ReyhaneNikoobayan/Design-Gearbox/README.md

# Designing Gearbob
The complete design of the gearbox has been accomplished in different phases throughout the machine element design 2 course, defined by [Dr. Nourani](https://sharif.ir/~nourani/) at Sharif University of Technology And it was carried out by me and my teammate Iman Shahravy.
