ReyhaneNikoobayan/Design-Gearbox/Phase 1/assignment&report/our project_gearbox.pdf

# به نام یزدان

# گزارش پروژه گیربکس )فاز اول(

## درس طراحی اجزای 2

## استاد امیرنورانی

### ریحانه نیکوبیان

### ایمان شهروی

### فهرست

طراحی چرخدنده های 1G و 3G --------------------------------------------------- 3

طراحی چرخدنده های 2G و 4G 9----------------------------------------------------

طراحی سیستم رک و پینیون14-------------------------------------------------------

طراحی چرخدنده های 5G و 6G 17----------------------------------------------------

طراحی چرخدنده های 7G و 8G 21----------------------------------------------------

تحلیل نیرویی چرخدنده ها27---------------------------------------------------------

محاسبه فاصله شفت ها 29------------------------------------------------------------

جدول جامع ویژگی های چرخدنده ها30-------------------------------------------------

روش های تثبیت چرخدنده ها در گیربکس31---------------------------------------------

انتخاب موتور الکتریکی32-------------------------------------------------------------

بررسی اتالفات موجود در پولی و چرخدنده---------------------------------------------- 34

محاسبات قیمت35-------------------------------------------------------------------

منابع37---------------------------------------------------------------------------

طراحی چرخدنده های 1G و 3G( gears spur):

فرض:1 نسبت تبدیل سیستم زنجیر و چرخ زنجیر را برابر 3.75در نظر میگیریم.)کاهنده(

ωShaft1 =3000(rpm) ×

1
3.75

=800 (rpm)

گام اول : محاسبه گشتاور
T = P
ω

→ 4kw
800×

2×π
60

= 47.73 (N.m)

* چرخدنده پینیون 1G میباشد.

Sut=700(MPa) :2 فرض

گام دوم : بدست آوردن نسبت تبدیل و انتخاب تعداد دندانه

برای شفت 2 هرگاه rpm 600=ω باشد1،G و 3G درگیر میشوند

mG =

NG
NP

=

ωP
ωG

=

800(rpm)
600(rpm)

=1.34

فرض:3 دندانه را تمام عمق فرض میکنیم.)1=K)

فرض:4 زاویه فشار را برابر 20 درجه فرض میکنیم.)20=Ø)

فرض:5 تعداد دندانه پینیون)NP )را برابر 19 در نظر میگیریم.

NG
NP

## )جلوگیری از پدیده شکارچی( 25 ≈ 24.7 = NG → 1.3 =

25
19

کمتر از 2 درصد با 1.34 فاصله دارد→ 1.315 =

گام سوم: مدول را حدس میزنیم و قطرها را محاسبه میکنیم

فرض:6 حدس اولیه برای مدول mm3=m میباشد.

m =

d
N

→ dG1 = 3×19 = 57(mm) , dG3 = 3×25 = 75(mm)

V = r×ω = ⁰.057
2

× 800 × ²×π
60

= 2.387(m/s)

فرض:7 از تراش هاب برای تولید چرخدنده استفاده شده است.

*KV را با توجه به سرعت تعیین میکنیم

3.56+√V
3.56

KV =

KV =

3.56+√2.387
3.56

→KV = 1.433

8<X<12 →
فرض:8 X را برابر 10 در نظر میگیریم.

F = X × m → F = 10×3 = 30 (mm)

گام چهارم:G)FS (را بدست میاوریم و J( ضریب هندسی( را تعیین میکنیم.

فرض:9 2=FS

فرض:10موتور الکتریکی را یونیفرم و مونتاژ را متوسط در نظر میگیریم.

(FS)G = (FS)×(Km)×(KO) →

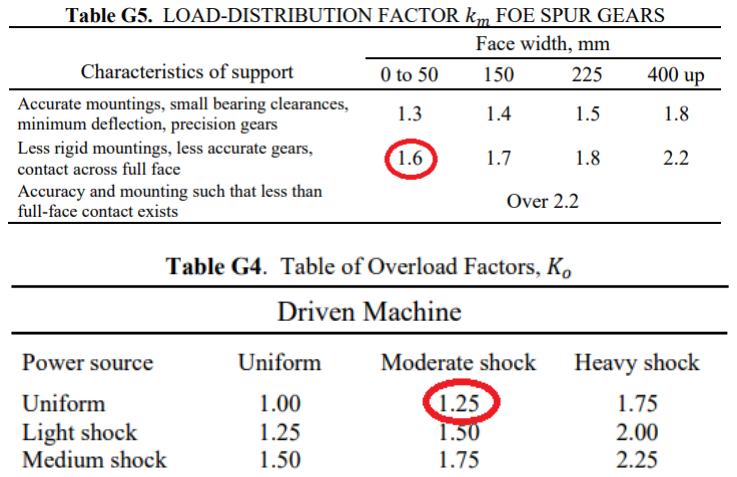
[picture p1: figure]

Km = 1.6 , Ko = 1.25 → (FS)G = 2×1.6×1.25 = 4

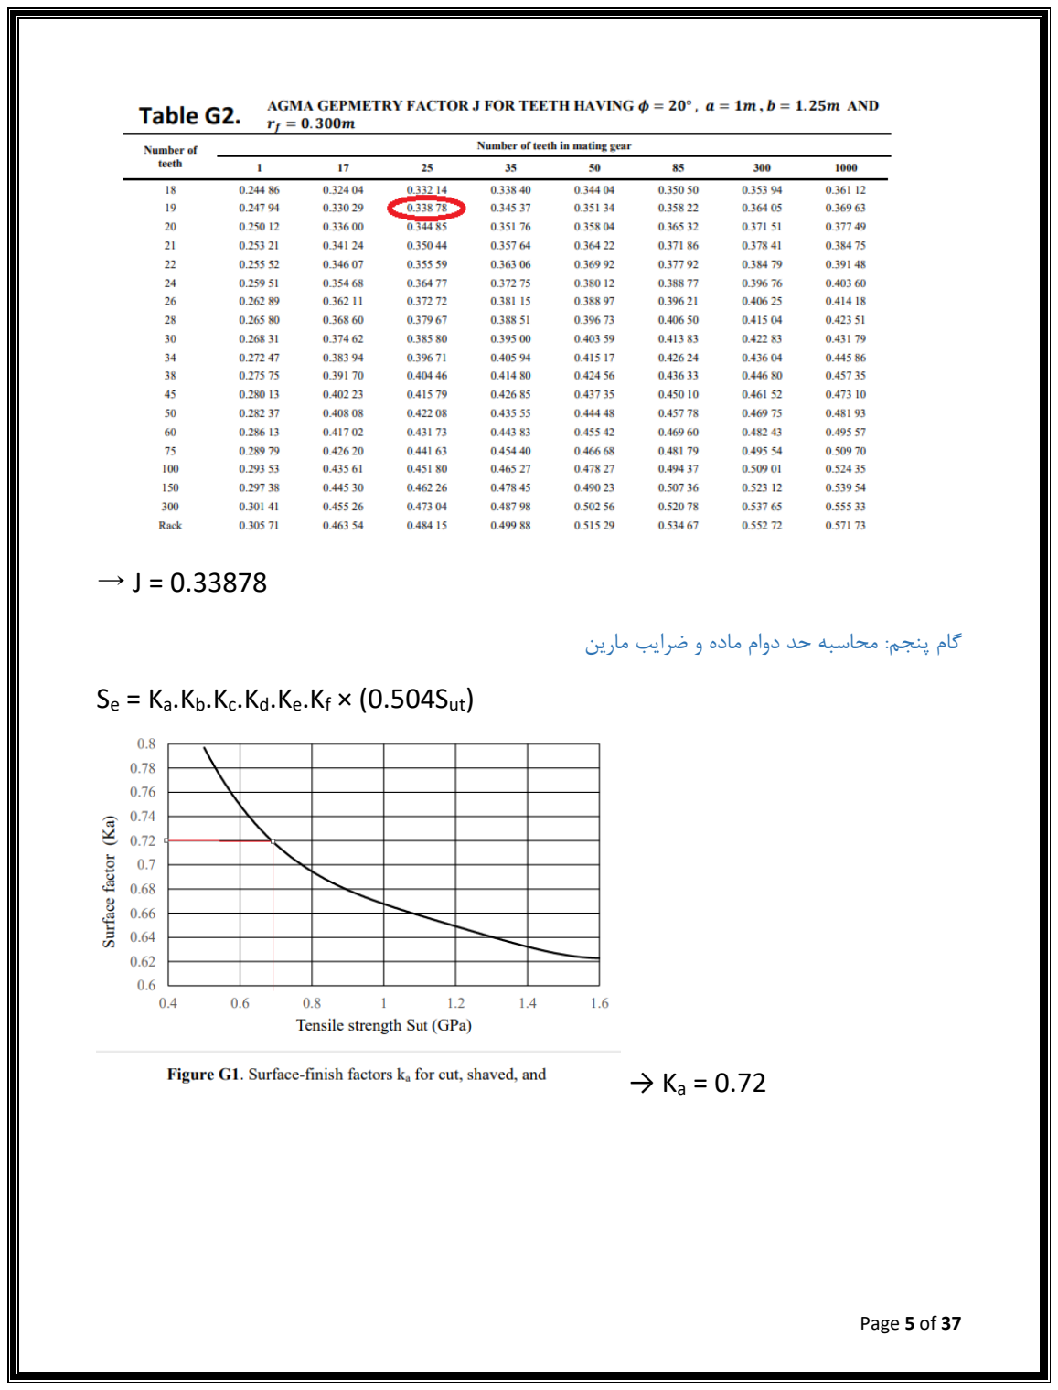
[picture p2: page 5]

→ J = 0.33878

گام پنجم: محاسبه حد دوام ماده و ضرایب مارین

Se = Ka.Kb.Kc.Kd.Ke.Kf × (0.504Sut)

→ Ka = 0.72

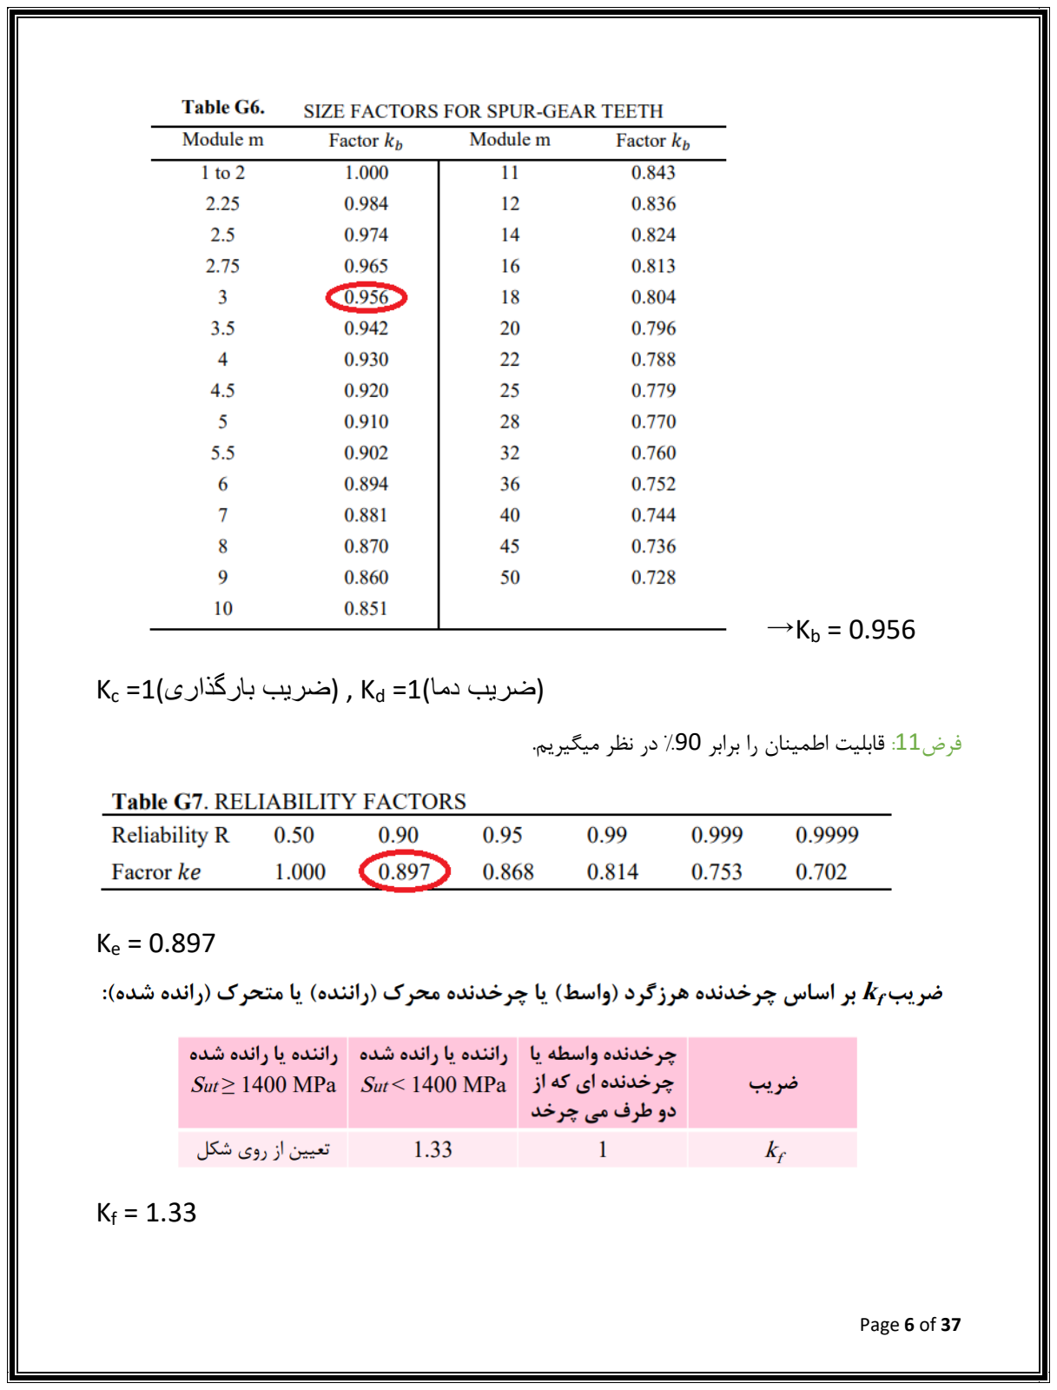
[picture p3: page 6]

→Kb = 0.956

(ضریب دما)1= Kd ,) ضریب بارگذاری)1= Kc

فرض:11 قابلیت اطمینان را برابر %90 در نظر میگیریم.

Ke = 0.897

Kf = 1.33

Se = 0.72×0.956×1×1×0.897×1.33×(0.504×700(Mpa)) = 289.7 (MPa)

گام ششم: تعیین مدول چرخدنده ساده بر اساس رابطه اول دورعلی برای ممان خمشی

m =√
2×1.433×4×47.73
289.7×19×0.33878×10

3
= 2.88(mm)

*با مدولی که حدس زدیم)3=m)،کمتر از 10 درصد تفاوت دارد پس قابل قبول است.

گام هفتم: تعیین مدول چرخدنده ساده بر اساس رابطه دوم دورعلی بر اساس تنش سطحی

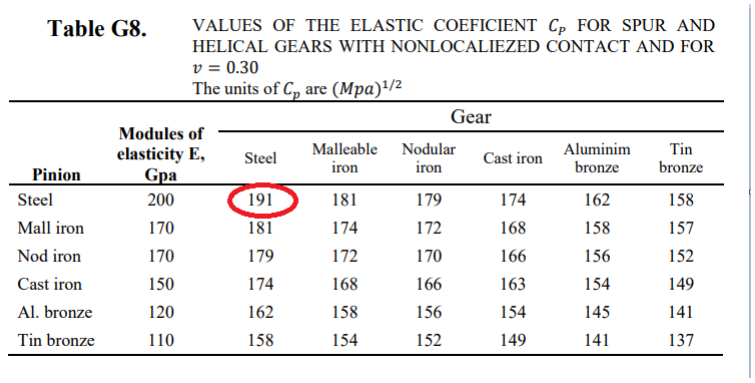
[picture p4: figure]

→ Cp = 191(√MPa)

`

→ I = 0.09

فرض:12سطح چرخدنده را در کارگاه تا 400=HB سخت میکنیم.

Ses’ = 2.75×HB – 70 = 1030

15(years) × 280(days) × 12(hours) × (60 min) × (800rpm) = 24.2×10^8 >(10^8)→

( ضریب نسبت سختی)1=CH , ) ضریب دما)1=CT , 1=CL

CR=0.8

Ses =

CLCH
CTCR

×Ses =

1030
0.8

=1287.5(MPa)

m = √
191²×2×1.433×4×47.73
1287.5

210⁶×10×19²×0.09

3
= 3.02(mm)

با مدول حدس زده شده کمتر از 10 درصد اختالف دارد و بنابراین قابل قبول است.

*پس مدول (mm(3=m برای چرخدنده های 1G و 3G انتخاب میشود.

طراحی چرخدنده های 2G و 4G) gears Helical (:

گام اول: محاسبه توان
T = P
ω

=

3.5(kw)
1000(rpm)×

2×π
60

= 33.41 (N.m)

فرض:1 زاویه فشار را برابر 20 درجه و زاویه هلیکس را برابر 13 درجه در نظر میگیریم.

( øn = 20,ψ =13 )

tan(øt) = tan(øn)
cos(ψ)

→ øt = 20.5

گام دوم: نسبت تبدیل را بدست اورده و تعداد دندانه ها را تعیین میکنیم.

ω4
ω2

=

1000(rpm)
800(rpm)

=

N2
N4

=mG = 1.25

قابل قبول 1.238 = mG) → جلوگریی از پدیده شکار چ) 24 = 2N → 19 = Np = 4N

گام سوم: حدس مدول

مدول را برابر mm3 در نظر میگیریم.

mn =3 → m =

mn
cos(ψ)

= 3.078

* در قسمت قبیل برای دو چرخدنده ساده دیدیم که (mm(66=

d1+d3
2

و در این قسمت داریم:

d2 = N2 × mn = 24 × 3.078 = 73.872 (mm)

d4 = N4 × mn = 19 × 3.078 = 58.482 (mm)

d2+d4
2

= 66.18 (mm)

بنابر این فاصله دو شفت را برابر (mm(66 در نظر میگیریم و در حالت دوم تنها mm 0.18 تفاوت داریم که قابل چشم پوشی میباشد:

V = r × ω → (

58.482
2

) × 1000 × ²×π
60

= 3.062 (m
s

)

Kv = 1.5

گام چهارم: G)FS (را بدست میاوریم.

فرض:2 موتورالکتریکی را یونیفرم و مونتاژ چرخدنده هلیکال را متوسط در نظر میگیریم.

Ko = 1.25

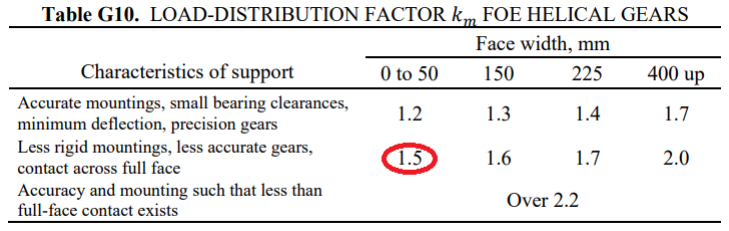
[picture p5: figure]

Km = 1.5

فرض:3 ضریب طراحی را برابر 2.5 در نظر میگیریم. (2.5=FS(

فرض:4 قابلیت اطمینان را 90 درصد در نظر میگیریم.

فرض:5 8=X را در نظر میگیریم.

(FS)G = (FS) ×(Km) × (Ko) =4.7

گام پنجم: استحکام حد دوام و ضرایب مارین را بدست میاوریم.

Se = Ka.Kb.Kc.Kd.Ke.Kf ×(0.504×Sut) → Ka = 0.72 , Kb =0.956 , Kc = 1 , Kd = 1 , Ke =0.897

Kf = 1.33

Se = 0.72×0.956×1×1×0.897×1.33×0.504×700(Mpa) = 289.71 (MPa)

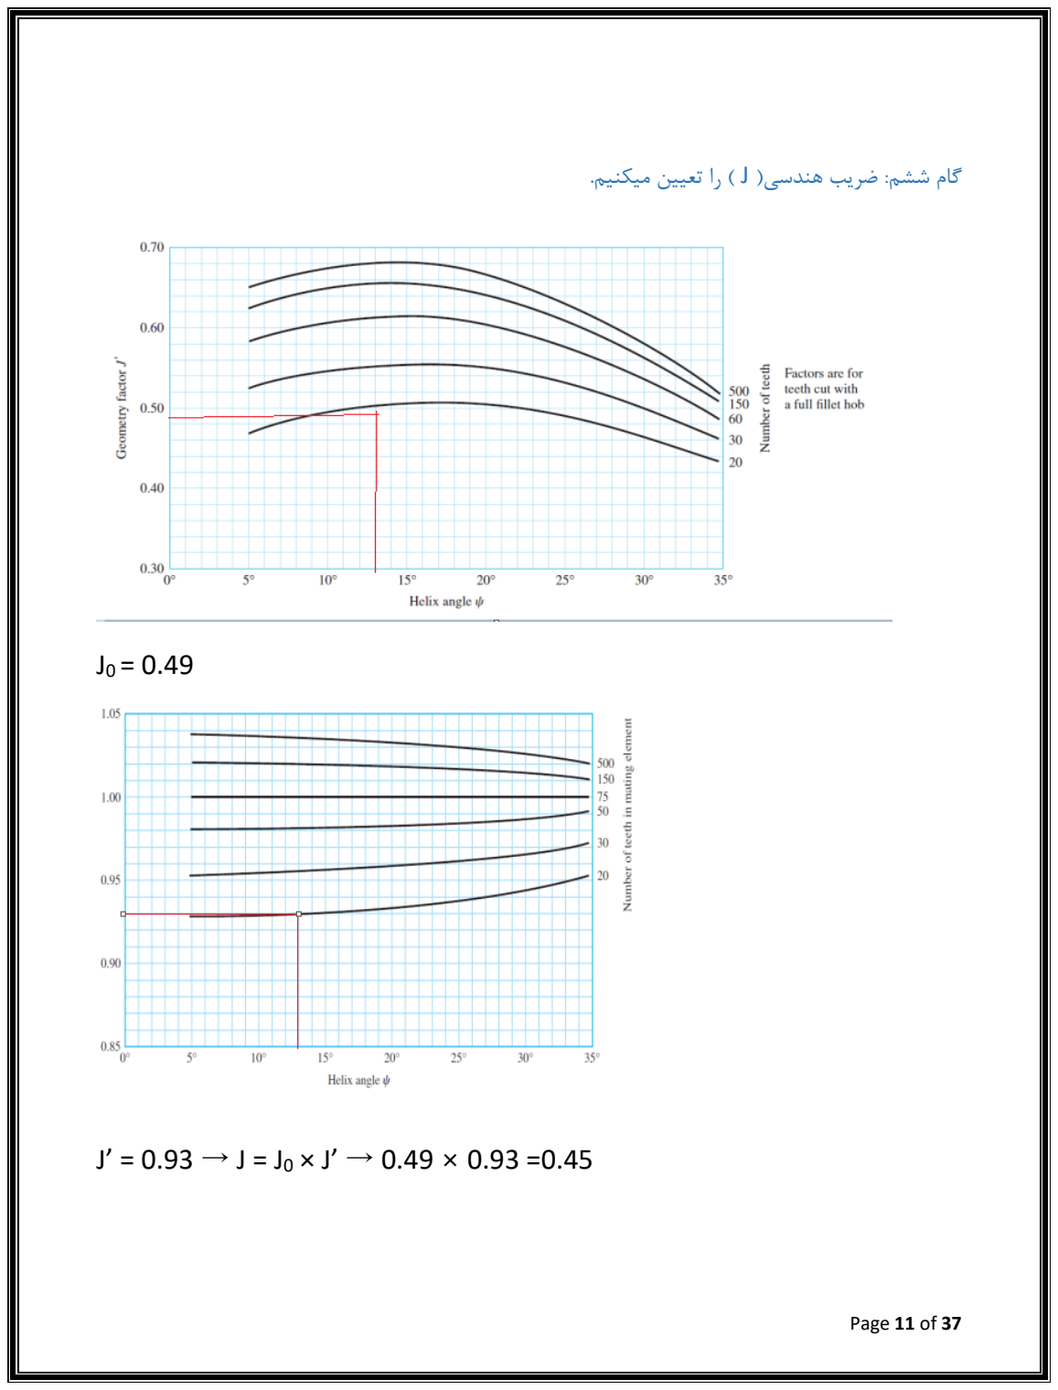
[picture p6: page 11]

گام ششم: ضریب هندسی) J ) را تعیین میکنیم.

J0 = 0.49

J’ = 0.93 → J = J0 × J’ → 0.49 × 0.93 =0.45

گام هفتم: تعیین مدول چرخدنده هلیکال بر اساس ممان خمشی)رابطه سوم دورعلی(

√
2×1.5×4.7×33.41×cos(13)

3
289.71×10⁶×19×0.45×8

3
→ mn = 2.81

کمتر از 10 درصد با مدولی که حدس زدیم فاصله دارد (3 = mn (بنابراین قابل قبول است.

گام هشتم: تعیین مدول چرخدنده هلیکال بر اساس تنش سطحی)رابطه چهارم دورعلی(

Cp = 191 √MPa

Z = mn×{√(
Np
2cosψ + 1)

2 − (

Np×cosøt
2×cosψ )

2

2

+ √(
NG
2cosψ + 1)

2 − (

NG×cosøt
2×cosψ )

2

2
–(

Np+NG
2

) ×

sinøt
cosψ}

Z = {5.67 + 6.65 – 7.72} × mn = 4.6 mn

mN =

π×cos(øn)
0.95×4.6

رعایت شد 1 > mN → 0.67=

I = cos(øt

)×sin(øt)
2×mN

×

mG
mG+1

= 0.136

فرض:6 سطح را تا 400=HB سخت کاری کرده ایم.

2.75×HB -70 = Ses’ = 1030(MPa)

CL = 1 , CH = 1 , CT = 1 , CR = 0.8

CLCH
CTCR

× Ses’ = Ses = 1287.5 (MPa)

mn = √
191²×2×1.5×4.7×33.41×cosψ³ 1287.5

2×10⁶×8×19²×0.136

3
= 2.92 (mm)

مدولی که حدس زدیم برابر (mm (3 بود و بنابراین کمتر از 10 درصد اختالف دارند و قابل قبول است.

طراحی سیستم رک و پینیون:

فرض:1 سرعت رک را برابر 20

cm
s

در نظر میگیریم.

Vrack = r×ω = 0.2 (m
s

)

فرض:2 دندانه تمام عمق و زاویه فشار برابر 20 درجه است.(1=K , 20 = ø(

*کوچکترین پینیونی که میتواند با یک شانه بدون تداخل کارکند:

2
sin(20)

2

=17.1 → NP = 18

فرض:3 مدول را برابر (mm(3.5 فرض میکنیم.

d = m×Np = 5×18=63(mm)

ω =

V
r

=

0.2
0.0315

= 6.34 (

rad
s

)

T = P
ω

=

500
6.34

= 78.75 (N.m)

فرض:4 از تراش هاب استفاده میکنیم.

Kv =

3.56+ √0.2

2

3.56

= 1.125(m
s

)

فرض:5 2=FS

فرض:6 موتور الکتریکی را یونیفرم و مونتاژ را متوسط در نظر میگیریم.

FS =2 , Ko = 1.25 , Km = 1.6 → (FS)G = 4

فرض:7 10=X

X = 10 , m=3.5 → F = X.m →F = 35 (mm)

فرض:8 قابلیت اطمینان را برابر %90 در نظر میگیریم.

تعیین ضرایب مارین همانند دو چرخدنده ساده اولیه میباشد: )تنها Kb متفاوت است(

Ka = 0.72 , Kb = 0.942 , Kc =1 ,Kd =1 , Ke =0.897 , Kf =1.33

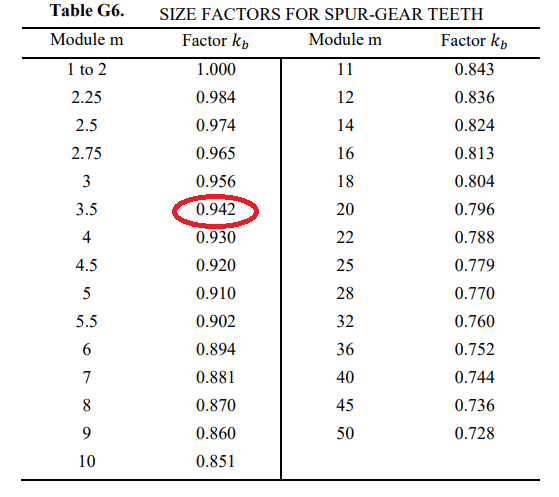
[picture p7: figure]

Se’ = 0.504 × Sut = 352.8(MPa)

Se = ka.kb.kc.kd.ke.kf × (352.8) = 285.46 (MPa)

*تعیین مدول بر اساس ممان خمشی)رابطه اول دورعلی(:

√
2×1.125×4×78.75
285.46×18×0.37×10

3
= 3.34 (mm)

*کمتر از ده درصد اختالف با مدولی که حدس زدیم ((mm(3.5=m (بنابراین مدول 3.5 قابل قبول است.

*تعیین مدول بر اساس تنش سطحی )رابطه دوم دورعلی(:

*سختی سطح را برابر 300=HB در نظر میگیریم.

Ses’ = 2.75 × 300 -70 = 755 (MPa)

Cp = 191 (√MPa)

CL = 1 , CT = 1 ,CH = 1, CR = 0.8

Ses =

CL×CH
CT×CR

=

755
0.8

= 943.75 (MPa)

I = cosøsinø
2

×

mG
mG+1

= 0.191

m = √
191²×2×1.25×4×78.75
943.75²× 10⁶×10×18²×0.191

3
= 3.61(mm)

کمتر از 10 درصد با مدولی که حدس زدیم (mm(3.5 تفاوت دارد و قابل قبول است.

طراحی چرخدنده های 5Gو 6G) Gears Helical (:

گام اول: محاسبه توان

T = P
ω

→

500
600×

2×π
60

=7.96 (N.m)

فرض:1 زاویه فشار را برابر 20 درجه و زاویه هلیکس را برابر 13 درجه در نظر میگیریم.

( øn = 20,ψ =13 )

tan (øt) = tan øn
cos ψ

→ øt = 20.5

فرض:2 نسبت تبدیل سیستم پولی و تسمه را برابر 4 در نظر میگیریم.)از نوع کاهنده( خروجی سیستم پولی متصل به پینیون در سیستم رک و پینیون بوده که ω آن مشخص است. به همین ترتیب میتوانیم ω ورودی که همان 6ω میباشد را تعیین کنیم.

ωp1

ωp2

= 4 → ωp2

= 6.34 rad
s

×

60
2×π

= 60.54 rpm → ωp1
= 242.16 (rpm)

ωG5

= ωsℎaft2 = 600 (rpm)

گام دوم: نسبت تبدیل را بدست اورده و تعداد دندانه ها را تعیین میکنیم.

mG =

ω5
ω6

≈ 2.5

= mG→ جلوگیری از پدیده شکارچی 48 = NG , 19 =Np

NG
NP

= 2.52

گام سوم: حدس مدول

مدول را برابر (mm (1.5 فرض میکنیم.

mn =1.5 → m =

mn
cosψ = 1.54

dp = 29.26 (mm) , dG = 73.92 (mm)

V = r×ω → =

29.26
2

× 600 × ²×π
60

= 0.919 (m
s

)

Kv =

3.56+ √0.919 ²

3.56

= 1.27

گام چهارم G)FS(: را بدست میاوریم.

فرض:3 موتورالکتریکی را یونیفرم و مونتاژ چرخدنده هلیکال را متوسط در نظر میگیریم.

فرض:4 ضریب طراحی را برابر 2 فرض میکنیم.

Ko = 1.25 , Km =1.5 , FS =2 → (FS)G = 1.25×1.5×2 = 3.75

فرض:5 9=X

F = X×m = 13.5(mm)

گام پنجم: استحکام حد دوام و ضرایب مارین را بدست میاوریم.

Se = Ka.Kb.Kc.Kd.Ke.Kf ×(0.504×Sut) → Ka = 0.72 , Kb =0.956 , Kc = 1 , Kd = 1 , Ke =0.897

Kf = 1.33

Se = 0.72×1×1×1×0.897×1.33×0.504×700(Mpa) = 303 (MPa)

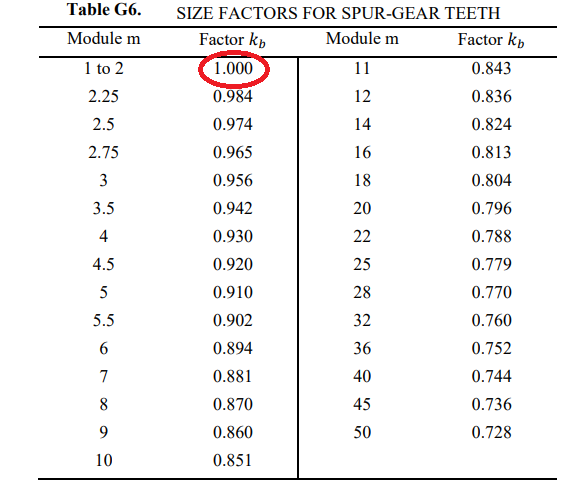
[picture p8: figure]
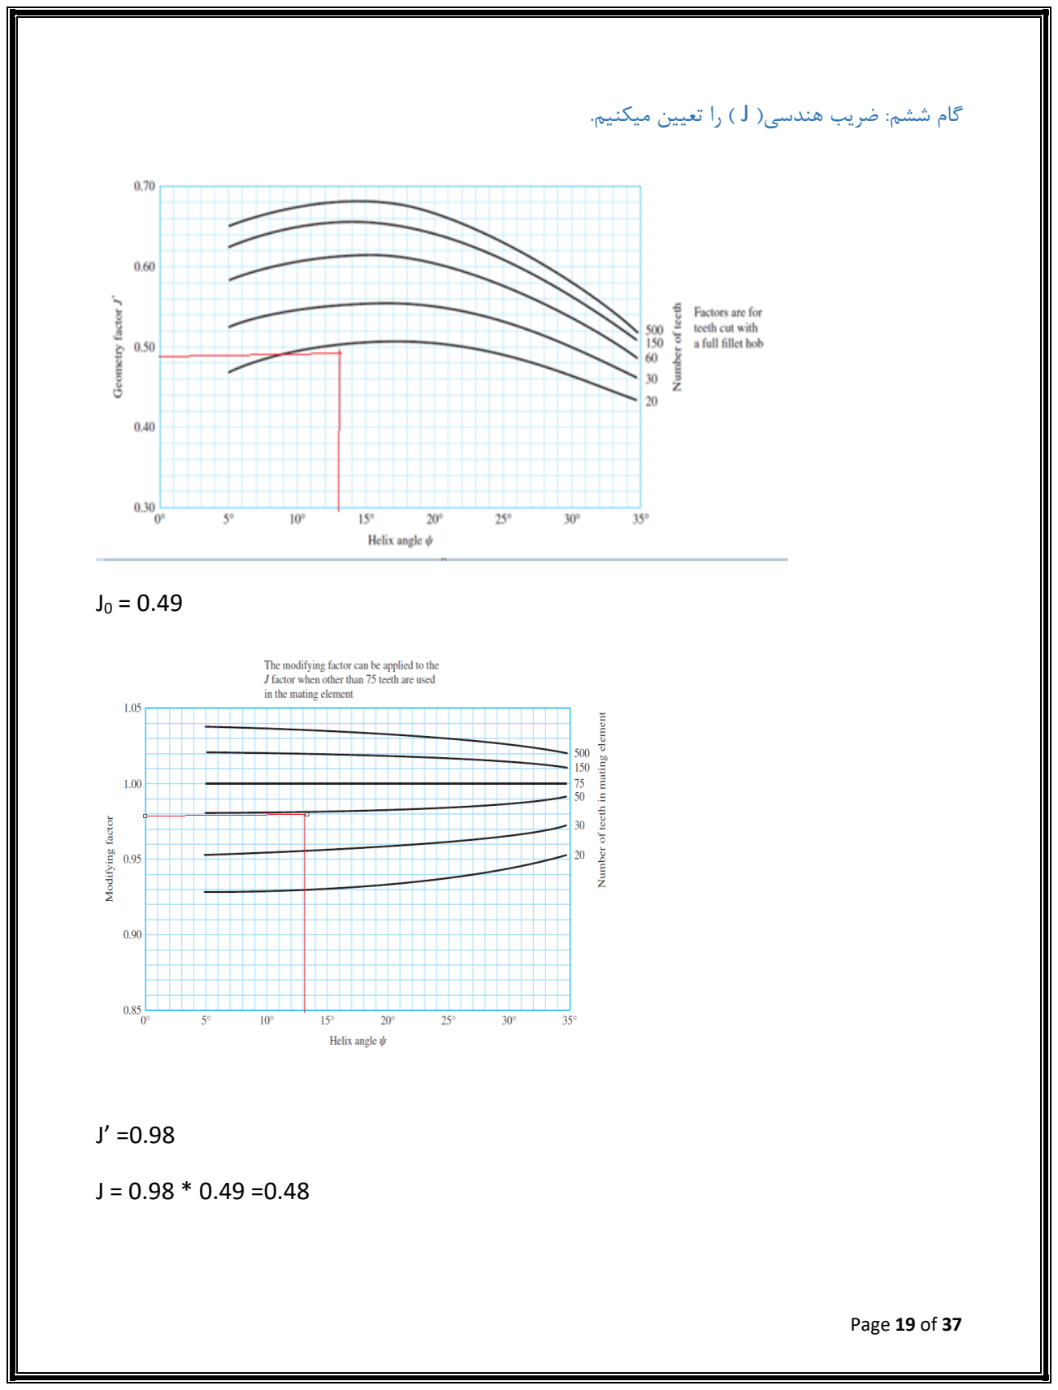
[picture p9: page 19]

گام ششم: ضریب هندسی) J ) را تعیین میکنیم.

J0 = 0.49

J’ =0.98

J = 0.98 * 0.49 =0.48

گام هفتم: تع
ش | یری مدول چرخدنده هلیکال
بر اساس ممان خم )رابطه سوم دورعیل(

√
2×1.27×3.75×7.96×cos13³
303×10⁶×19×0.48×9

3
کمتر از ده درصد تفاوت با مدولی که حدس زدیم→ (mm(1.41=

گام هشتم: تع
یری مدول چرخدنده هلیکال بر اساس تنش سطیح)رابطه چهارم دورعیل(

Cp = 191 √MPa

Z = {5.67 + 11.16 – 12.04} × mn = 4.79 mn

mN =

π×cos(øn)
0.95×4.79

=0.646

I = cosøt×sinøt
2×mn

×

mG
mG+1

= 0.117

فرض:6 سطح را تا 400=HB سخت کاری کرده ایم.

2.75×HB -70 = Ses’ = 1030(MPa)

CL = 1 , CH = 1 , CT = 1 , CR = 0.8 √
191²×2×1.27×3.75×7.96×cso13³ 1287.5

2×10⁶×9×19²×0.117

3
=1.47 →≈ 1.5 (mm)

CLCH
CTCR

× Ses’ = Ses =1287.5 (MPa)

طرایح چرخدنده های 7G و 8G) gears Bevel (:

گام اول: محاسبه گشتاور

T = P
ω

→

7kw
800×

2×π
60

= 83.55(N.m)

گام دوم: حدس مدول چرخدنده

مدول را برابر (mm(4 = m در نظر میگیریم

گام سوم: محاسبه قطر پینیون و گیر

فرض:1 تعداد دندانه پینیون را برابر 19 در نظر میگیریم.

mG =

ωG8

ωG7

=

800(rpm)
120(rpm)

= 6.67

NP =19 → NG = 19 × 6.67 ≈ 127

dp = 19 × 4 = 76 (mm) , dG = 127 × 4 = 508 (mm)

گام چهارم: محاسبه عرض چرخدنده

F = min[0.3A0 , 10m ]

10m = 10 × 4 = 40 (mm)

γ = tan⁻¹

(

NP
NG

) = 8.5° → Γ = 90 – γ = 90 – 8.5 =81.5°

A0 =

dp
2sinγ =

76
2 sin 8.5°

=257 (mm)

F = min [ 0.3×257 , 40] = 40 (mm)

گام پنجم: محاسبه حد دوام ماده

فرض:2 Sut را برابر MPa700 در نظر میگیریم.

محاسبه ضرایب مارین:

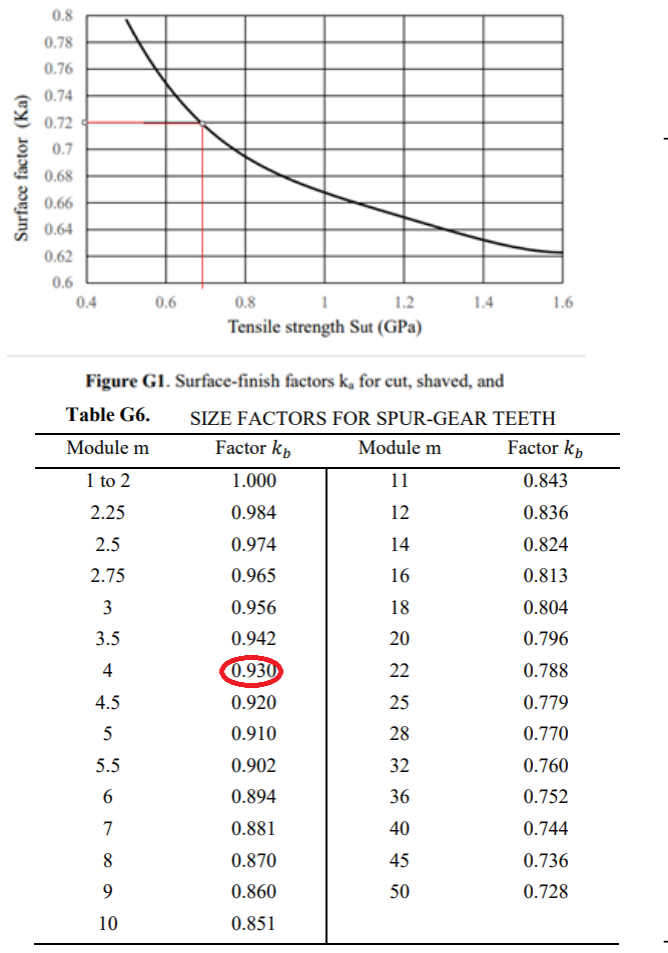
[picture p10: figure]

→ Ka = 0.72

→ Kb = 0.93

(ضرایب دما و بارگذاری) 1= Kd = Kc

فرض:3 قابلیت اطمینان را برابر %90 در نظر میگیریم

Ke = 0.897

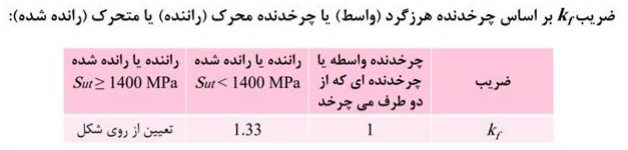
[picture p11: figure]

Kf = 1.33

Se = Ka.Kb.Kc.Kd.Ke.Kf ×(0.504×Sut) = 0.72×0.93×1×1×0.897×1.33×(0.504×700) = 281.83 (MPa)

گام ششم: به دست آوردن V و Kv و نیروي مماسی چرخدنده
V = dP
2

× ω = 0.038 × 800 × ²π
60

= 3.18 (m
s

)

فرض :4 چرخدنده با روش تراش هاب تولید شده است.

Kv =

3.56+ √3.18
3.56

= 1.5

T = Wt ×

dP
2

→ 83.55 = Wt × 0.038 → Wt = 2198.7 N

گام هفتم: تعیین ضریب ایمنی با توجه به وضعیت نصب، کارکرد و ضریب طراحی موردنیاز

فرض:5 (2= FS)

فرض:6 موتور الکتریکی را یونیفرم و مونتاژ را متوسط در نظر میگیریم.

Ko = 1.25 , Km = 1.3

(FS)G = Ko × Km × FS → (FS)G = 1.25×1.3×2= 3.25

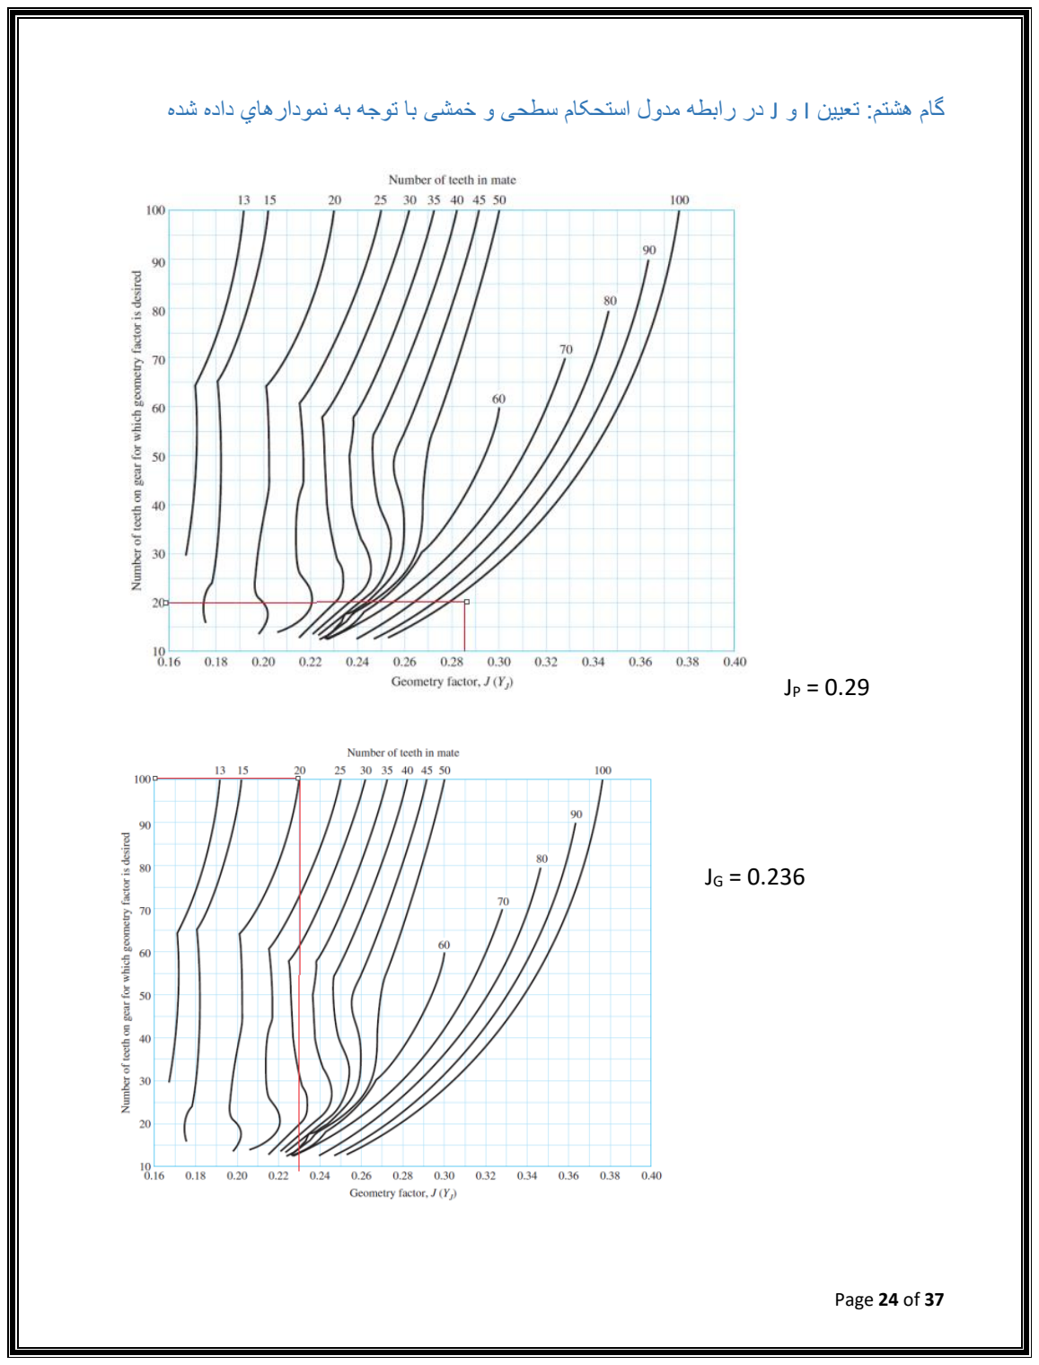
[picture p12: page 24]

گام هشتم: تعیین I و J در رابطه مدول استحکام سطحی و خمشی با توجه به نمودارهاي داده شده

JP = 0.29

JG = 0.236

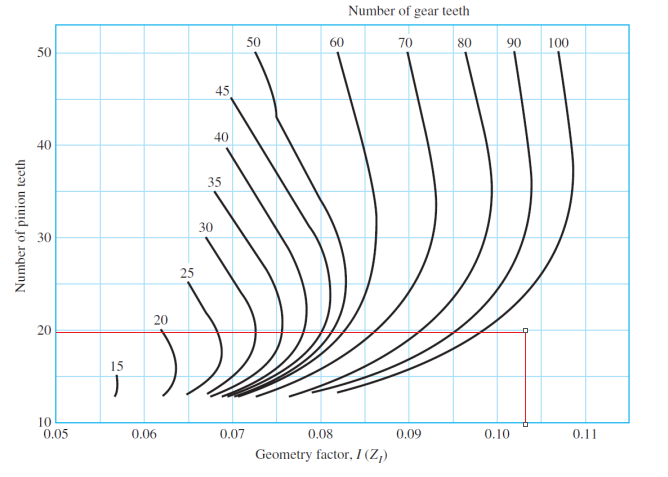
[picture p13: figure]

I = 0.104

*چون نمودار برای دندانه های گیر عدد بیشتر از 100 را شامل نمیشود،به صورت تقریبی همان حوالی 100 را در نظر گرفته ایم.

گام نهم: محاسبه Cp و به دست آوردن CL و CR از روي جدول ها و در نهایت محاسبه Ses

فرض:6 سطح را تا 300=HB سخت کاری کرده ایم.

CL = CT = CH =1 , CR =0.8

Ses’ = 2.75× 300 -70 =755 → Ses = Ses’ × 1×1
1×0.8

= 944 (MPa)

گام دهم: محاسبه ضریب ایمنی چرخدندهها و مقایسه مقدار به دست آمده با مقدار انتخابی در گام هفتم

ضریب ایمنی خمشی برای پینیون:

281.83 =

1.5×2198.7×(FS)×1.5×1.3
40×0.29×4

→ (FS)P = 2.44>2 ok

ضریب ایمنی خمشی برای گیر:

(FS)G =

JG
JP

× (FS)P = 2.03>2 ok

خستگی سطحی:

944=191× √
2198.7×(F.S)×1.5×1.3
1.5×40×76×0.104

→2.7>2 ok

تحلیل نیروهای وارد بر چرخدنده ها:

چرخدنده های 1G و 3G :

Wt =

60×10³×H

πdn

=

60×10³×4

π×800×57

= 1.67 (kN)

Wr = Wt × tan(ø) → ø = 20° → Wt = 609 (N)

چرخدنده های 2G و 4G :

Wt =

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
3500
800×

2π
60
73.872
2

= 1.13 (kN)

øn=20° , ψ =13° → øt=20.5°

-13 = ψ) → چپ گرد) 4G , 13 =ψ) → راست گرد) 2G

Wr = Wt tan(øt) = 422 (N)

Wa = Wt tan(ψ) = 261 (N)
چرخدنده های 5Gو 6G:

Wt =

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
600×

2π
60
28.5
2

= 558 (N)

øn=20° , ψ =13° → øt=20.5°

-13 = ψ) → چپ گرد) 6G , 13 =ψ) → راست گرد) 5G

Wr =Wt × tan (øt) = 208.7 (N)

Wa = Wt × tan(ψ) = 128.8 (N)
چرخدنده های 7G و 8G :

Wt =

Ti

ravp

= 1.882 (kN) , øn= 20° , У = 8.51°

Wrp = Wt × tan(øn) × cos (У) = 677(N)

Wap = Wt × tan(øn) × sin(У) = 101.3 (N) چرخدنده 11G :

Wt =

60×10³×H

πdn

=

60000×0.5
π×60.54×63

= 2.504 (kN) , ø =20°

Wr = Wt × tan (ø) = 911 (N)

محاسبه فاصله شافت ها:

برای دو چرخدنده 1G و 3G :

d1+d3
2

= 63 (mm)

برای دو چرخدنده 2G و 4G :

d2+d4
2

= 63.18 (mm)

بنابراین فاصله دو شفت 1و 2 را برابر (mm(63 در نظر میگریم و در حالت دوم تنها (mm(0.18 تفاوت داریم که با تقریب خوبی قابل چشم پوشی است و دو شفت موازی هستند.

برای دو چرخدنده 5Gو 6G :

d5+d6
2

= 51.6 (mm)

rG4 = 29.24(mm)
بنابراین فاصله دو شفت 2 و 3 را برابر (mm(51.6 در نظر میگیریم و چون شعاع چرخدنده چهارم بیشتر از 20 میلی متر با فاصله دو شفت اختالف دارد، تداخل و مشکلی از این نظر بوجود نمی آید.

جدول جامع ویژگی های چرخدنده ها:

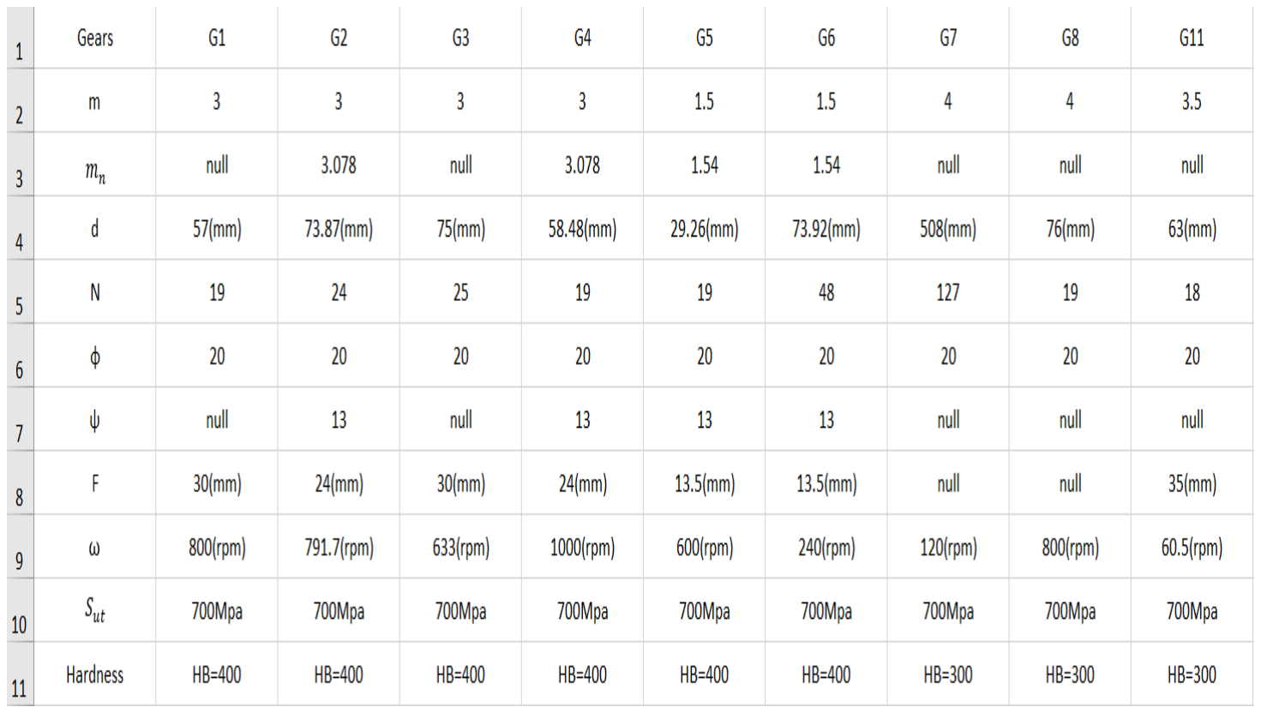
[picture p14: figure]

روشهای تثبیت چرخدنده روی شفت

برای تثبیت چرخدنده روی شفت میتوانیم از روش های متفاوتی استفاده کنیم. هر کدام از این روش ها در جای خود مفید هستند. گاهی نیاز به تثبیتی قابل تعویض داریم و گاهی میخواهیم چرخدنده را به طور دائمی روی شفت قرار بدهیم.

-1 استفاده از خار و جای خار بسیار معمول است. کمک گرفتن از پله روی شفت، بوش، خار فنری و اشپیل یا پین و واشر هم پیشنهاد میشود. همچنین اگر چرخدنده در انتهای شفت باشد میتوان از مهره و واشر یا پیچ و واشر استفاده کرد.

-2 پیچ تثبیت راهی برای تثبیت است که قابلیت تعویض چرخدنده را نیز به ما میدهد. هرچند باعث میشود عرض چرخدنده بیشتر شود و نیاز به نافی داشته باشد. می توانیم بیشتر از یک پیچ داشته باشیم که زوایای 120 درجه یا 90 درجه بین آنها پیشنهاد میشود.

-3 شرینک فیت یک راهکار دیگر برای سوار کردن چرخدنده روی شفت است. در این روش دمای چرخدنده را باال برده تا منقبض شود. این انقباض باعث بزرگتر شدن سوراخ داخل چرخدنده شده و بعد از سرد شدن و انبساط بر روی شفت تثبیت میشود .

-4 هاب چاکدار هم روشی شبیه پیچ تثبیت است. با این تفاوت که شفت ما سوراخ نمیشود و تمرکز تنش در شفت نداریم. این روش نیز نیازمند نافی بر روی چرخدنده است. میتواند یک پیچ یا بیشتر داشته باشد.

-5 همیشه این امکان هم وجود دارد که شفت و چرخدنده به صورت یکپارچه باشند. میتوانیم از متریالی با قطر بیشتر استفاده کنیم که امکان تراش چرخدنده و سپس شفت را به ما بدهد.

انتخاب موتور الکتریکی :

برای انتخاب موتور الکتریکی چند فاکتور مهم را باید در نظر بگیریم:

-1 انتخاب جنس که معموال آلومینیومی یا چدنی است.

-2 انتخاب تعداد زوج قطب های مناسب که با توجه به فرکانس برق باعث مشخص شدن دور نامی میشود.

-3 انتخاب کالس بازدهی مناسب که نسبت توان خروجی به توان نامی را تغییر میدهد.

این دستگاه قرار است در یک خط تولید یک کارخانه به کار گرفته شود. میتوانیم نتیجه بگیریم که

الف( در شرایط دمایی اندکی باالتر از دمای اتاق قرار دارد.

ب( در صورت خرابی موتور الکتریکی خط تولید تمام کارخانه متوقف میشود و به نسبت حجم کاری، ضرر گستردهای به کارخانه وارد خواهد شد. پس در صورت خرابی باید بتوانیم به سادگی موتور جدیدی را جایگزین کنیم.

انتخاب جنس

با توجه به اینکه باید از موتورهای معمول استفاده کنیم تا هم هزینهها کاهش یابد هم قابلیت تعویض در اسرع وقت را داشته باشیم، به دو جنس اصلی الکتروموتورهای معمول بازار یعنی آلومینیوم و چدن میپردازیم.

از مزایای الکتروموتور چدنی نسبت به آلومینیومی میتوان به تحمل توان های باال اشاره کرد. چدن به علت تحمل باالتری که در تحمل تنش دارد، میتواند برای تولید الکتروموتورهای پر توان بدون بروز مشکل کار کند. همچنین چدن عایق خوبی برای حرارت است و همین قضیه باعث میشود در شرایط آب و هوایی سرد به الکتروموتورهای چدنی رو بیاوریم.

در مقابل استفاده از آلومینیوم هم در شرایط دیگری پیشنهاد میشود. آلومینیوم فلزی سبک تر است و وزن موتور الکتریکی را نسبت به چدن کمتر میکند. آلومینیوم انتقال حرارت بهتری از چدن دارد و در هوای گرمتر می تواند الکتروموتور را خنک نگه داشته و به عمر آن بیافزاید.

در این دستگاه توان مورد انتظار ما متوسط است؛ پس محدودیتی از این بابت نداریم. همچنین دمای محیط کار باید مناسب کارگرها هم باشد. فلذا در دمایی متوسط هم قرار داریم. به همین منظور الکتروموتور اقتصادی تر را انتخاب میکنیم. با توجه به بررسی قیمت این دو نوع، الکتروموتور آلومینیومی قیمت پایین تری داشت و انتخاب ما برای این شرایط است.

انتخاب کالس بازدهی موتور

به علت استفاده معمولی از موتور و عدم نیاز به ضریب اطمینان باال، از موتورهایی با راندمان معمولی استفاده میکنیم. چون باید موتور الکتریکی در دسترس باشد و بعد اقتصادی را نیز باید در نظر بگیریم، از موتور های الکتریکی ساخت موتوژن تبریز استفاده میکنیم. کاتالوگ موتور های ساخت این شرکت به پیوست اضافه میشود. کالس مناسب انتخاب شده از این کاتالوگ، الکتروموتور سه فاز صنعتی تک دور با فریم آلومینیومی است. در این کالس الکتروموتور اگر توان نامی 15 کیلووات را انتخاب کنیم با توجه به بازده %88.7 توان واقعی 13.3 کیلووات را به ما ارائه میکند. این توان اندکی بیشتر از توان مورد نیاز ما در این دستگاه است. فلذا موتور 160B2L را انتخاب میکنیم.

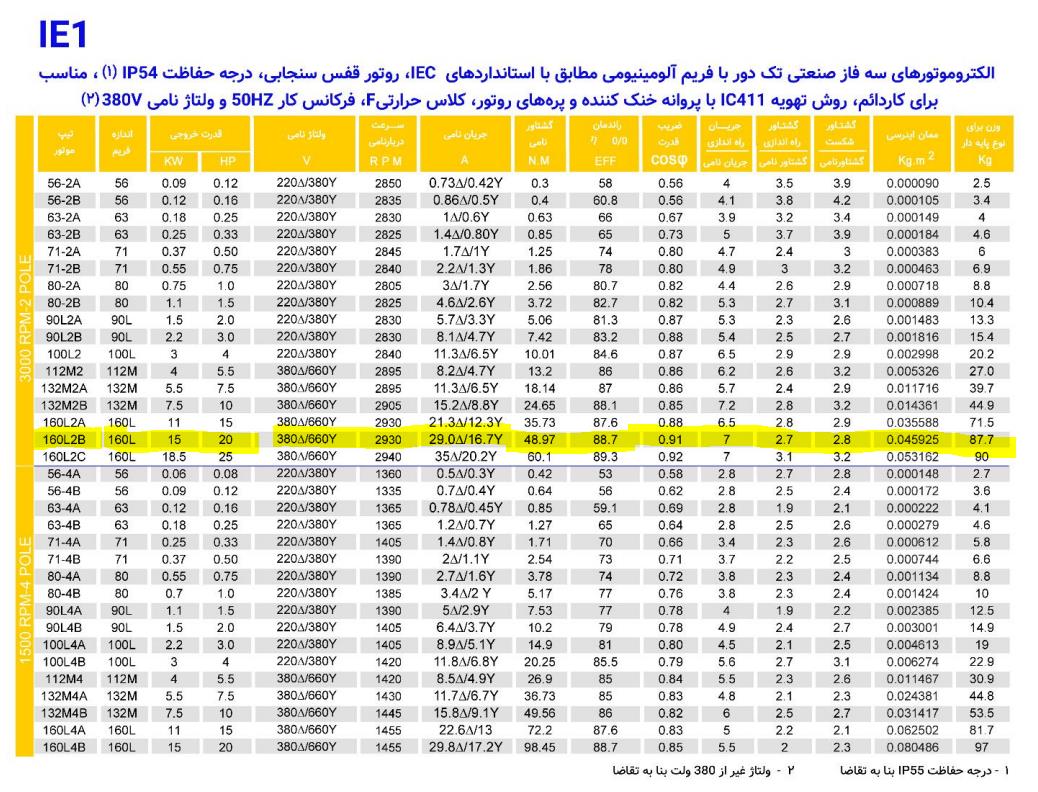
[picture p15: figure]

بررسی اتالفات موجود در پولی و چرخ زنجیر:

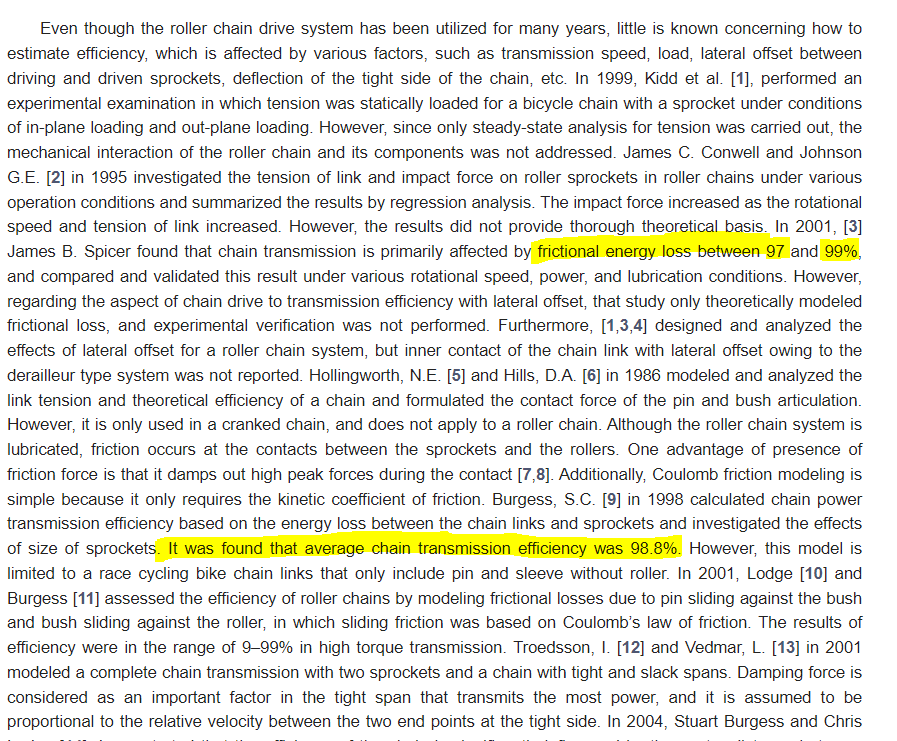
[picture p16: figure]

با توجه به مقاله باال به آدرس /876558com.mdpi.www://https بازده چرخ زنجیر را برابر 99 درصد و چون معموال بازده پولی کمتر از سیستم چرخ زنجیر میباشد و لقی در سیستم پولی و تسمه داریم، برابر 95 درصد در نظر میگیریم. بنابراین توان کل سیستم با توجه به بازده 88.7 درصدی موتور برابر میشود با:

15kW× 0.887×0.99×0.95 = 12.5 kW
در این تحلیل ما بازده چرخدنده ها را برابر 100 و بدون اتالف در نظر گرفته ایم.

محاسبات قیمت :

برای ساخت چرخدنده ها به تراش کاری با هاب و سخت کردن سطح دندانه ها نیاز داریم. طبق قیمتی که سایت خدمات سنجاق مشخص کرده این فرایند برای هر جفت چرخدنده به طور میانگین حدود 350 هزار تومان میشود که برای 5 جفت چرخدنده ما یک میلیون و هفتصد و پنجاه هزار تومان هزینه دارد.

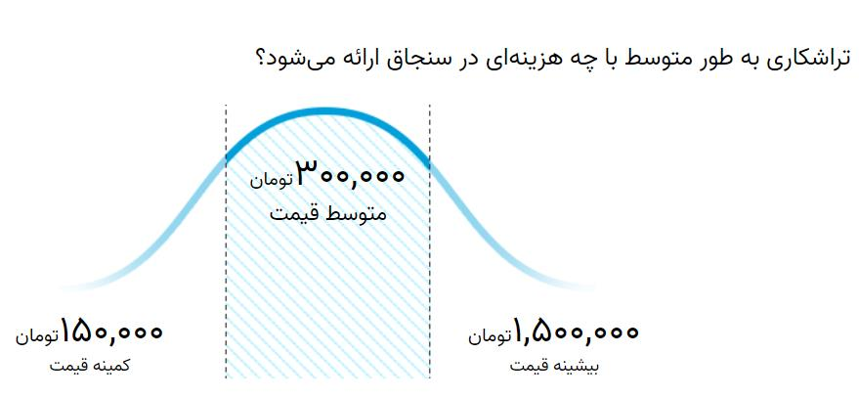
[picture p17: figure]

برای ساخت چرخدنده ها از فوالد 150VCN یزد استفاده میکنیم که به صورت استوانه ای و در قطر های مختلف در بازار موجود است. با توجه به عرض دندانه ها، مجموع عرض دندانه های چرخدنده های ما بجز 7G که قطر بسیار بزرگی دارد، کمتر از (mm(300 میشود که همان 300 را در نظر میگیریم. بنابر این قطر

استوانه برابر (mm(100 و طول استوانه (mm(300 میباشد.

V = π

d

2

4

× h = 0.002356 (m³
)
k | چگالی آهن را برابر 8000
m³

در نظر میگیریم:

m1 = 8000×V ≈ 19(kg)
برای 7G نیز قطر را برابر (mm(600 و طول را (mm(50 در نظر میگیریم.

m2 = 8000× π ×

d

2

4

× h = 113(kg)

m total = 132(kg)

طبق قیمت بازار امروز در 25 آبان طبق سایت com.shahrahan هر کیلوگرم فوالد باال حدود 112 هزار تومان قیمت دارد:

تومان 14,784,000= 112000 × 132

بنابراین هزینه کلی برابر:

تومان 16,600,000 ≈ 16,534,000 = 14,784,000+1,750,000

## منابع

جزوه استاد نورانی [1]

mdpi.com [2]

sanjagh.pro [3]

esfahanahan.com [4]

shahrahahn.com [5]

ahanpakhsh.com [6]

faramechanic.com [7]
کاتالوگ های کارخانه زنجیرسازی طهرانچی [8]

shigley's mechanical engineering design [9]

motogen.com [10]

siemens.com [11]

Machine Design (An Integrated Approach) , Robert L. Norton, 3rd edition [12]

machine elements in mechanical design, Robert L. Mott, 4th edition [13]

yazdrollingmill.com [14]

technotav.com [15]

goalelectric.ir [16]
