ReyhaneNikoobayan/Design-Gearbox/Phase 2/assignment&report/project_final2.pdf

به نام یزدان

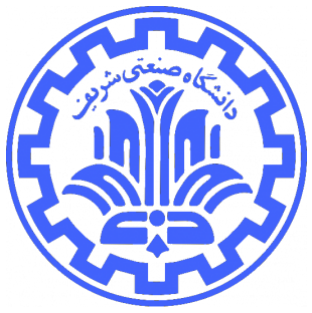
[picture p18: figure]

دانشکده مهندسی مکانیک

فاز دوم پروژه گیربکس

استاد درس:دکتر امیرنورانی

نگارش

ریحانه نیکوبیان 99106747

ایمان شهروی 98106661

Dec-2021

فهرست

تعریف پروژه و خالصه ای از روند طراحی | 5
فرضیات | 7
شفت اول | 8
حالت اول | 8
تحلیل نیرویی | 8
دیاگرام های ممان و تورک | 9
حالت دوم | 11
تحلیل نیرویی | 11
دیاگرام های ممان و تورک | 12
حالت سوم | 13
تحلیل نیرویی | 13
دیاگرام های ممان وتورک | 15
شفت دوم | 16
حالت اول | 16
تحلیل نیرویی | 16
دیاگرام های ممان و تورک | 17
حالت دوم | 19

تحلیل نیرویی | 19
دیاگرام های ممان و تورک | 20
شفت سوم | 21
تحلیل نیرویی | 21
دیاگرام های ممان و تورک | 22
طراحی شفت | 24
شفت اول | 27
محاسبات قطر | 27
طول خار | 28
شفت دوم | 30
محاسبات قطر | 30
طول خار | 31
شفت سوم | 32
محاسبات قطر | 32
طول خار | 33
برینگ های زیر چرخدنده های هرزگرد | 34
طراحی برینگ های اصلی | 35
نحوه تثبیت قطعات | 44
نحوه تلرانس گذاری | 45
محاسبات قیمت | 46

.1 تعریف پروژه و خالصه ای از روند طراحی:

در فاز قبلی چرخدنده های گیربکس را طراحی کردیم و در این فاز قصد داریم که شفت 1 شامل چرخدنده های 1G و 2G و 7G و همچنین شفت 2 که چرخدنده های 3G و 4G و 5G روی آن قرار دارند و در نهایت شفت سوم شامل چرخدنده 6G را طراحی کنیم. بخش دوم طراحی مربوط به طراحی برینگ های گیربکس میباشد. روی شفت 1 برینگ های 11B و 12B در پوسته اول قرار گرفته اند و همچنین برینگ های 13B و 14B روی این شفت قرار دارند که در پوسته دوم میباشند.
روی شفت دوم برینگ های 21B و 22B قرار گرفته اند. برینگ های31B و 32B نیز روی شفت سوم قرار دارند. نکته مهم اینجاست که چون سیستم دارای سه حالت کاری میباشد، باید در هر حالت برخی از چرخدنده ها درگیر و بقیه آن ها هرزگرد باشند بنابراین باید زیر چرخدنده هایی که میخواهیم در برخی حاالت هرزگرد باشند،برینگ قرار دهیم.
با توجه به این م وضوع، برینگ های 1B و 2B زیر چرخدنده های یک و دو روی شفت یک و همچنین برینگ 6B روی شفت سوم زیر چرخدنده شش قرار میگیرد. در بخش نهایی طراحی به سراغ، طراحی پوسته گیربکس میرویم. روند طراحی به این شکل بوده که در فاز قبل چرخدنده ها را طراحی کردیم.در اینجا ابتدا تحلیل نیرویی چرخدنده ها را انجام داده ایم. با استفاده از این تحلیل ها و مراحل طراحی شفت، شفت های 1 تا 3 را طراحی کرده ایم و در انتها با استفاده از نتایج دو مرحله قبلی،برینگ های مناسب را برای دستگاه بدست اوردیم. برای تثبیت دورانی و محوری این قطعات از پله و انواع خار استفاده کرده ایم. تمامی فرضیات و راه حل ها به صورت گام به گام آورده شده و نقشه قطعات و کاتالوگ های مورد نیاز به همراه تلرانس قطعات در پیوست آورده شده است. سیستم دارای سه حالت زیر میباشد:

شماتیک طرح پروژه در صفحه بعدی ارایه شده است:

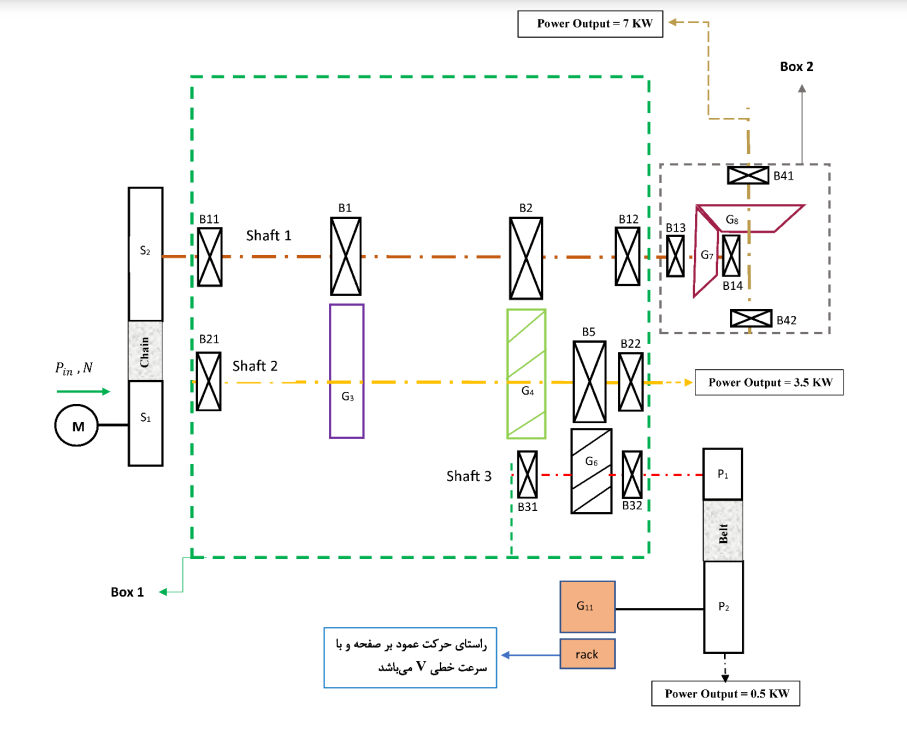
[picture p19: figure]

.2فرضیات:
-1قطر چرخ زنجیر برابر cm50 میباشد.

-2شفت اول به صورت دو تکه تحلیل نیرویی میشود.

-3 جنس شفت ها و چرخ زنجیر از 45ck میباشد که ویژگی های آن به صورت زیر است:

Sy =370 Mpa , Su = 630 Mpa
-4 .شفتها با تراشکاری ساخته شده اند.

-5 خارها با فرز انگشتی ساخته شده اند.

-6 بارگذاری مالیم انجام میشود.

-7 دمای کاری پایین تر از 150 درجه است.

-8 گیربکس قرار است برای دو شیفت 6 ساعته و به مدت 15 سال کارکند.

.3 تحلیل نیرویی چرخدنده ها و بارگذاری روی شفت:

شفت-1حالت اول:

*برای اینکه شرایط نامعین برای تحلیل استاتیکی شفت بوجود نیاید،طبق نظر دستیار محترم آموزشی،شفت یک را به دو قسمت تقسیم کرده و تحلیل میکنیم. قسمت اول شفت -1حالت اول :
با توجه به اطالعات فاز قبل پروژه، سرعت دورانی شفت 1 برابر rpm800 و توان انتقال داده شده به شفت در این حالت توسط چرخ زنجیر برابر W7000 میباشد. T = P
ω

=

7000
800×

2π
60

= 83.56 (N.m)

F = ²×T
D

=

2×83.56
0.5

نیروی وارد شده توسط چرخ زنجیر به چرخ در حالت اول: (N (334.24=

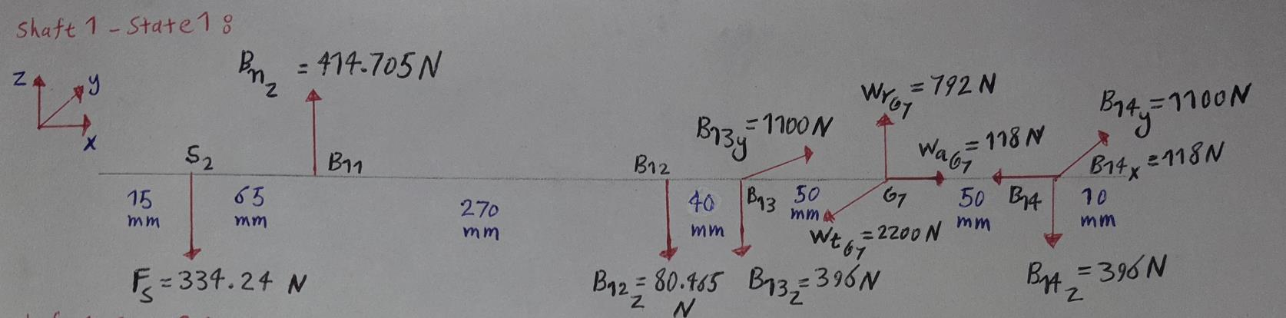
[picture p20: figure]

∑Fz = 0 → B11z − 334.24 − B12z = 0

∑My = 0 → (334.24)(65) − (B12z )(270) = 0

B12z = 80.465 N , B11z = 414.705 N
قسمت دوم شفت-1 برای هر سه حالت یکسان میباشد: برای چرخدنده مخروطی 7G داریم ) با توجه به اطالعات فاز قبلی پروژه(

Wt =

Ti

ravp

=

83.56
A0 sinγ =

83.56
0.257 × sin (8.5)

= 2200 (N)

Wrp = Wt

tan∅n cosγ = 2.2 × tan 20 × cos 8.5 = 792 (N)

شکل -1دیاگرام آزاد شفت-1 حالت اول

Wap = Wt

tan ∅n sin γ =2.2 × tan 20 × sin 8.5 = 118 (N)

ازتقارن داریم:

B13z = B14z = 396 (N)

B13y = B14y = 1100 (N)

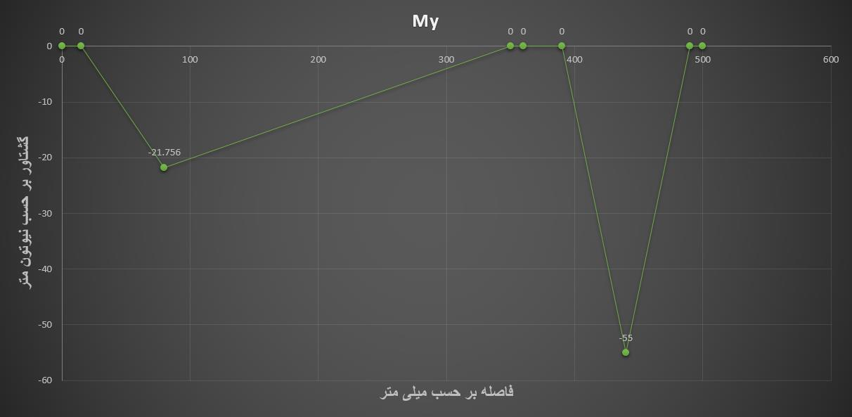
[picture p21: figure]

یش | نمودار -1 وارد برشفت اول در راستای
گشتاورخم Y-حالت اول

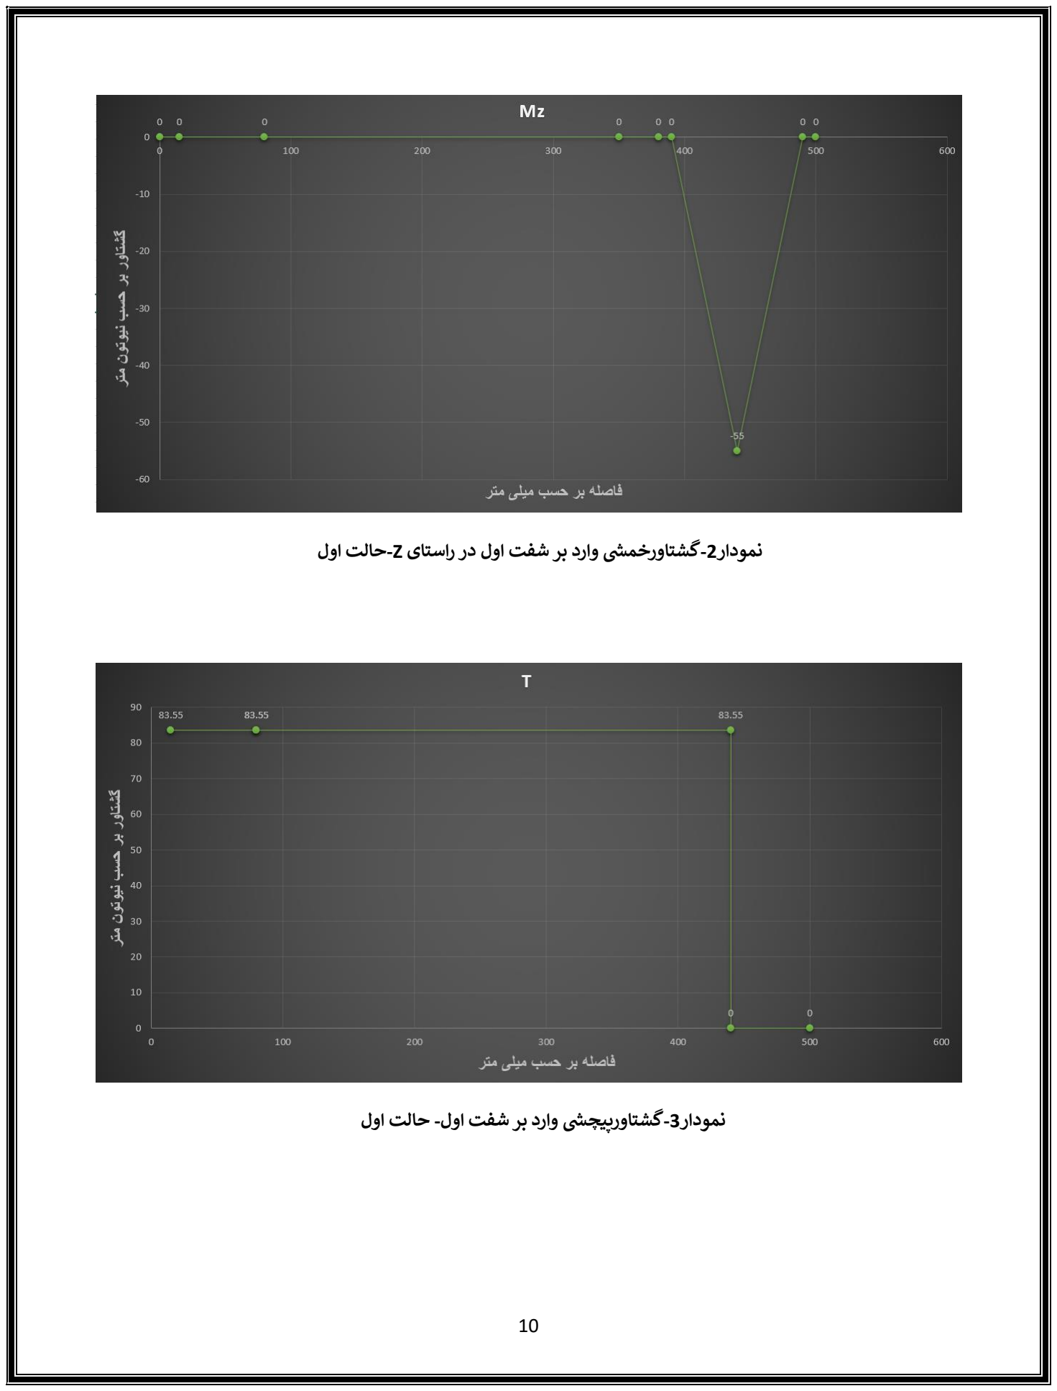
[picture p22: page 10]

یش | نمودار -2 وارد برشفت اول در راستای
گشتاورخم Z-حالت اول
یش | نمودار -3گشتاور
پیچ وارد بر شفت او ل- حالت اول

شفت-1حالت دوم:

با توجه به اطالعات فاز قبل پروژه، سرعت دورانی شفت 1 برابر rpm 800 و توان انتقال داده شده به شفت در این حالت توسط چرخ زنجیر برابر W11000 میباشد .

T =

P
ω

=

11000
800×

2π
60

= 131.31 (N.m)

F = ²T
D

=

2×131.31
0.5

= 525.24 (N)

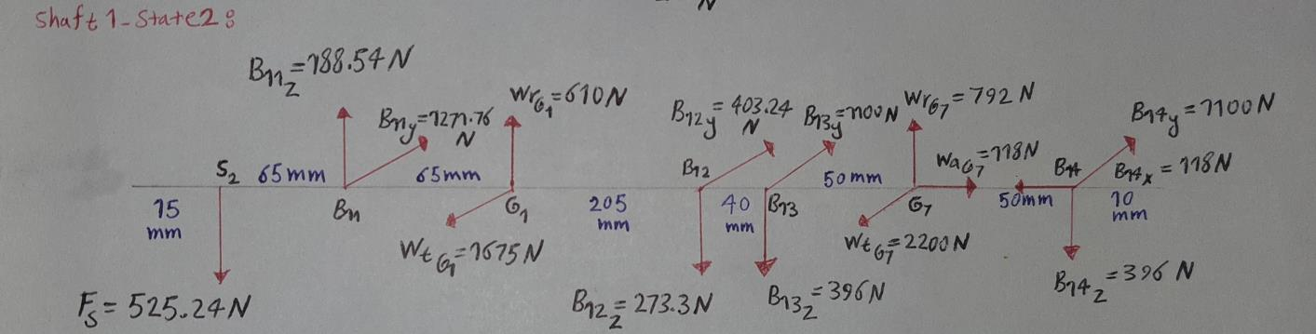
[picture p23: figure]

برای چرخدنده ساده داریم:

Wt =

60000 × H
π dn

H=4kW,d=57,n=800,∅=20
→ | Wt = 1675 (N)

Wr = Wt

tan ∅ = 610 (N)

∑My = 0 → (525.24)(65) + (610)(65) + (B12z
| )(270) = 0
∑Fz = 0 → 610 + B12z − 525.24 + B11z = 0

B11z = 188.54 (N) , B12z = -273.3 (N)

∑Mz = 0 → (270)(B12y) − (1675)(65) = 0

∑Fy = 0 → (B11y + B12y − 1675 = 0

B11y = 1271.76 (N) , B12y = 403.24 (N)

شکل -2دیاگرام آزاد شفت-1 حالت دوم

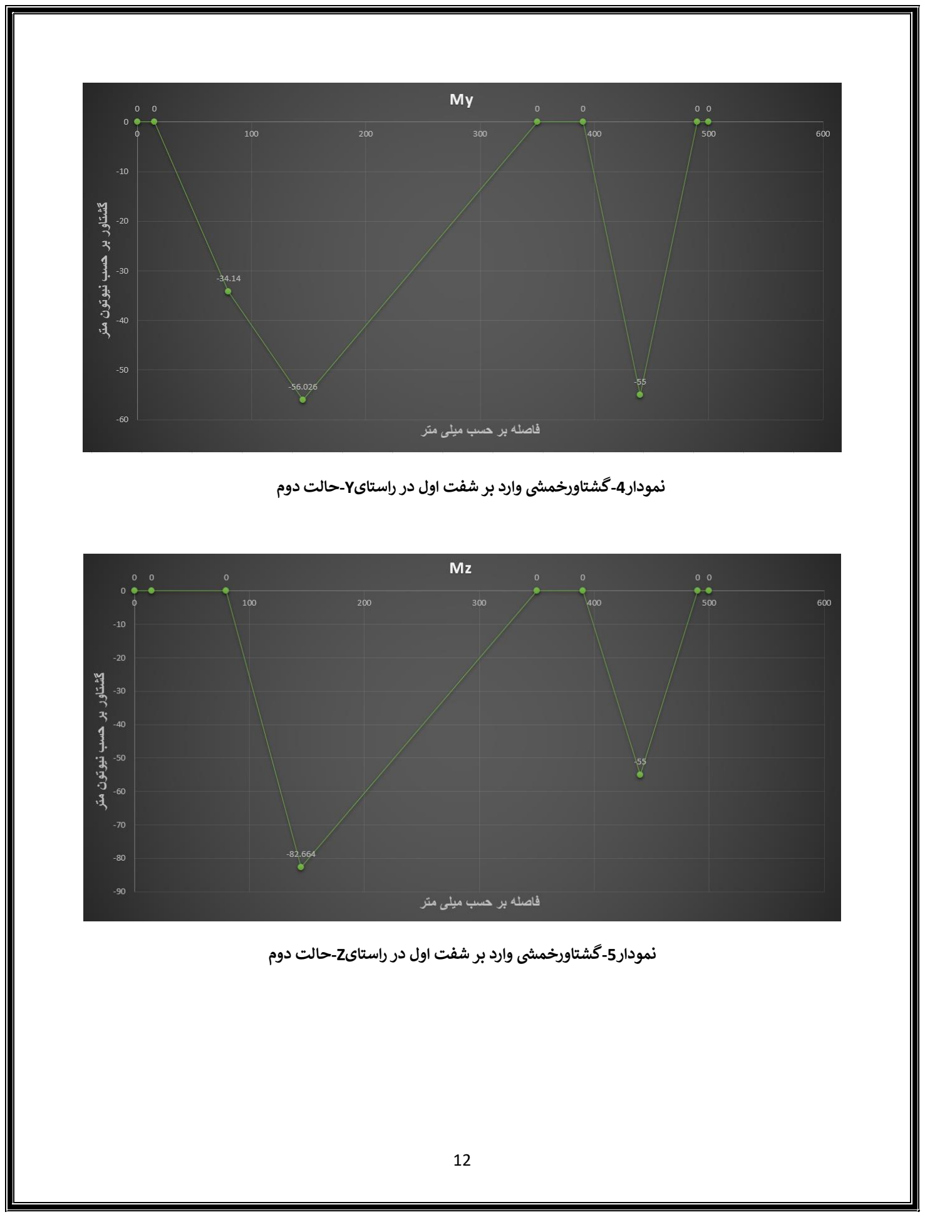
[picture p24: page 12]

یش | نمودار -4 وارد برشفت اول در راستای
گشتاورخم Y-حالت دوم
یش | نمودار -5 وارد برشفت اول در راستای
گشتاورخم Z-حالت دوم

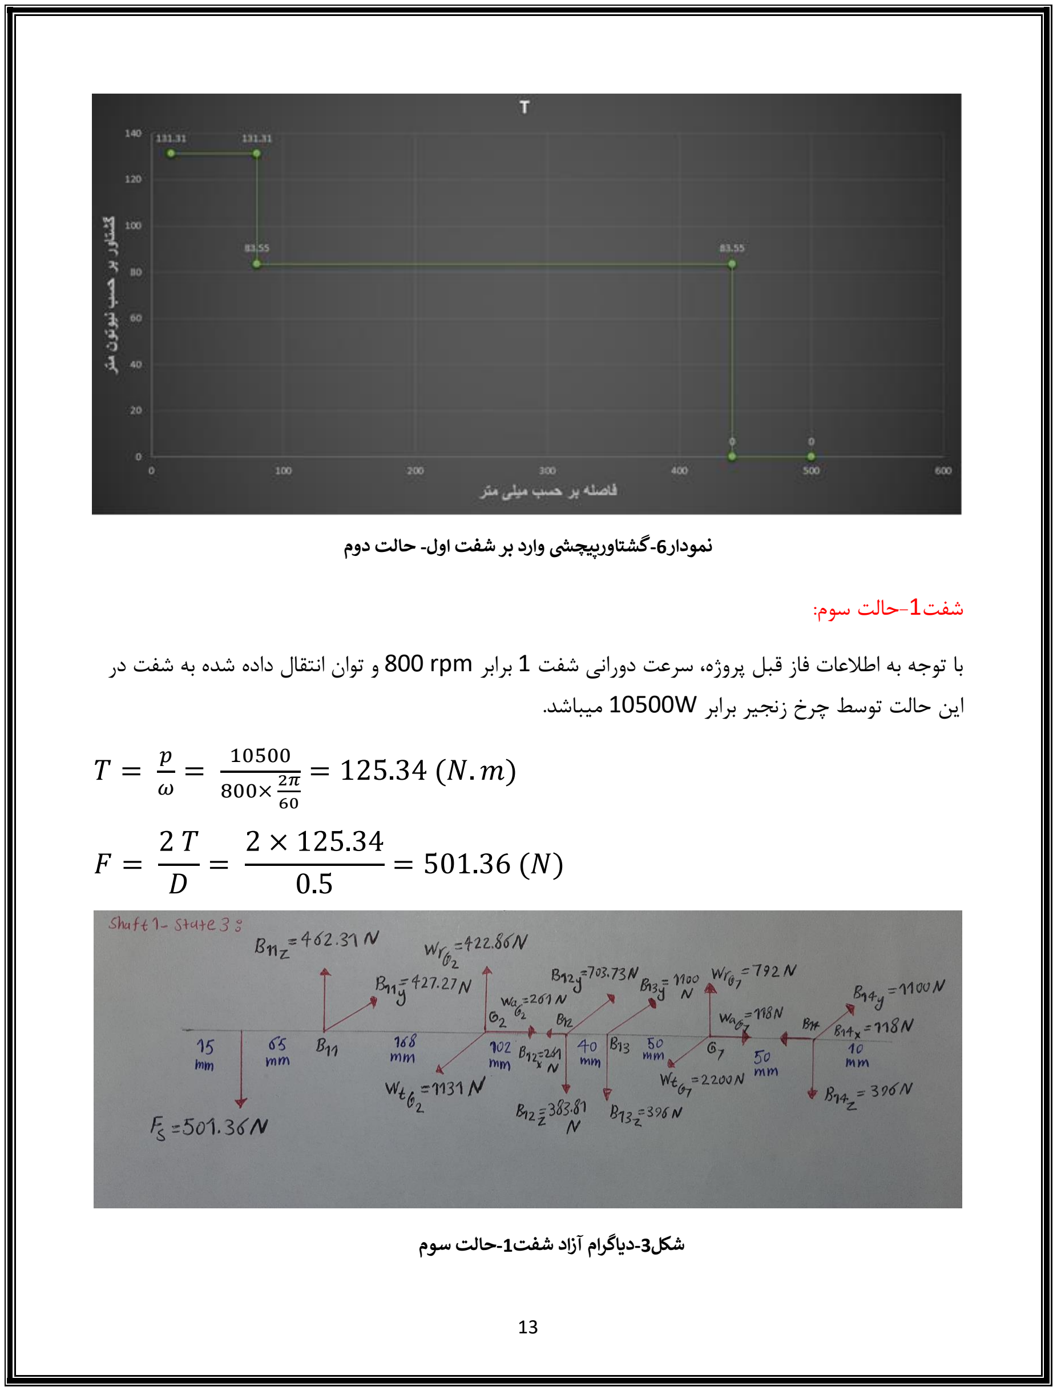
[picture p25: page 13]

شفت-1حالت سوم:

با توجه به اطالعات فاز قبل پروژه، سرعت دورانی شفت 1 برابر rpm 800 و توان انتقال داده شده به شفت در این حالت توسط چرخ زنجیر برابر W10500 میباشد .

T =

p
ω

=

10500
800×

2π
60

= 125.34 (N. m)

F =

2 T
D

=

2 × 125.34
0.5

= 501.36 (N)

یش | نمودار -6 وارد برشفت اول
گشتاورپیچ - حالت دوم

شکل -3دیاگرام آزاد شفت-1 حالت سوم

برای چرخدنده هلیکال داریم:

Wt =

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
3500
800×

2π
60
73.872
2

= 1131 (N)

Wr = Wt

tan ∅t = 422.86 (N)

Wa = Wt

tan ψ = 261 (N)

∅t = 20.5° , ψ = 13°

∑My = 0 → (501.36)(65) + (422.86)(168) − (B12z )(270) = 0
∑Fz = 0 → B11z − B12z + 422.86 − 501.36 = 0

B11z = 462.31 (N) , B12z = 383.81 (N)

∑Mz = 0 → (B12y)(270) − (1131)(168) = 0

∑Fy = 0 → B11y − 1131 + B12y = 0

B11y = 427.27 (N) , B12y = 703.73 (N)

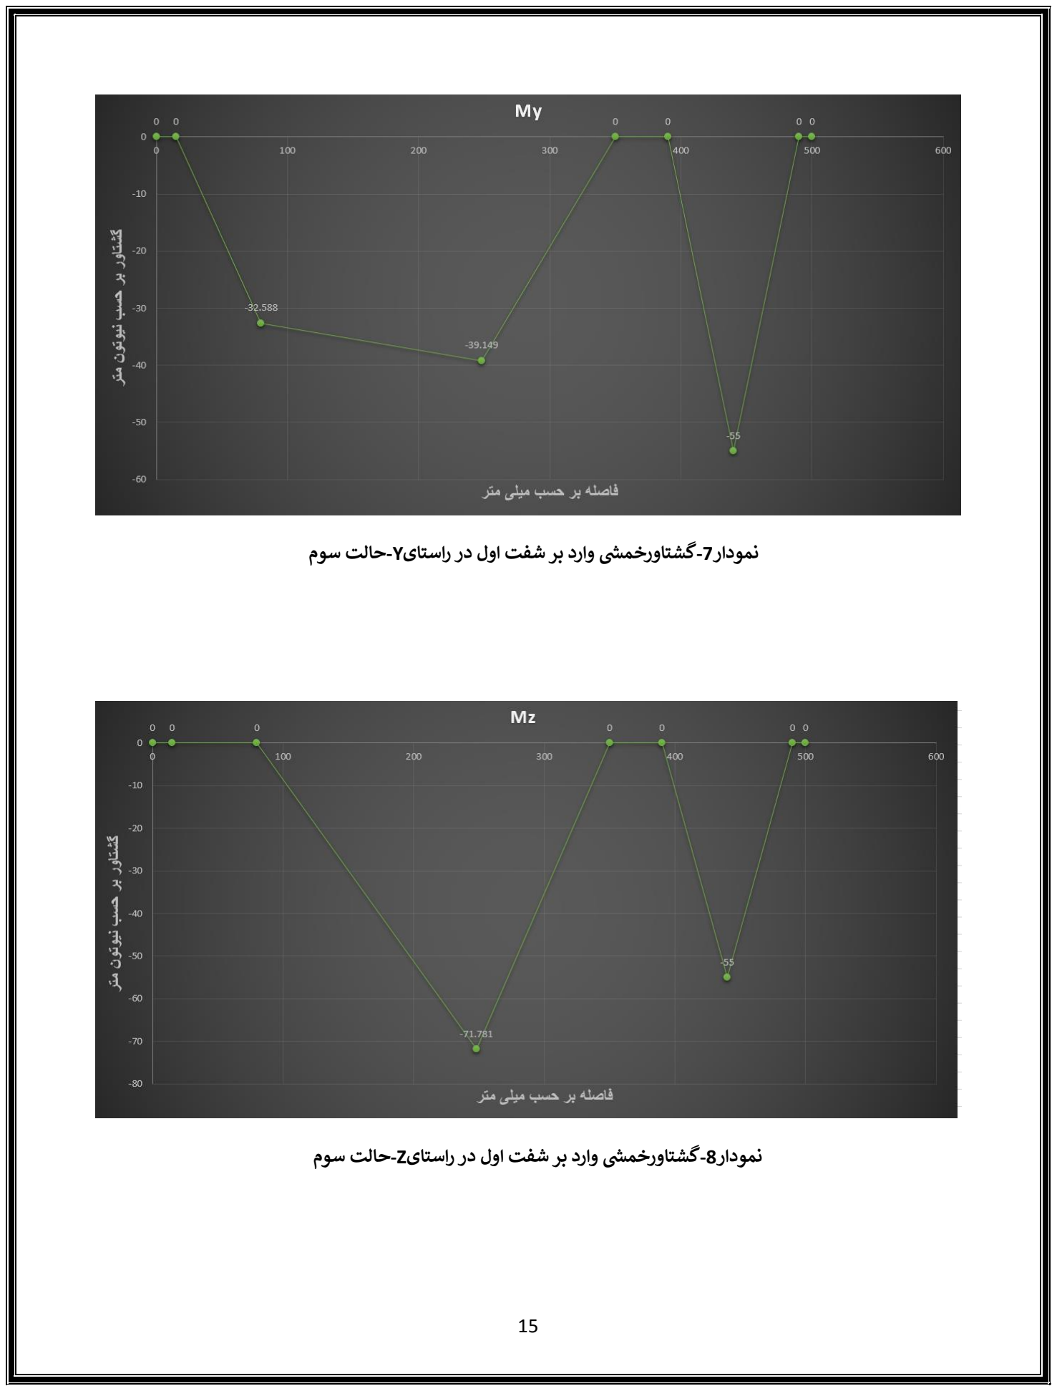
[picture p26: page 15]

یش | نمودار -7 وارد برشفت اول در راستای
گشتاورخم Y-حالت سوم
یش | نمودار -8 وارد برشفت اول در راستای
گشتاورخم Z- حالت سوم

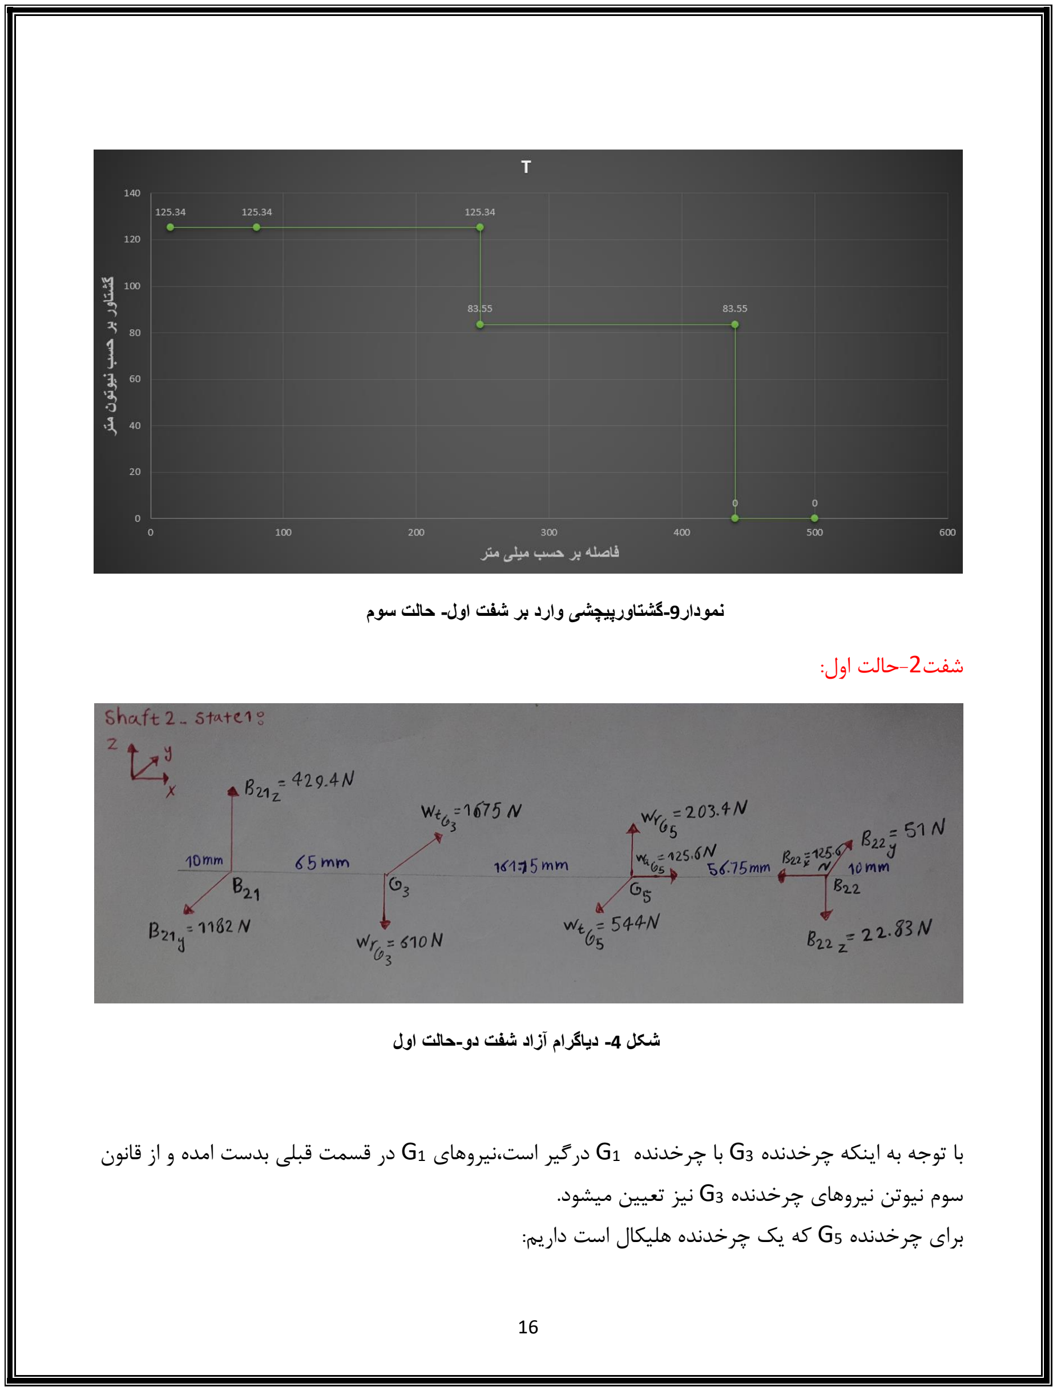
[picture p27: page 16]

شفت-2حالت اول:

با توجه به اینکه چرخدنده 3G با چرخدنده 1G درگیر است،نیروهای 1G در قسمت قبلی بدست امده و از قانون سوم نیوتن نیروهای چرخدنده 3G نیز تعیین میشود. برای چرخدنده 5G که یک چرخدنده هلیکال است داریم:

نمودار-9گشتاورپیچشی وارد بر شفت اول- حالت سوم

شکل -4 دیاگرام آزاد شفت دو-حالت اول

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
600 ×

2π
60
29.26
2

= 544(N) = Wt

Wr = Wt

tan ∅t = 203.4 (N) , Wa = Wt
tanψ = 125.6 (N)

∑My = 0 → (203.4)(226.75) − (610)(65) − (B22z )(283.5) = 0
∑Fz = 0 → B21z + 203.4 − 610 − B22z = 0

B21z = 429.4 (N)

B22z = 22.83 (N)

∑Mz = (1675)(65) − (544)(226.75) + (B22y)(283.5) = 0

∑Fy = 0 → 1675 − 544 + B22y − B21y = 0

B21y = 1182 (N)

B22y = 51 (N)

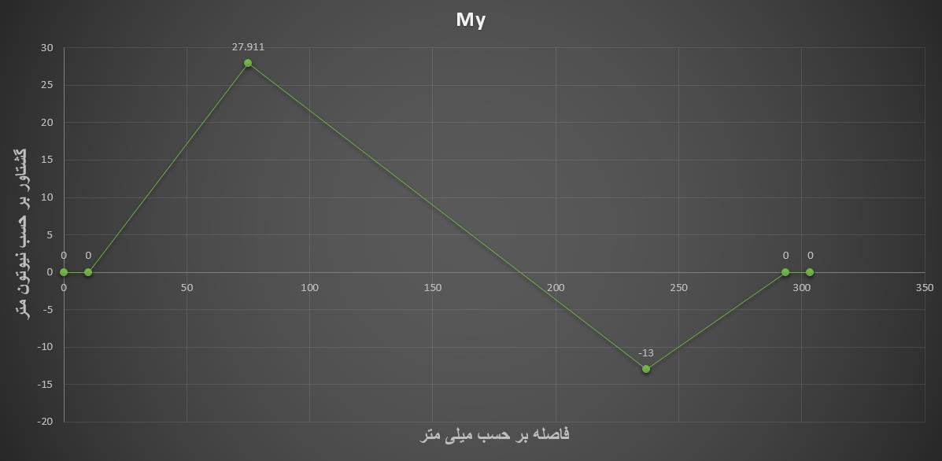
[picture p28: figure]

یش | نمودار -10 وارد برشفت
گشتاورخم دوم در راستا یY-حالت اول

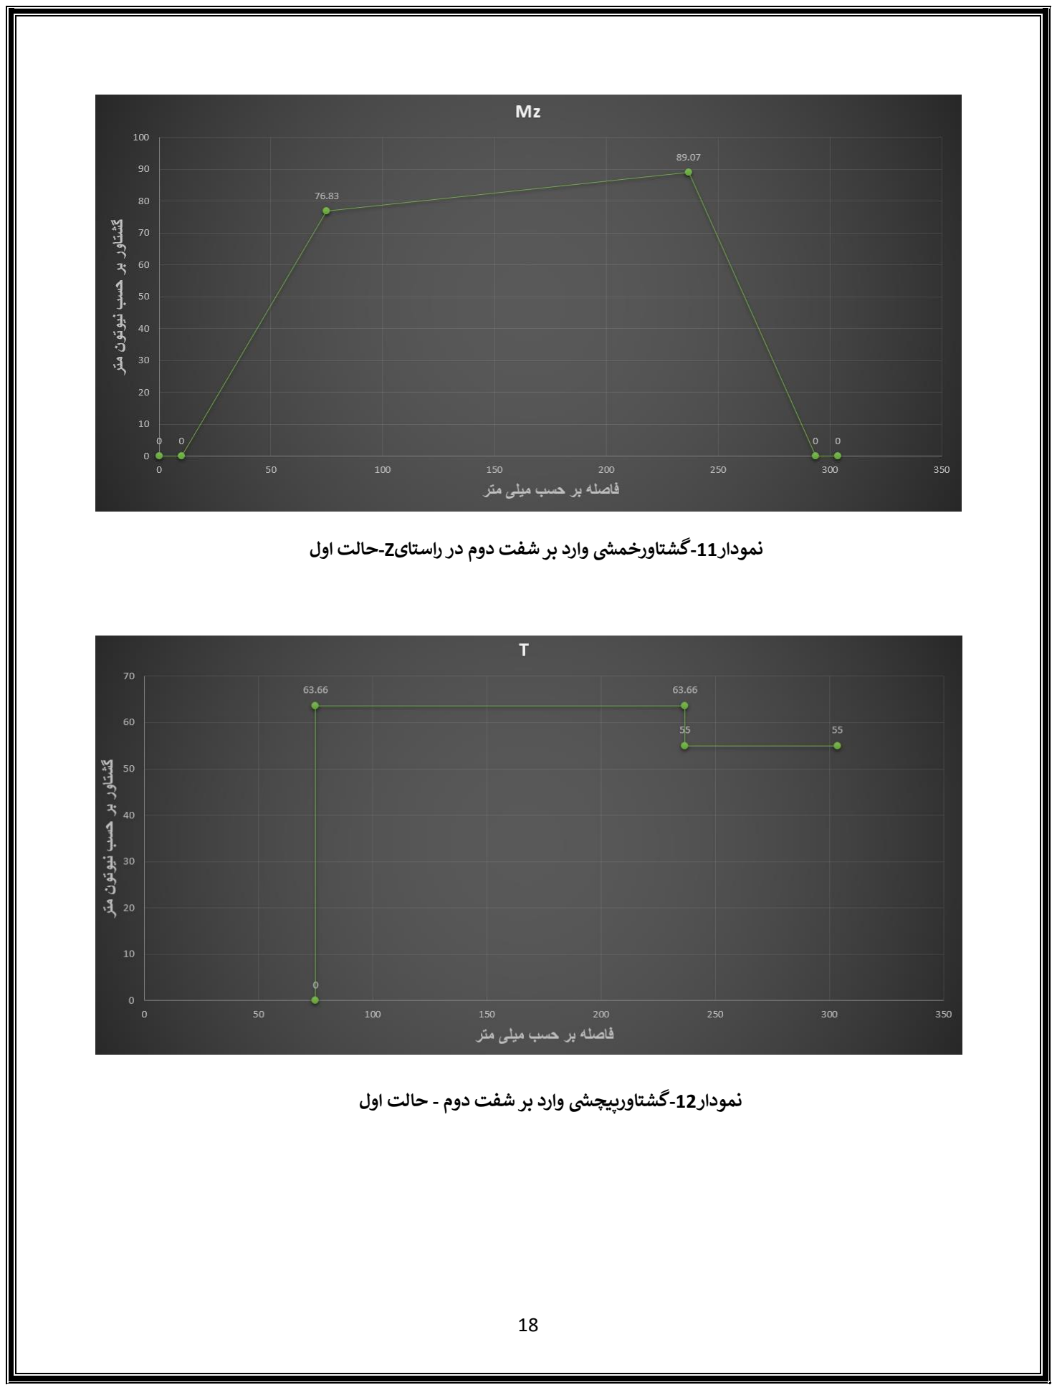
[picture p29: page 18]

یش | نمودار -11 وارد برشفت
گشتاورخم دوم در راستایZ-حالت اول
یش | نمودار -12 وارد برشفت
گشتاورپیچ دوم - حالت اول

شفت-2حالت دوم:

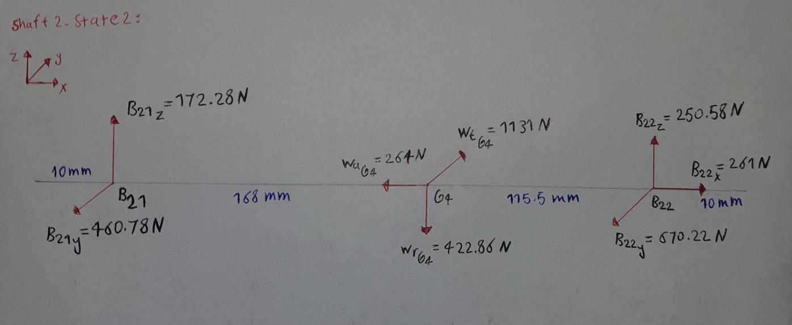
[picture p30: figure]

با توجه به ای نکه چرخدنده 4G با چرخدنده 2G درگیر است،نیروهای 2G در قسمت قبلی بدست امده و از

قانون سوم نی وتن ن یروهای چرخدنده 4G ن یز تعیی ن م یشود .

∑My = 0 → (422.86)(168) − (B22z )(283.5) = 0

∑Fz = 0 → B21z − 422.86 + 250.58 = 0

B21z = 172.28 (N)

B22z = 250.58 (N)

∑Mz = 0 → (1131)(168) − (B22y)(283.5) = 0

∑Fy = 0 → 1131 − B21y − 670.22 = 0

B21y =460.78 (N)

B22y = 670.22 (N)

شکل -5 دیاگرام آزاد شفت دو- حالت دوم

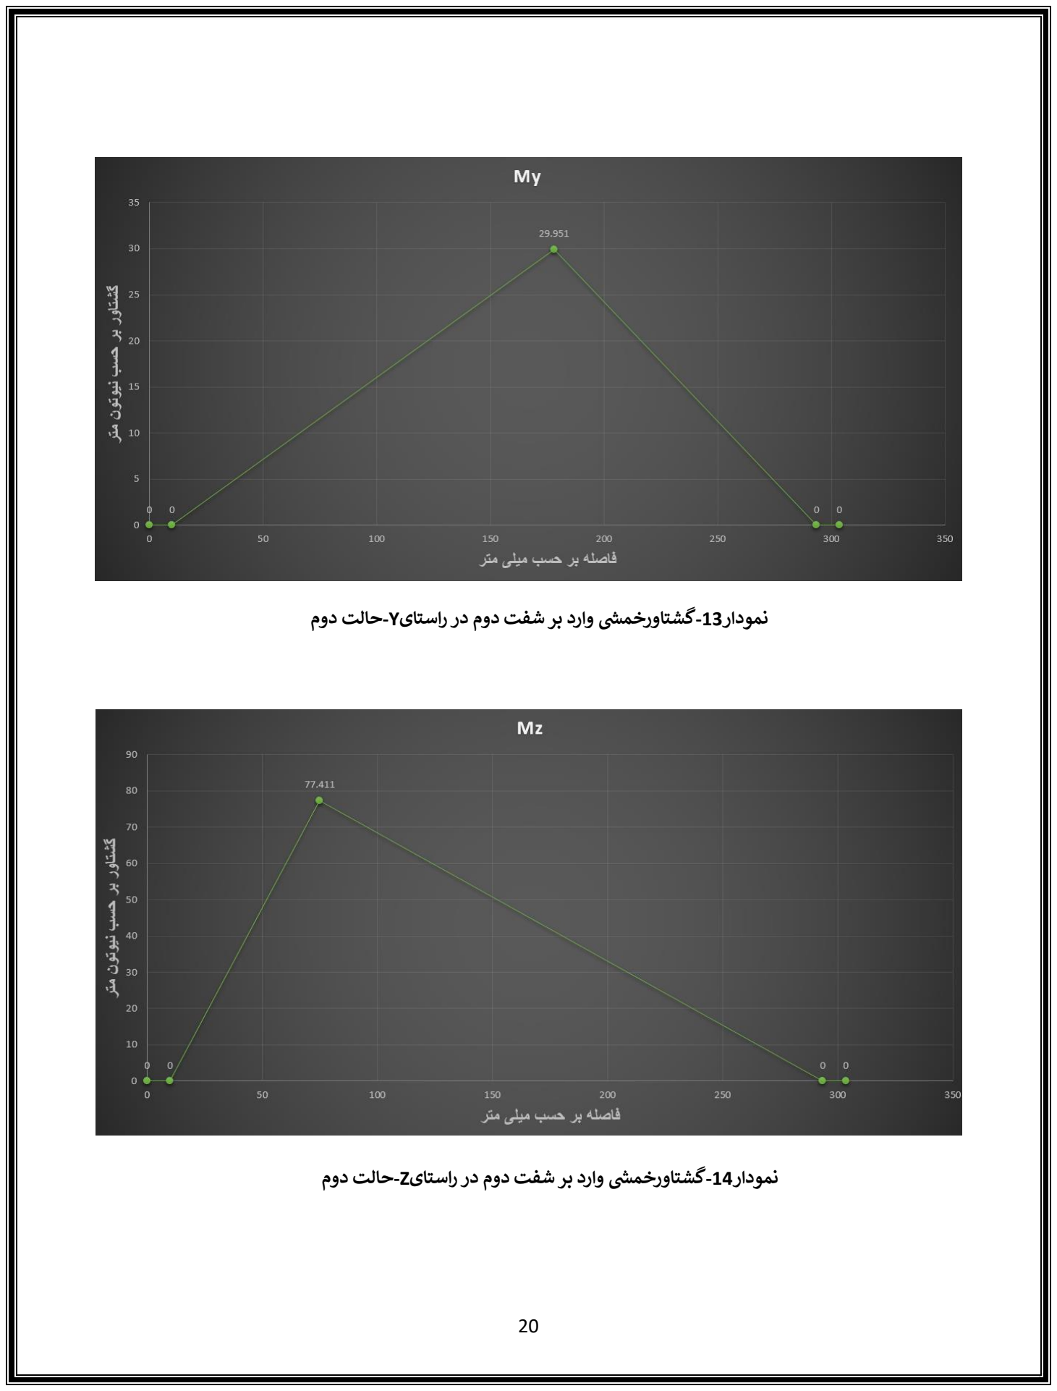
[picture p31: page 20]

یش | نمودار -13 وارد برشفت دوم در راستای
گشتاورخم Y-حالت دوم
یش | نمودار -14 وارد برشفت دوم در راستای
گشتاورخم Z-حالت دوم

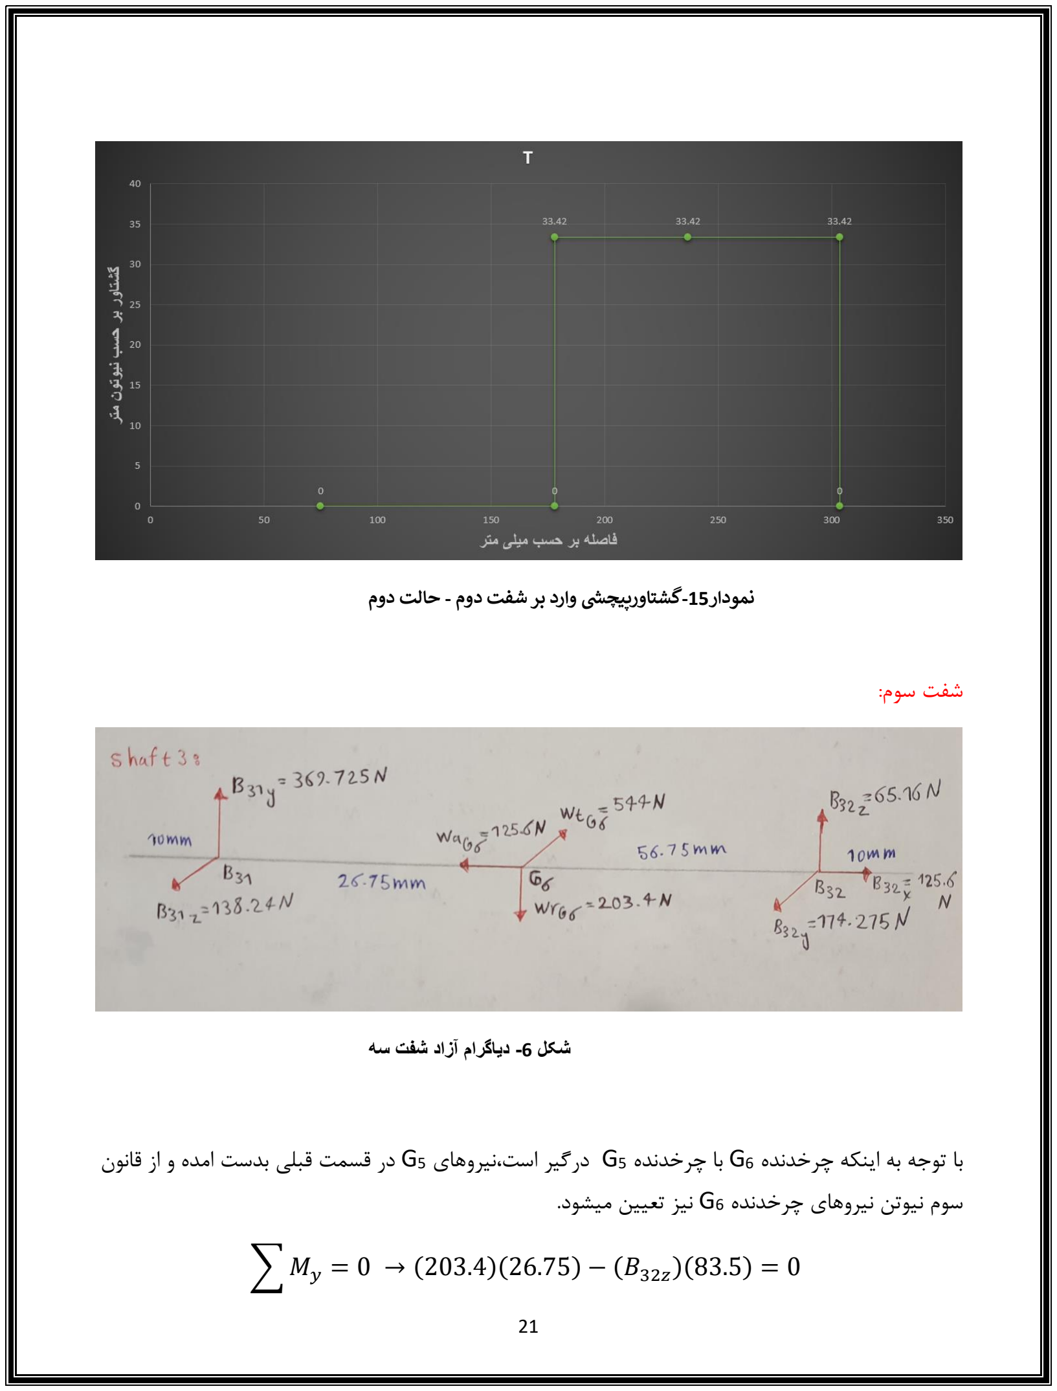
[picture p32: page 21]

شفت سوم:

با توجه به اینکه چرخدنده 6G با چرخدنده 5G درگی ر است،نیروهای 5G در قسمت قبلی بدست امده و از قانون سوم نیوتن نیروهای چرخدنده 6G نیز تعیین میشود.

∑My = 0 → (203.4)(26.75) − (B32z )(83.5) = 0

یش | نمودار -15 وارد برشفت دوم
گشتاورپیچ - حالت دوم

شکل -6 دیاگرام آزاد شفت سه

∑Fz = 0 → B31z + B32z − 203.4 = 0

B31z = 138.24 (N)
B32z = 65.16 (N)

∑Mz = 0 → (544)(26.75) − (B32y)(83.5) = 0

∑Fy = 0 → 549 − B31y − B32y = 0

B31y = 369.725 (N)

B32y = 174.275 (N)

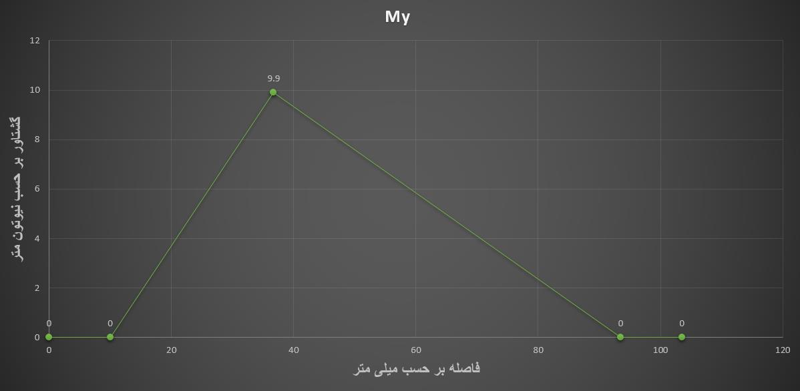
[picture p33: figure]

گشتاورخم سوم در راستایY | یش | نمودار -16 وارد برشفت

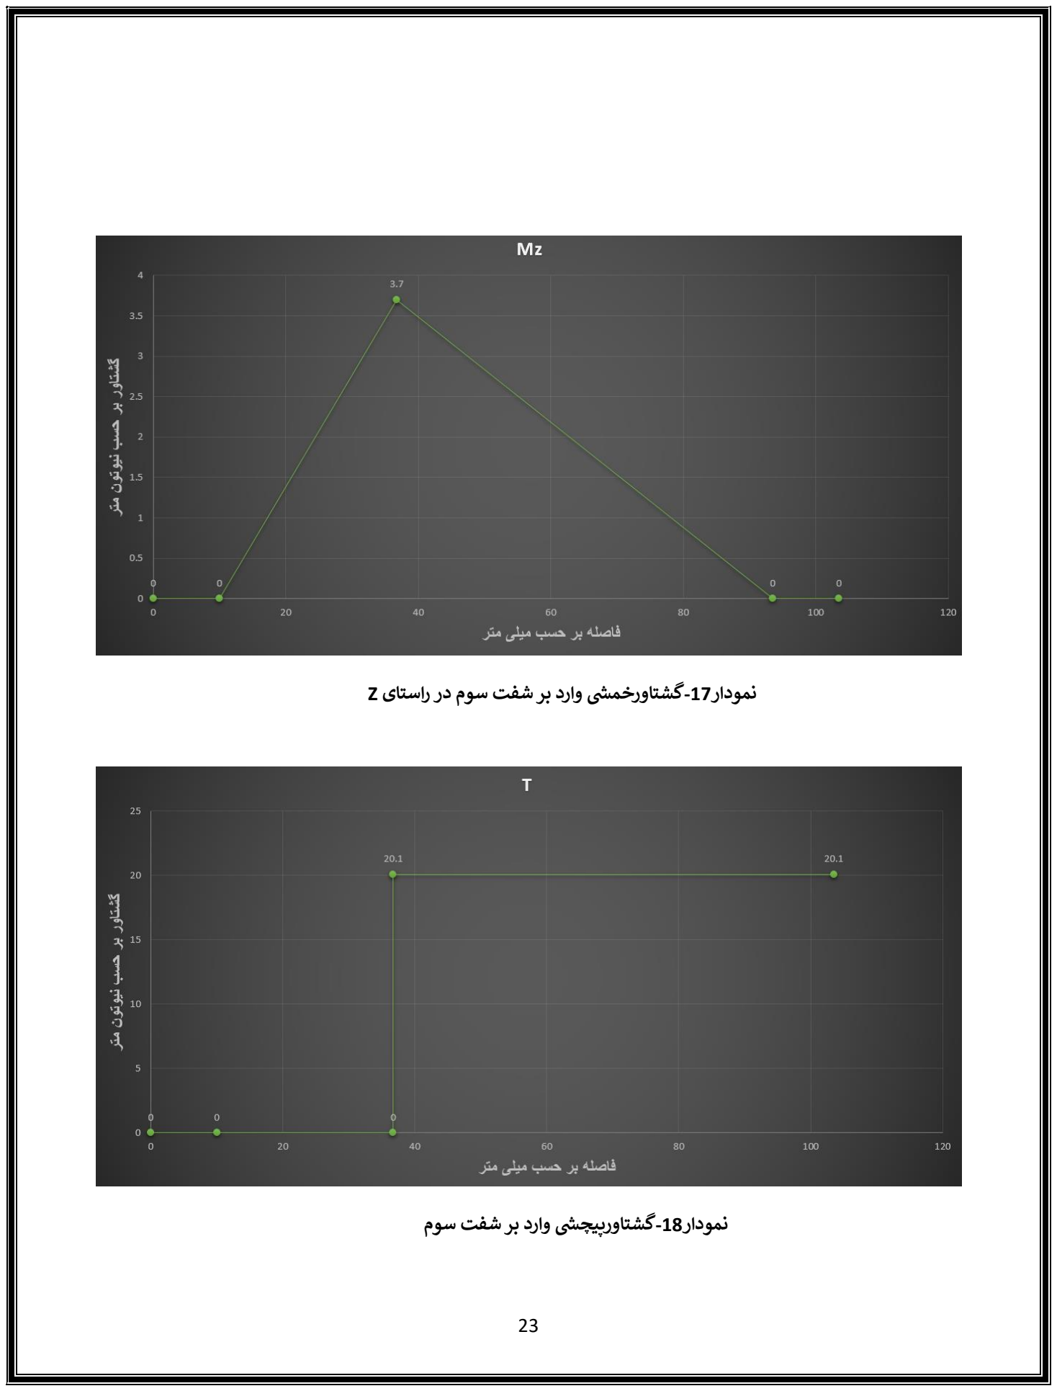
[picture p34: page 23]

گشتاورخم سوم در راستای Z | یش | نمودار -17 وارد برشفت
یش | نمودار -18 وارد برشفت
گشتاورپیچ سوم

.4 طراحی شفت ها:
برای طراحی شفت با استفاده از محاسباتی که در قسمت های قبلی داشتیم و به کمک رابطه وستینگهاوس،قطر را در مقاطع بحرانی محاسبه میکنیم.

مقاطع بحرانی شفت 1 را در شکل زیر مشاهده میکنیم.ما قطرها را با استفاده از کد متلب که در پیوست ضمیمه شده است محاسبه کردیم و یک نمونه محاسبات برای مقطع 4 ارایه کرده ایم.

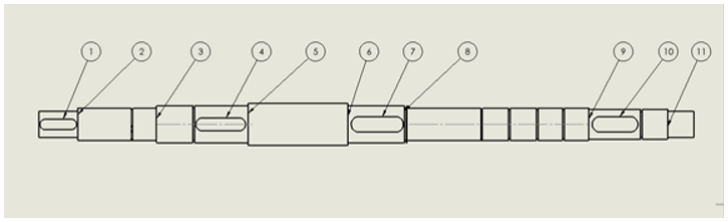
[picture p35: figure]

با توجه به فرضیات که در ابتدای پروژه بیان شد داریم:

Se’ = 0.504 (630) = 317.52 Mpa
حال باید ضرایب مارین را بدست اوریم:

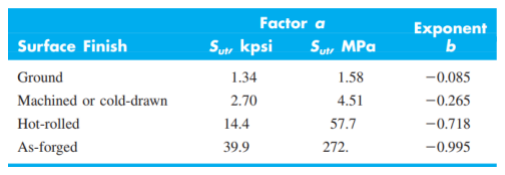
[picture p36: figure]

Ka → a= 4.51 , b= -0.265 → Ka = 0.871 (سطح | اصالح | ضریب(

Kb = 1.24 d

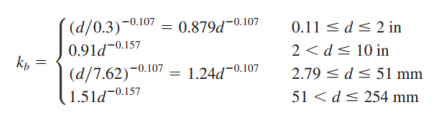
[picture p37: figure]

(ضریب اندازه ) 0.868= Kb → 28=d → ⁻⁰.107

(ضریب بارگذاری ) 1= Kc

(ضریب دما) 1= Kd

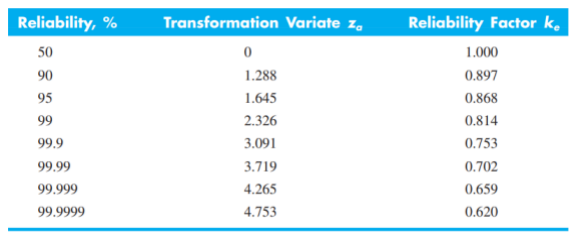
[picture p38: figure]

(ضریب اطمینان ) 0.868 = Ke
ضرایب Kf و Kfs برای خار یا پله توسط نمودارهای زیر محاسبه میشوند.

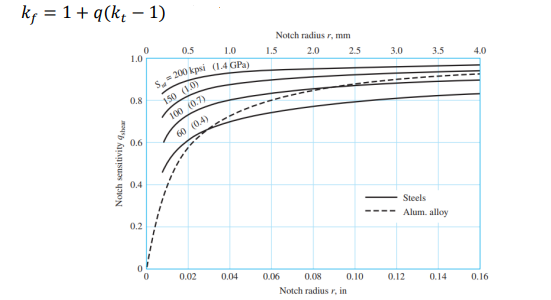
[picture p39: figure]
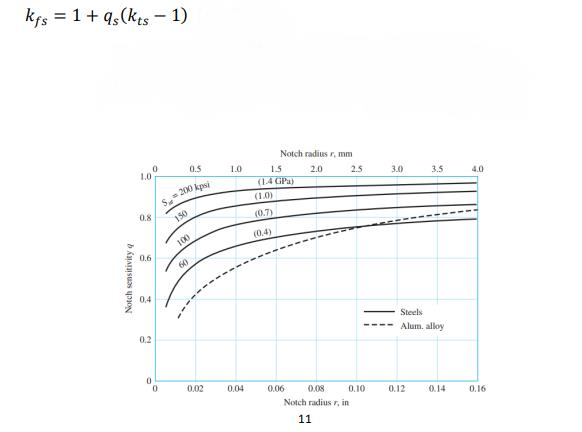
[picture p40: figure]

طراحی شفت 1

بنابر رابطه وستینگهاوس قطر شفت برای مقطع انتخابی در حالت سوم برابر 22.9 میلی متر بدست می آید که در نهایت با توجه به چیدمان شفت و مالحظات طراحی آن را به طور معقول رند خواهیم کرد. بنابراین روند بدست اوردن قطر شفت در نقاط بحرانی همانند روند باال میباشد. از این پس ما برای هر شفت جدول جامعی شامل نقاط بحرانی و قطر آن ها و در نهایت قطر نهایی را گزارش میکنیم.یادآوری میشود که کد متلب استفاده شده برای بدست اوردن سریع تر قطر ها ضمیمه شده است.

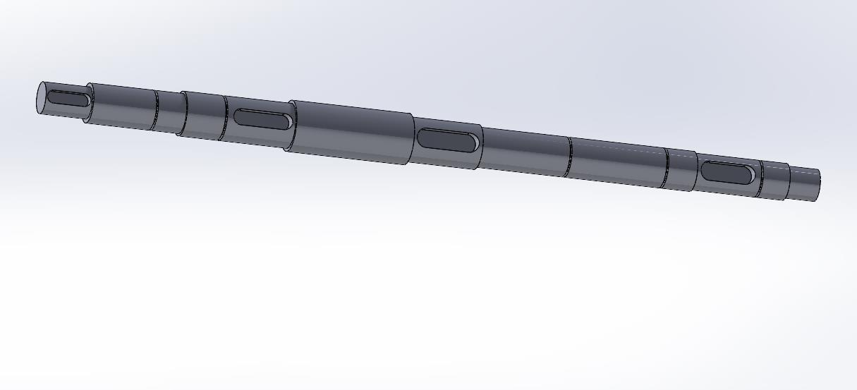
[picture p41: figure]
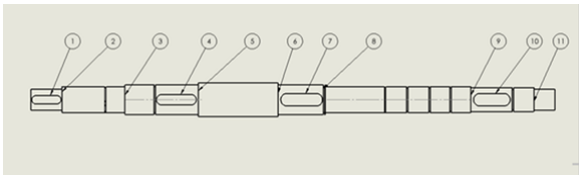
[picture p42: figure]

جدول جامع شفت :1

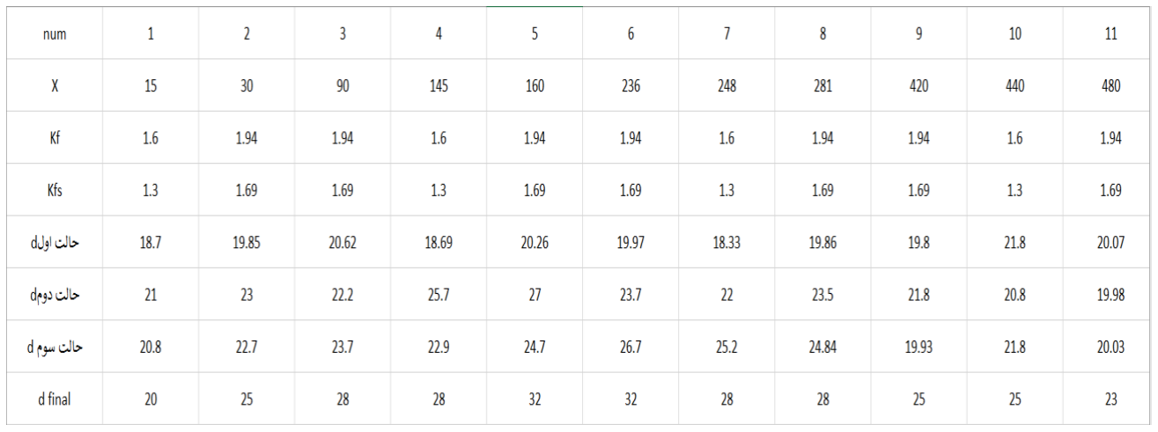
[picture p43: figure]

برای هر شفت محاسبات خار را به صورت جداگانه ارای ه کرده ایم. رابطه ی محاسبه طول خار:

در رابطه باال T مقدار گشتاور در محل خار و d قطر شفت و h عمق خار میباشند.

جداول مربوط به خار های مستطیلی و خار های فنری استفاده شده در طراحی شفت در پیوست اورده شده است.

محاسبات خار برای شفت :1
-1 چرخ زنجیر:

L =

4 T FS
d ℎ Sy

=

4×131.31×2
20×7×370

= 17.775 mm

طول جاخار،حداقل برابر قطر شفت است درنت یجه : mm20= L

-2 چرخدنده 1G :

L= ⁴×125.34×2
28×7×370

= 13.83 mm

طول جاخار،حداقل برابر قطر شفت است درنت یجه : mm28= L

-3چرخدنده 2G :

L = ⁴×83.55×2
28×7×370

= 9.22mm

طول جاخار،حداقل برابر قطر شفت است درنت یجه : mm 28 = L

-4 چرخدنده 7G :

L = ⁴×88.55×2
23×7×370

= 11.2 mm

طول جاخار،حداقل برابر قطر شفت است در نتیجه : mm23 = L بنابر این حد دوام تصحیح شده بدست می آید:

0.871 × 0.868×1×1×0.868×1×317.52 = 208.37 Mpa
بنابر رابطه وستینگهاوس قطر شفت برای مقطع انتخابی در حالت سوم برابر 22.9 میلی متر بدست می آید که در نهایت با توجه به چیدمان شفت و مالحظات طراحی آن را به طور معقول رند خواهیم کرد. بنابراین روند بدست اوردن قطر شفت در نقاط بحرانی همانند روند باال میباشد. از این پس ما برای هر شفت جدول جامعی شامل نقاط بحرانی و قطر آن ها و در نهایت قطر نهایی را گزارش میکنیم.یادآوری میشود که کد متلب استفاده شده برای بدست اوردن سریع تر قطر ها ضمیمه شده است.

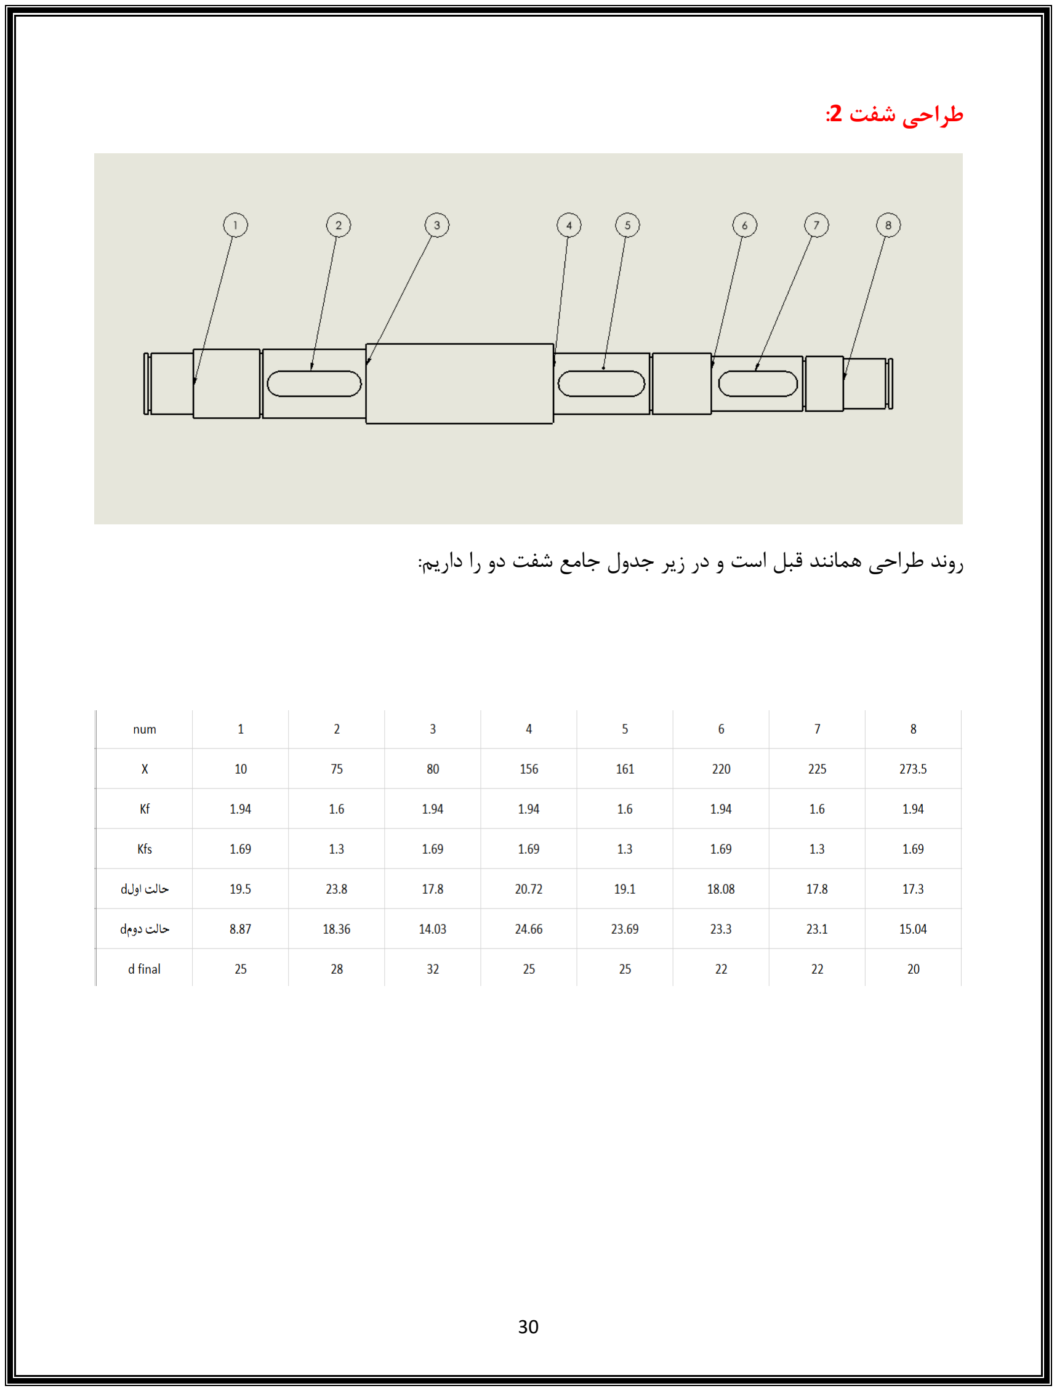
[picture p44: page 30]

طراحی شفت :2

روند طراحی همانند قبل است و در زیر جدول جامع شفت دو را داریم:

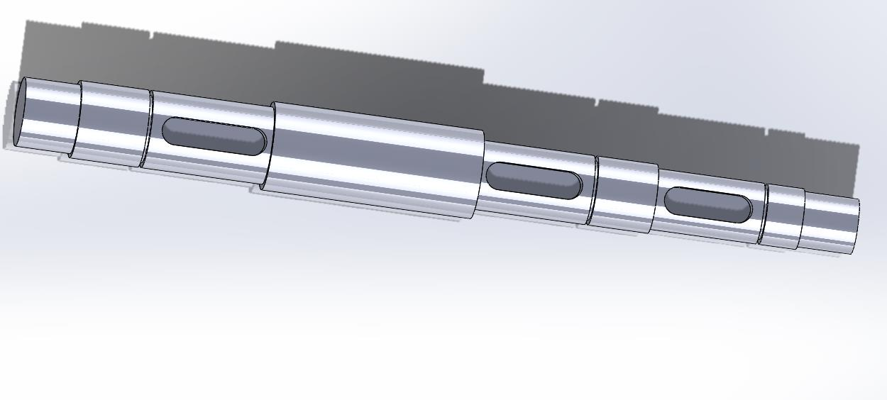
[picture p45: figure]

محاسبات خار برای شفت :2

-1چرخدنده 3G :

L =

4 T FS
d ℎ Sy

=

4×63.66×2
28×5×370

= 9.824 mm

طول جاخار،حداقل برابر قطر شفت است درنت یجه : mm28= L

-2چرخدنده 4G :

L = ⁴×63.66×2
25×5×370

= 11.04 mm

طول جاخار،حداقل برابر قطر شفت است درنت یجه : mm25= L

-3چرخدنده 5G :

L = 4×55×2
22×5×370

=10.81 mm

طول جاخار،حداقل برابر قطر شفت است درنت یجه : mm22= L

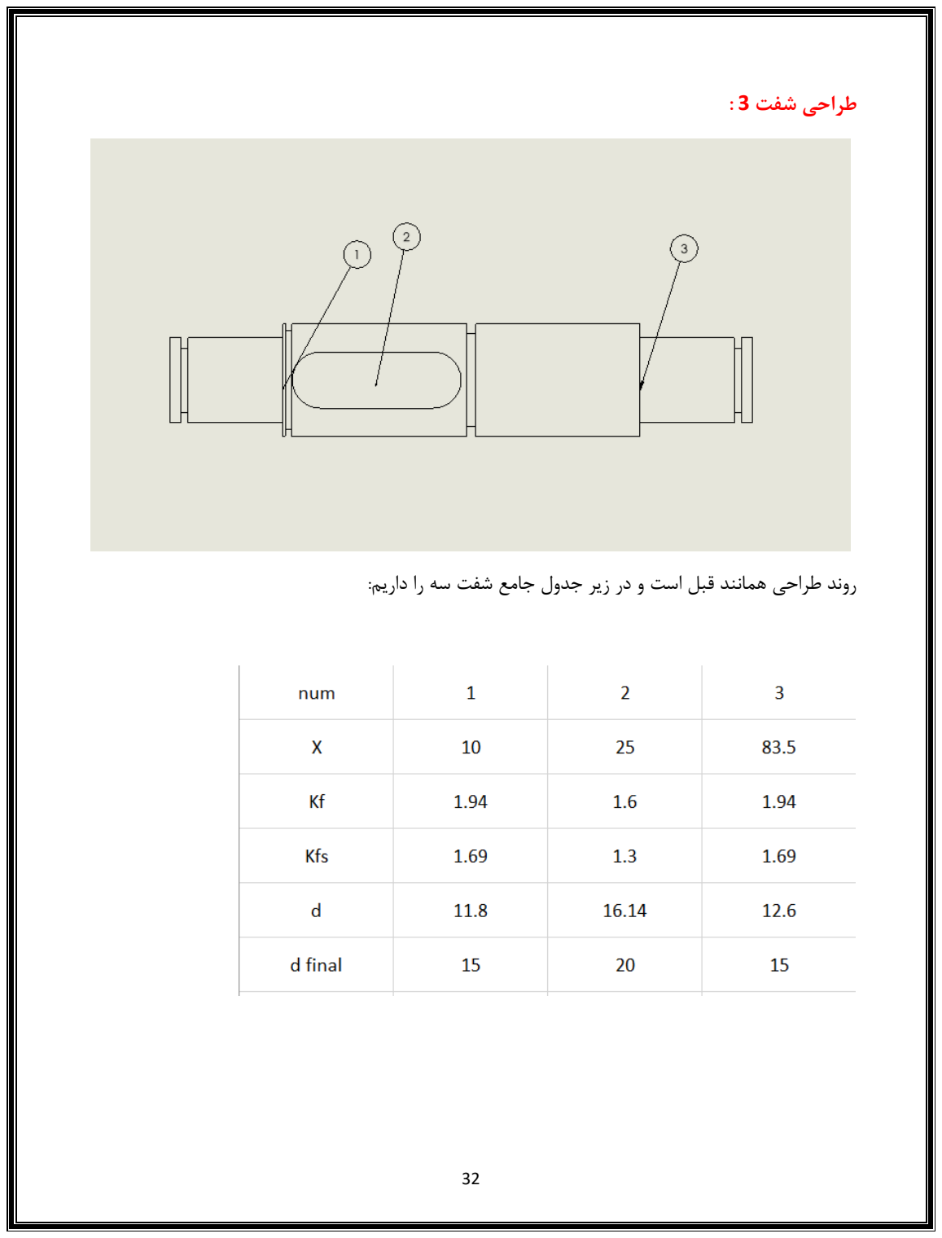
[picture p46: page 32]

طراحی شفت 3 :

روند طراحی همانند قبل است و در زیر جدول جامع شفت سه را داریم:

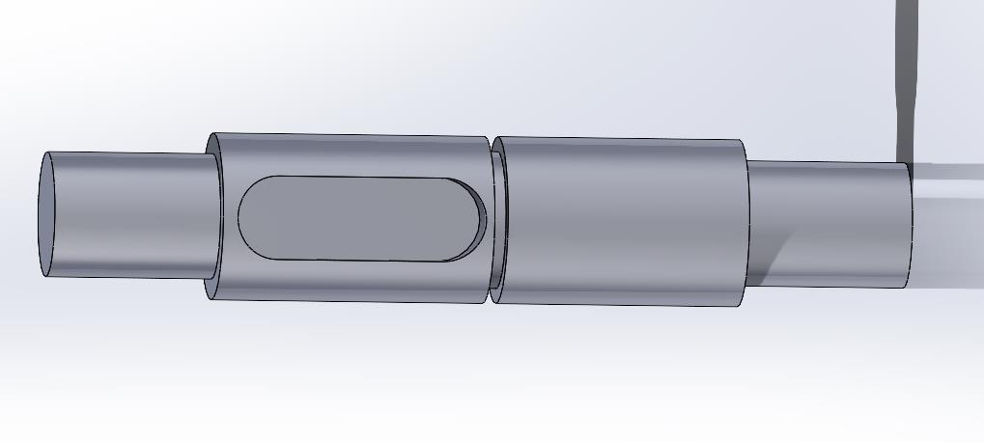
[picture p47: figure]

محاسبات خار برای شفت :3

-1 چرخدنده 6G :

L = ⁴ T FS
d ℎ Sy

=

4×20.1×2
20×5×370

= 4.346 mm

طول جاخار،حداقل برابر قطر شفت است درنت یجه : mm 20= L

مقاطع بحرانی در شکل زیر نشان داده شده اند:

نقشه کامل شفت ها در پیوست آمده است.

.5بلبرینگ های زیر چرخدنده های هرزگرد:

برای 1G :
با توجه تحلیل نیرویی چرخدنده ،1 از برینگ سوزنی 17×33×28K استفاده میکنیم.

حداکثر قطر سوراخ چرخدنده برابر mm34=d میباشد و 33500= 0C و 19000=C که عمر مورد نیاز ما را تامین میکند. 33to28 =dBearing

برای 2G :
با توجه تحلیل نیرویی چرخدنده ،2 از برینگ سوزنی 17×33×28K استفاده میکنیم.

حداکثر قطر سوراخ چرخدنده برابر mm45=d میباشد و 33500= 0C و 19000=C که عمر مورد نیاز ما را تامین میکند. 33to28 =dBearing

برای 6G :
با توجه تحلیل نیرویی چرخدنده ،2 از برینگ سوزنی 30×30×20K استفاده میکنیم.

dBearing =20to30
کاتالوگ مربوط به این برینگ ها در پیوست ضمیمه شده است.

.6 طراحی برینگ های اصلی:

عمر مورد نیاز)محاسبه با ماکزیمم سرعت =rpm1000 )

15(y)×250(d)×12(h)×60(min)×1000(rpm) = 2.7×10⁹

B11:
حالت اول فقط چرخدنده 7G و 8G درگیر باشند:

Fr = √Fy
2 + Fz

2 = 414.705 N

Fa = 0
حالت دوم عالوه بر دو چرخدنده باال چرخدنده های 1G و 3G نیز درگیر باشند:

Fr = √Fy
2 + Fz

2 = 1285.6 N

Fa = 0
حالت سوم عالوه بر دو چرخدنده 7G و 8G،چرخدنده های 2G و 4G نیز درگیر باشند:

Fr = √Fy
2 + Fz

2 = 629.3 N

Fa = 0

P = √(0.2 × (414.7
3) + 0.3 × (1285.6
3) + 0.5 × (629.3

3)

3
=938.85 N
به عنوان اولین حدس 6305 را انتخاب میکنیم:

رابطه عمر برینگ:

1a ضریب قابلیت اطمینان است که برابر 95 درصد در نظر میگیریم.)0.62=1a ) 2a ضریب دما است که چون دمای کاری دمای عادی است، آن را برابر یک در نظر میگیریم.

10C برابر ظرفیت دینامیکی برینگ میباشد که از کاتالوگ قابل استخراج است.

n ضریب بار میباشد که 1.3 را برای چرخدنده و 1.2 را برای بارگذاری مالیم و ضریب 2 را برای نزدیک بودن برینگ 11B به چرخ زنجیر در نظر میگیریم بنابراین:

n =1.3×1.2×2 =3.12
با توجه به کاتالوگ ظرفیت دینامیکی 6305 برابر 22500 میباشد.

L = a1 a2 (

c10
nP

)

3 → L = 2×10⁸
مورد پذیرش نیست زیرا عمر مورد نیاز مارا تامین نمیکند.

حدس بعدی برینگ cc 22205 که برینگ مخروطی است. ظرفیت دینامیکی این برینگ برابر:

C0 = 35700 , D =52mm → L = 4.164 × 10⁹

این برینگ عمر مورد نیاز مارا تامین میکند و بنابراین قابل قبول است.

B12 :
برینگ 6205 را حدس میزنیم. 6950= 0C و 14000= 10C میباشد.

برای حاالت مختلفی که در باال گفته شد به ترتیب نیرو را محاسبه میکنیم:

حالت اول:

Fr = √Fy
2 + Fz

2 = 80.465 N

Fa = 0

حالت دوم:

Fr = √Fy
2 + Fz

2 = 487.13 N

Fa = 0
حالت سوم:

Fr = √Fy
2 + Fz

2 = 801.6 N

Fa = 261 N
در این حالت نکته اینجاست که نیروی محوری داریم و این نیرو را به برینگ 12B داده ایم.

Fa
C0

=

261
6950

= 0.0375 → e = 0.224

از جدول ضرایب بار محوری و شعاعی استفاده میکنیم.

همچنین رابطه بار معادل به صورت زیر است:

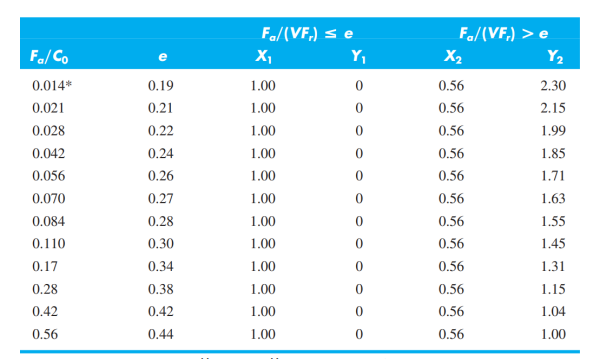
[picture p48: figure]

Fa
V Fr

=

261
1×801.6

= 0.3255>e → X = 0.56 , Y =1.96

Fe = 0.56× 801.6 + 1.96 × 261 =960.458 N

P = √(0.2 × (80.465³) + 0.3 × (487.13³) + 0.5 × (960.458³)

3
=781.76 N
برای این برینگ قابلیت اطمینان را برابر 95 درصد و دما را تا 150 درجه در نظر میگریم:

a1 = 0.62 , a2 =1
ضریب بارگذاری به صورت 1.3 برای چرخدنده و 1.2 برای بار مالیم تاثیر داده میشود:

n = 1.2×1.3 = 1.56
L = 0.62×1×( 14000
1.56×781.76

)

3 = 937×10⁶

عمر مورد نیاز ما تامین نمیشود و بنابر این باید سراغ برینگ دیگری برویم:

6305

C0 =11400 , C10 =22500
نیرو در حالت های اول و دوم تغییر نمیکند چون بار محوری نداریم و تنها برای حالت سوم باید بار معادل را مجدد محاسبه کنیم:

Fr = √Fy
2 + Fz

2 = 801.6 N

Fa = 261 N

Fa
C0

=

261
11400

= 0.0228 → e = 0.228

Fa
V Fr

=

261
1×801.6

= 0.3255>e → X = 0.56 , Y =1.932

Fe = 0.56× 801.6 + 1.932 × 261 =953.67 N

P = √(0.2 × (80.465³) + 0.3 × (487.13³) + 0.5 × (953.67³)

3
=776.65 N

L = 0.62×1×( 22500
1.56×776.65

)

3 = 3.8 × 10⁹

بنابر این 6305 قابل قبول است و انتخاب میشود.

d=25 mm , D =62 mm

برای تکه ی دوم شفت اول بارگذاری ثابت است و تنها کافی است یک حالت را بررسی کنیم.

بار محوری را به برینگ 14B میدهیم:

B13:

Fr = √Fy
2 + Fz

2 = 1169.1 N

Fa = 0

برینگ 6404 را به عنوان انتخاب اول بررسی میکنیم:

C0 = 19600 , C =35800
با ضریب اطمینان 95 درصد و دما تا 120 درجه برای بارگذاری حالت قبل:

L = 0.62×1×( 19600
1.56×1169.1

)

3 = 4.689 × 10⁹

بنابراین برینگ عمر مورد انتظار مارا داراست و مناسب است. mm80 = D و mm25= d

B14 :

Fr = √Fy
2 + Fz

2 = 1169.1 N

Fa = 0

به عنوان اولین حدس 6404 را انتخاب میکنیم:

C0 = 16600 , C =30700

Fa
C0

=

118
16600

= 0.0071 → e = 0.19

Fa
V Fr

=

118
1×1169.1

= 0.1<e → X =1 , Y =0

Fe = 1× 801.6 + 0× 261 =1169.1 N L = 0.62×1×( 30700
1.56×1169.1

)

3 = 2.597 × 10⁹

عدد بدست آمده بسیار نزدیک به عمر مورد نیاز ماست.از آنجایی که نمیخواهیم اوردیزاین کنیم و همچنین قابلیت اطمینان را نیز 95 درصد گرفته ایم، این برینگ مورد پذیرش است. اگر قابلیت اطمینان را 90 درصد در نظر گرفته بودیم، آنگاه:

L = 4.7 × 10⁹

طراحی برینگ های شفت دوم:

نیروی محوری را به برینگ 22B میدهیم:

B21:

L=15×250×2×6×60× (600×0.3+1000×0.5)=1836×10⁶

L2=15×250×2×6×60×600×0.3=48610⁶

L3=15×250×2×6×60×1000×0.5=1350×10⁶

α2=L2
L

=0.265

α3=L3
L

=0.735

حالت اول:

Fr = √Fy
2 + Fz

2 = 1257.58 N

Fa = 0
حالت دوم:

Fr = √Fy
2 + Fz

2 = 510.715 N

Fa = 0
برای حدس اول برینگ 6305 را انتخاب میکنیم:

C10 =22500

ضریب اطمینان را برابر 95 درصد در نظر میگیریم و دما عادی و شرایط بارگذاری همانند حالت قبل است:

P = √0.265 × (1257.58³) + 0.735 × (510.715³)

3
=854.96N

L = 1×0.62×( 22500
1.56×854.96

)

3 = 2.97 × 10⁹

بنابراین 6305 قابل قبول است و عمر مورد نیاز ما را تامین میکند.mm25 =d , mm62 = D

B22 :
6304 را به عنوان حدس اول انتخاب میکنیم: 7800 = 0C, 15900 =10C

حالت اول :

Fr = √Fy
2 + Fz

2 = 55.88 N

Fa = 125.6 N

Fa
C0

=

125.6
7800

= 0.016 → e = 0.2

Fa
V Fr

=

125.6
1×55.88

= 2.24>e → X = 0.56 , Y =2.22

Fe = 0.56× 55.88 + 2.22 × 125.6 =310.12 N
حالت دوم :

Fr = √Fy
2 + Fz

2 = 715.53 N

Fa = 261 N

Fa
C0

=

261
7800

= 0.033 → e = 0.23

Fa
V Fr

=

261
1×715.53

= 0.365>e → X = 0.56 , Y =1.92

Fe = 0.56× 715.53 + 1.92 × 261 =901.81 N

P = √0.265 × (310.12³) + 0.735 × (901.81³)

3
=817.8 N
ضریب اطمینان را برابر 90 درصد در نظر میگیریم و دما عادی و شرایط بارگذاری همانند حالت قبل است:

L = 1×1×( 15900
1.56×817.8

)

3 = 2.8 × 10⁹

عمر مورد نیاز را تامین میکند و قابل قبول است.

6304 → D=52mm , d =20mm

طراحی برینگ های شفت سوم:

نیروی محوری را به برینگ 32B میدهیم:

B31 :

Fr = √Fy
2 + Fz

2 = 394.72 N

Fa = 0
سرعت دورانی شفت سه پایین تر از شف های یک و دو است بنابراین عمر را یکبار دیگر حساب میکنیم:

15(y)×250(d)×12(h)×60(min)×250(rpm) = 0.675×10⁹

حدس اولیه برینگ 6302 با مشخصات 5400 = 0C و 11400 = 10C

با ضریب اطمینان 90 درصد:

L = 1×1×( 11400
1.56×394.72

)

3 = 0.674× 10⁹

برینگ عمر مورد نیاز را تامین میکند و قابل قبول است.اگر کالس را باال ببریم اوردیزاین میشود و نیازی به اینکار نیست.

B32:

برای حدس اول 6302 را انتخاب میکنیم. 3550= 0C و 7800 =C

Fr = √Fy
2 + Fz

2 = 186.1 N

Fa = 125.6

Fa
C0

=

125.6
3550

= 0.035 → e = 0.23

Fa
V Fr

=

125.6
1×186.1

= 0.67>e → X = 0.56 , Y =1.92

Fe = 0.56× 186.1 + 1.92 × 125.6 =345.368 N
با ضریب اطمینان 95 درصد:

L = 0.62×1×( 7800 1.56×345.368
)

3 = 1.8× 10⁹

عمر زیادی است و مقداری اوردیزاین میشود بنابراین برینگ دیگری را انتخاب میکنیم:

حدس بعدی 6002 : 5590 = C , 2500 = 0C

Fa
C0

=

125.6
2500

= 0.05 → e = 0.25

Fa V Fr
=
125.6 1×186.1 | = 0.67>e → X = 0.56 , Y =1.78

Fe = 0.56× 186.1 + 1.78 × 125.6 =227.784 N
با ضریب اطمینان 95 درصد:

L = 0.62×1×( 5590 1.56×227.784
)

3 = 810× 10⁶

برینگ مناسب است.

نحوه تثبیت قطعات:

همانطور که در قسمت های قبلی گفته شد برای تثبیت دورانی و محوری اجزا روی شفت از پله،خار مستطیلی و همچنین خار فنری استفاده کرده ایم که در نقشه های شفت مشخص هستند.

همچنین برای تثبیت محوری پولی روی شفت یک از پیچ و مهره استفاده می کنیم که باید قطر سوراخ یک چهارم قطر شفت یعنی 5 cm باشد و پیچ 5Mنیاز است و از یک واشر با قطر خارجی mm 30 استفاده می کنیم.

تمام بلبرینگ ها با پرس فیت تثبیت دورانی می شوند.

برای تثبیت محوری چرخدنده 6 روی شفت از سمت راست با خار فنری و از سمت چپ با بوش حلقه ای انجام می دهیم و تثبیت دورانی نیز با خار مستطیلی انجام می شود.هردو بلبرینگ این شفت نیز از یک طرف با پله شفت تثبیت شده اند و از طرف دیگر با پله پوسته تثبیت شده اند.

چرخدنده 3 روی شفت 2 از سمت راست با پله و از سمت چپ با خار فنری تثبیت محوری می شود.چرخنده 4و5 نیز از سمت راست با خار فنری و از سمت چپ با پله تثبیت محوری شده اند. هر سه چرخدنده نیز با خار مستطیلی تثبیت دورانی شده اند. هردو بلبرینگ این شفت نیز از یک طرف با پله شفت تثبیت محوری شده اند و از طرف دیگر با پله پوسته تثبیت محوری شده اند.

چرخدنده 1 از سمت راست با پله و از سمت چپ با خارفنری تثبیت محوری می شود.چرخدنده 3 و 7 از سمت راست با خارفنری و از سمت چپ با پله تثبیت محوری می شوند و همه چرخدنده ها با خار مستطیلی تثبیت دورانی می شوند . 11B و 12B و 14B از یک طرف با پله پوسته و از طرف دیگر با پله شفت تثبیت محوری می شوند. 13Bبا خار فنری تثبیت محوری می شود.

همچنین برای تثبیت برینگ ها روی بدنه پوسته گیربکس،برینگ را پرس فیت میکنند.همچنین میتوانیم از پیچ تثبیت استفاده کرده و برینگ ها را بر روی پوسته بدین شکل تثبیت کنیم.روش دیگری که میتوان استفاده کرد و در برخی خودرو ها استفاده میشود،استفاده از مهره و واشر قفل کن برای تثبیت برینگ به بدنه میباشد. جداول خار های استفاده شده در پیوست اورده شده است.

نحوه تلرانس گذاری:

برای اینکه در سرتاسر پروژه روند تلرانس گذاری یکسان باشد، شفت را مبنای تلرانس م یگذاریم )h برای شفت(همچنین تلرانس گذاری برای خار ها و جاخار ها به ترتیب به صورت 9J و 9n انجام شده است.

جدول تلرانس قطر شفت در پیوست آورده شده است.

محاسبات قیمت:

در تاریخ هشت دی ماه 1401 ،در سایت com.shahrahan.www://https/ هر کیلو فوالد 45ck

به قیمت 44800 تومان به فروش میرود. وزن شفت های ما به ترتیب 2.3 1.6، و 1 کیلوگرم میباشد که در مجموع حدود 5 کیلوگرم میشود بنابراین قیمت شفت ها برابر224: هزار تومان میشود.

با توجه به خدمات سایت ir.service-shahr هر واحد تراشکاری مانند جای خار یا پله حدود 100 هزار تومان هزینه دارد که برای این پروژه چیزی حدود سه میلیون و هفتصد هزار تومان میشود.

قیمت برینگ ها نیز در زیر آورده شده است: قیمت برینگ های سوزنی بین 60 تا 80 تومن:منبع سایت ترب-از سه برینگ سوزنی استفاده کردیم.

قیمت برینگ های ساده را از net.fidargostar://https/ بدست میاوریم:

دو عدد برینگ 6302 با قیمت 33 هزار تومان

برینگ 6305 با قیمت 69 تومان- 3 عدد

برینگ 6205 نیز قیمتی حدود 51 تومان دارد

برینگ های 6404 و 6304 در سایت موجود نبودند ولی حدود قیمت 60 تومان را میشود برای آن ها در نظر گرفت.

تخمین از هزینه ساخت پوسته گیربکس نیز حدود 1 میلیون تومان است

مجموع هزینه فاز دوم پروژه: حدود 5 میلیون و شش صد هزار تومان

## منابع

### جزوه استاد نورانی

### کتاب طراحی اجزای شیگلی

### کاتالوگ های شرکت SKF

https://www.shahrahan.com/heat-treatment-steel/ck45-steel

### سایت ترب

# پیوست:

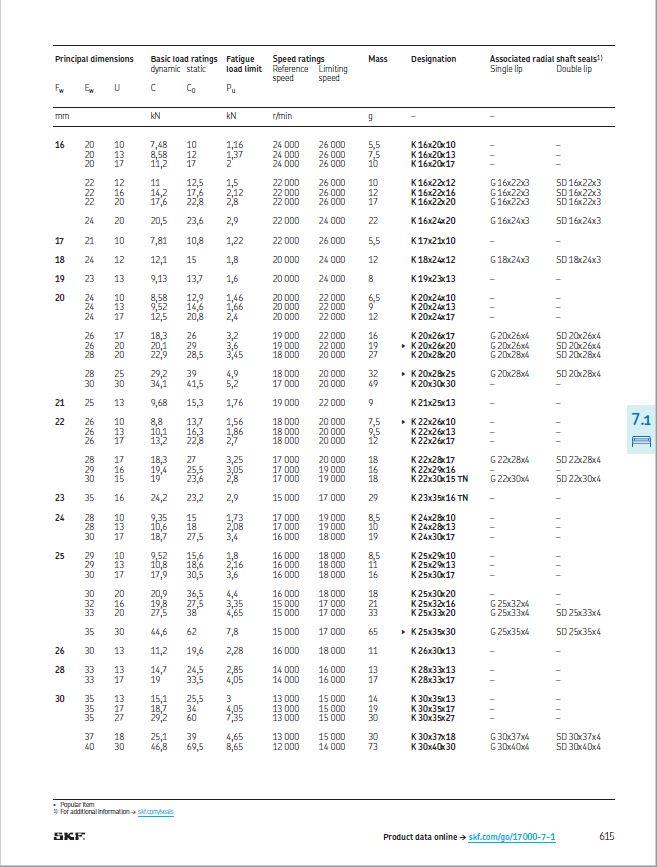
[picture p49: figure]

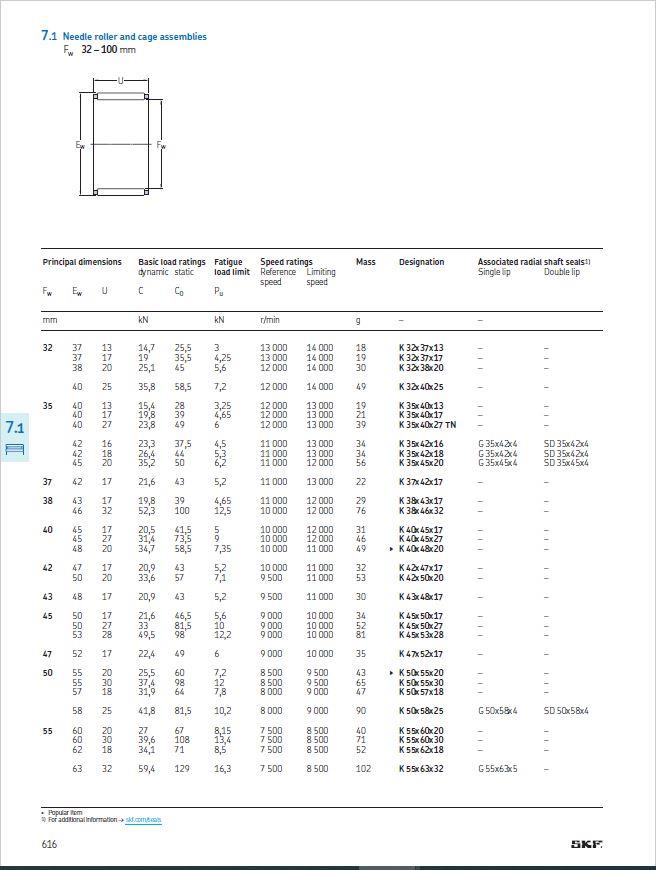
[picture p50: figure]

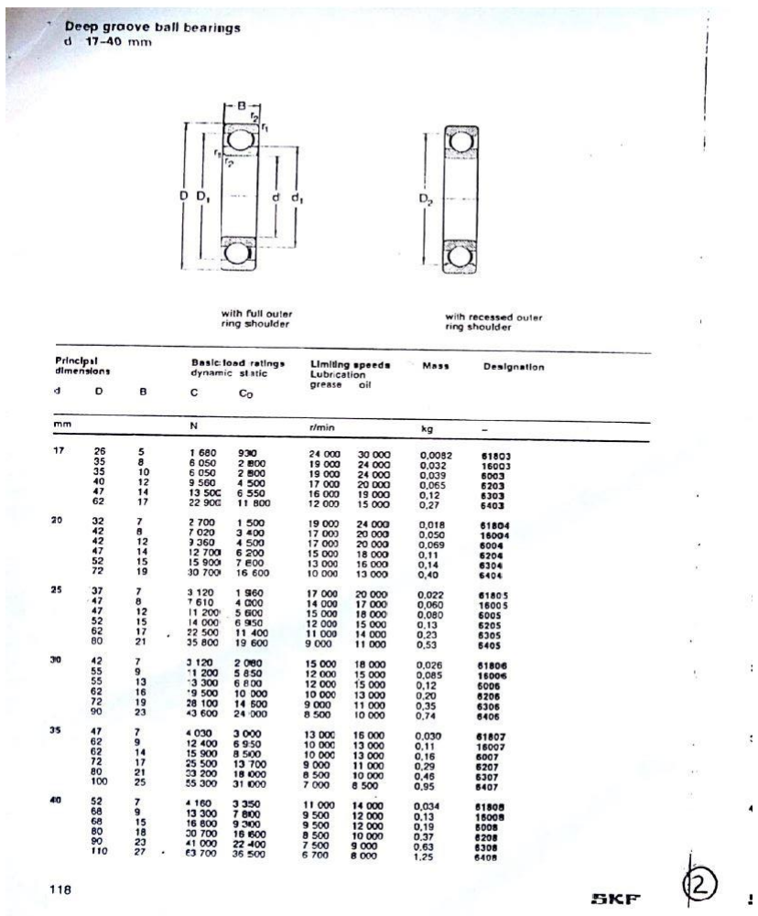
[picture p51: figure]

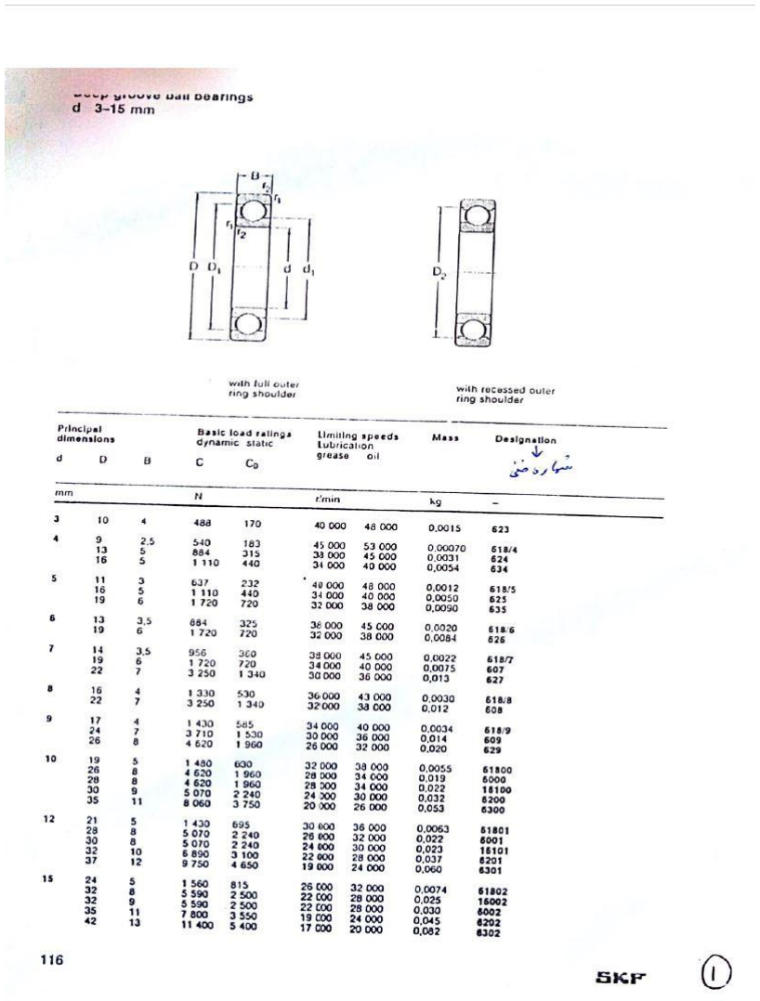
[picture p52: figure]

خار مستطیلی:

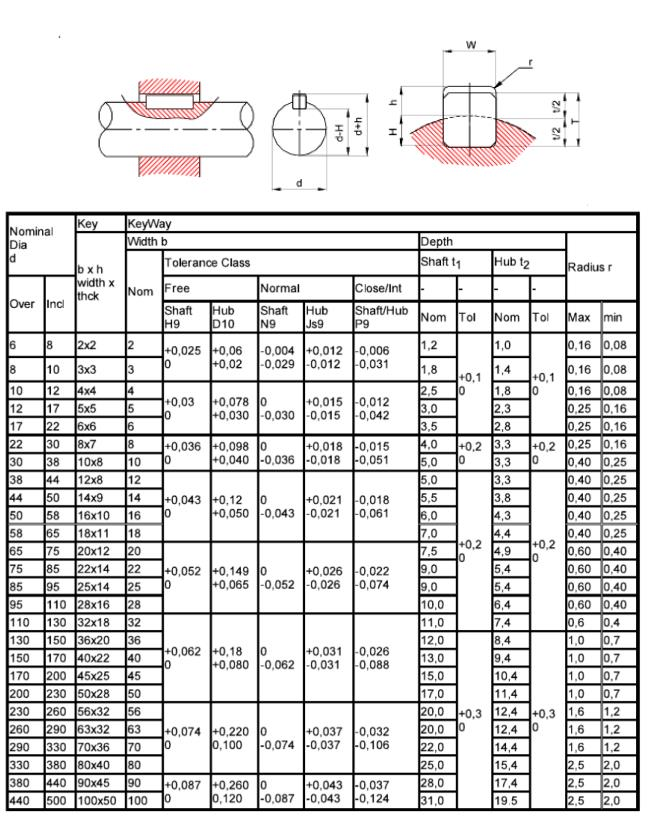
[picture p53: figure]

خار فنری:

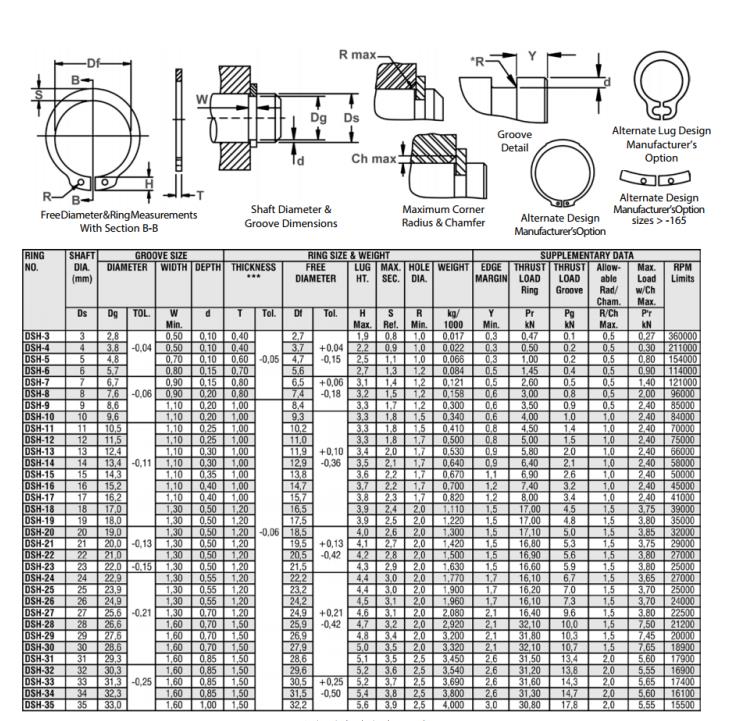
[picture p54: figure]

تلرانس شفت ها:

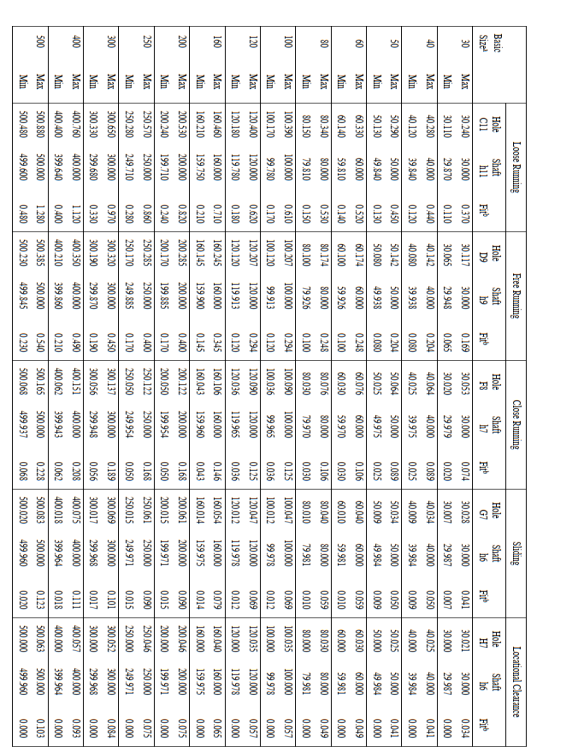
[picture p55: figure]

کد ذکر شده در قسمت محاسبه قطر شفت:

F_y=[-853.63 1256 -402.37]; F_yp=[0 0.02675 0.835];
F_z=[138.24 -203.4 63.15]; F_zp=[0 0.02675 0.835];
T=[0 19.9];
T_p=[0 0.02675 0.835];
x=[0.01 0.025 0.0735];
M_y=[];
M_z=[];
d=[];
T_f=[];
for i=1:length(x)
M_z(i)=0;
for j=1:length(F_y)

if x(i)>F_yp(j)

M_z(i)=M_z(i)+(x(i)-F_yp(j))*-1*F_y(j);

end

end

end

for i=1:length(x)
M_y(i)=0;
for j=1:length(F_z)

if x(i)> F_zp(j)

M_y(i)=M_y(i)+(x(i)-F_zp(j))*F_z(j);

end

end

end

M_a=(M_y.^2+M_z.^2).^0.5;

for i=1:length(x)
for j=1:length(T_p)-1
if x(i)>=T_p(j) && x(i)<T_p(j+1) T_f(i)=T(j);
break;
end
end

end

Fs=2;
kf=1.864;
kfs=1.688;
se=194.97;
sy=370;

d=
(((32*Fs*1000)/pi)*(((kf/se).*M_a).^2+((kfs/sy).*T_f).^2).^ 0.5).^(1/3)

نمونه خروجی :

توضیح کد

ما برای هر حالت از شفت نیروها در جهت yو z را به همراه موقعیت نیرو می دهیم . همچنین مقدار T و محل های شروع و پایان داده می شود. سپس موقعیت های حساس را که میخواهیم کد ما قطر را در انها حساب کند در ماتریس xوارد می کنیم.

تابع اول ممان در جهت z وتابع دوم ممان در جهت yرا حساب می کند و تابع سوم نیز تورک را در هر نقطه بحرانی محاسبه می کند. سپس با اضافه کردن ضرایب و Seو Sy در کد وستینگهاوس اخر قطرها حساب می شوند .

## نقشه های مونتاژی

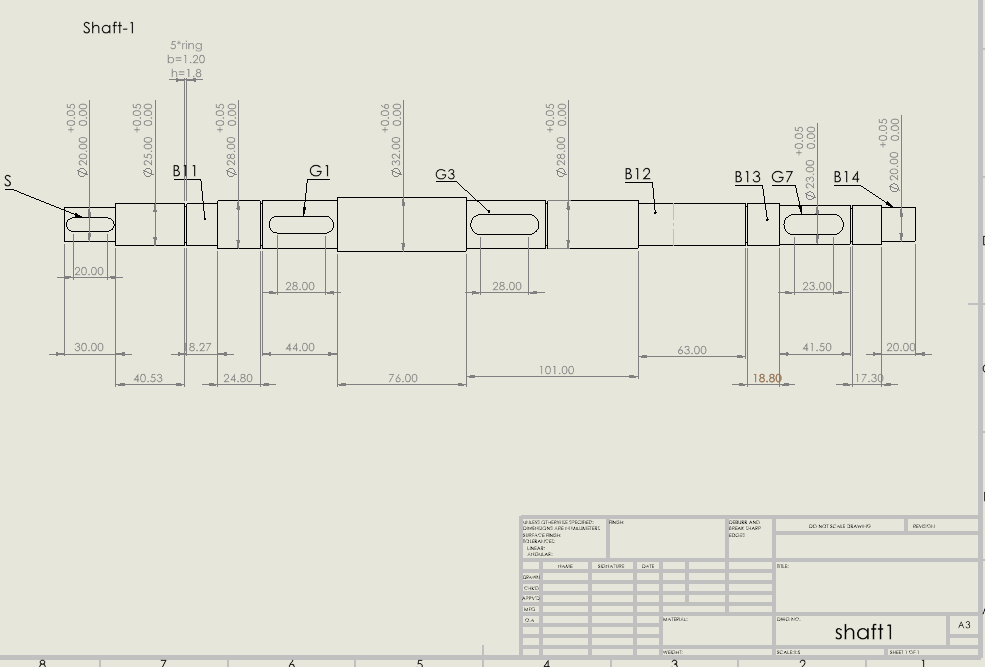
[picture p56: figure]

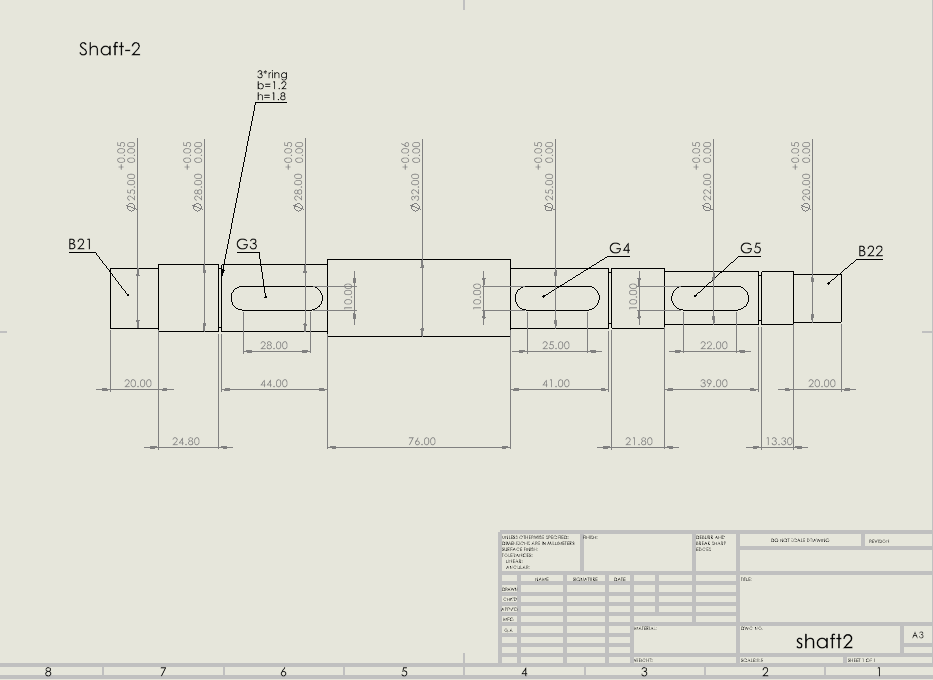
[picture p57: figure]

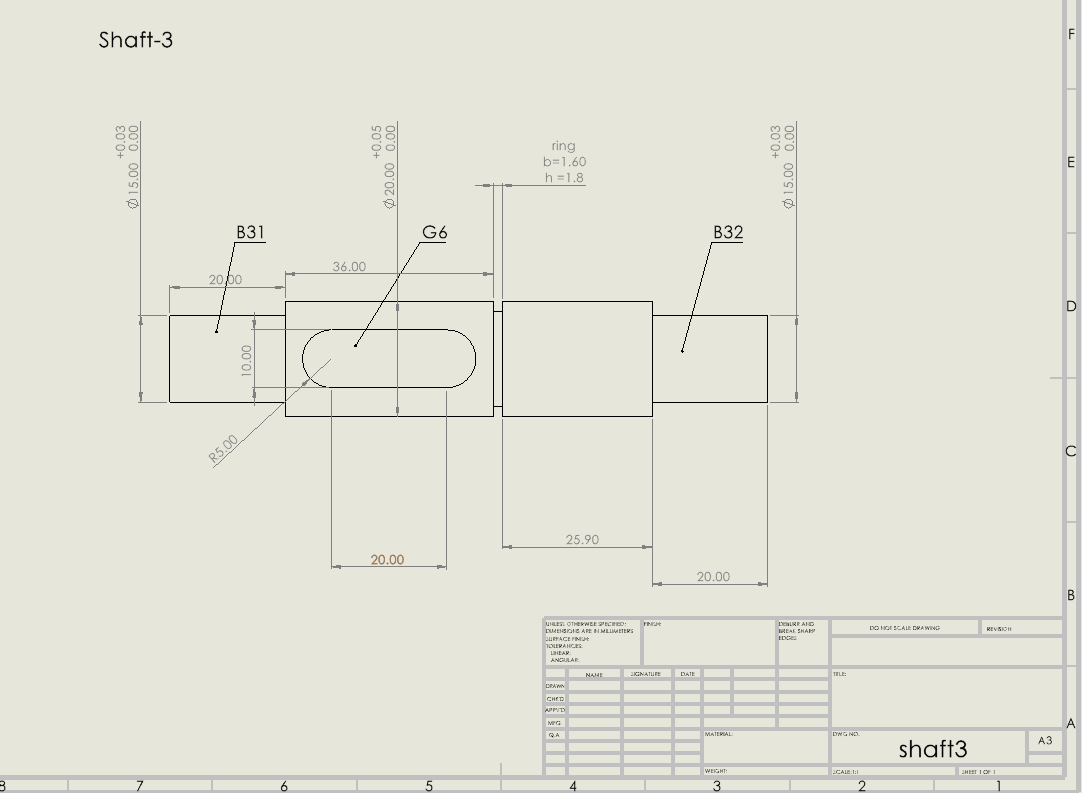
[picture p58: figure]
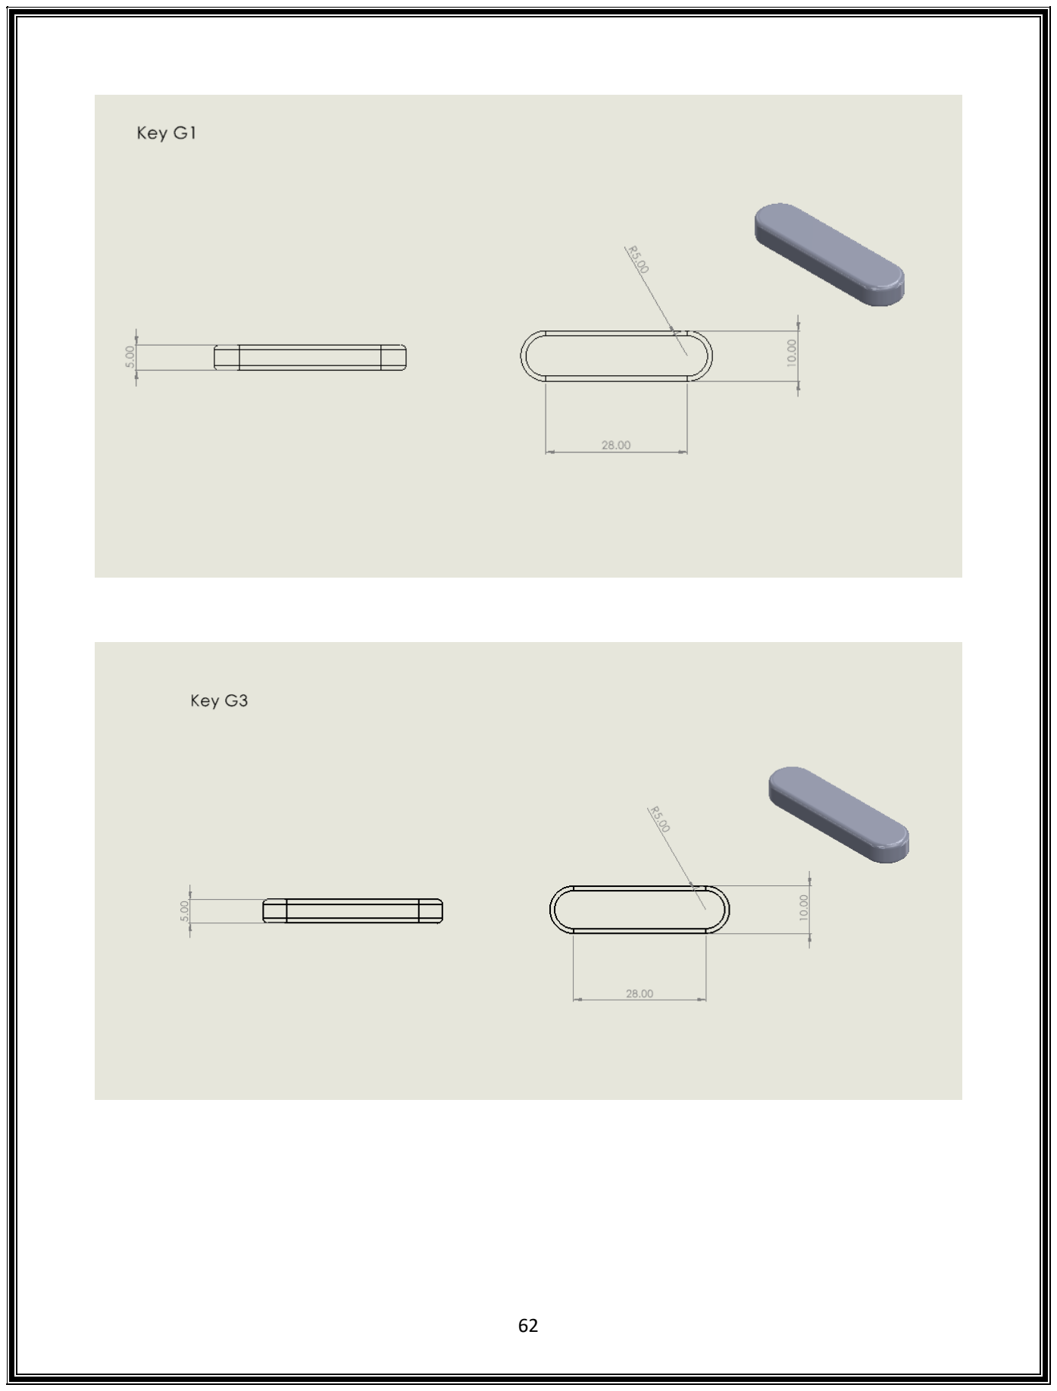
[picture p59: page 62]
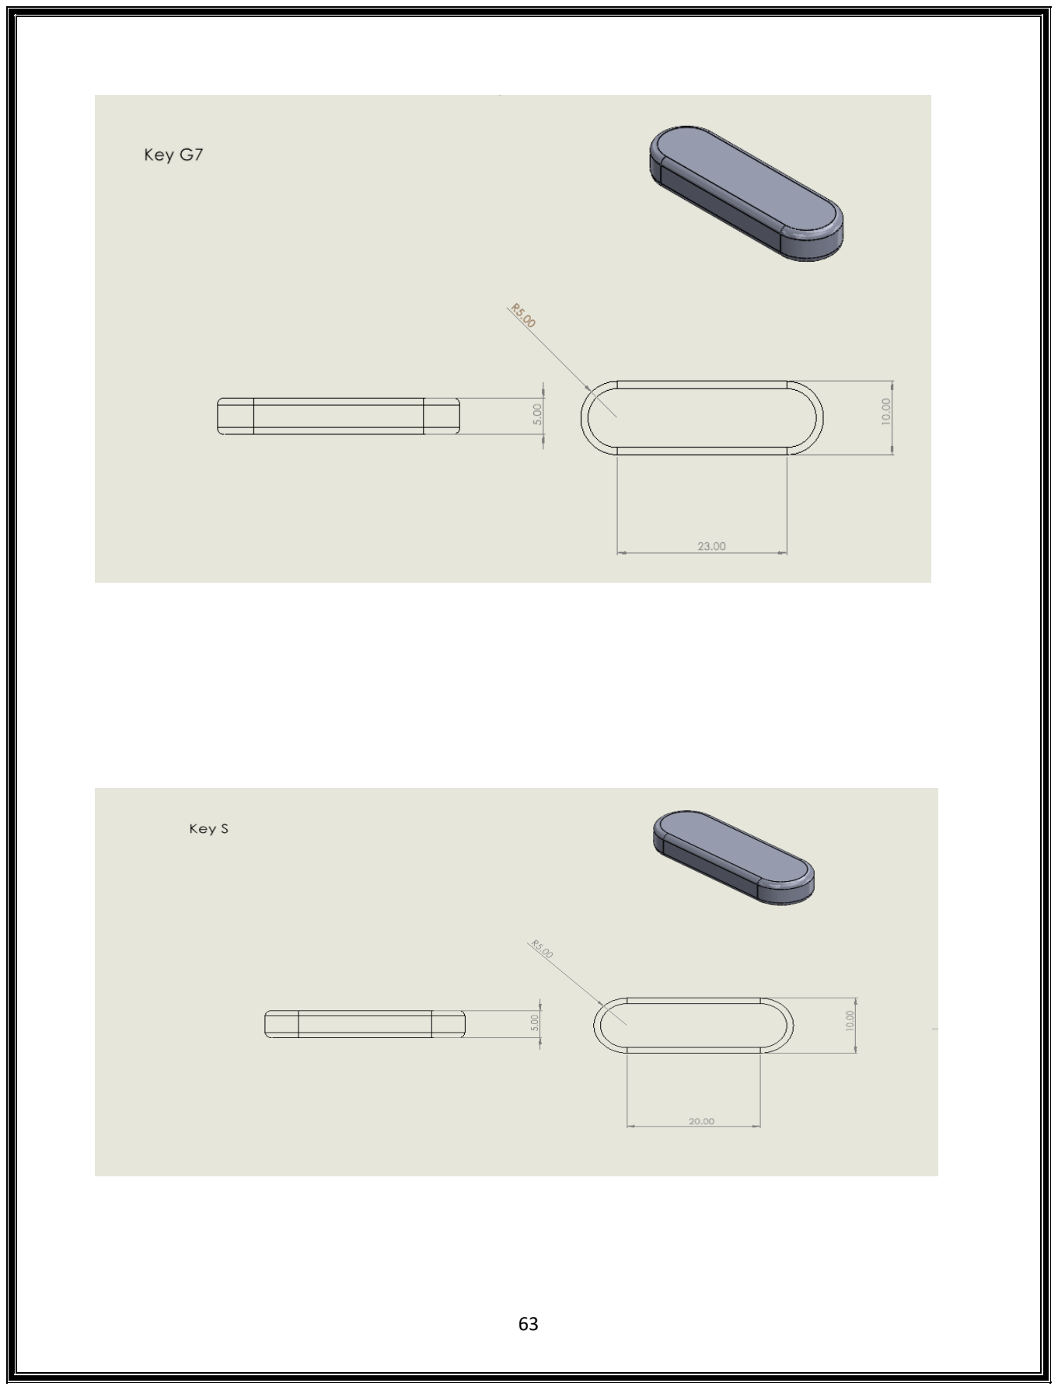
[picture p60: page 63]

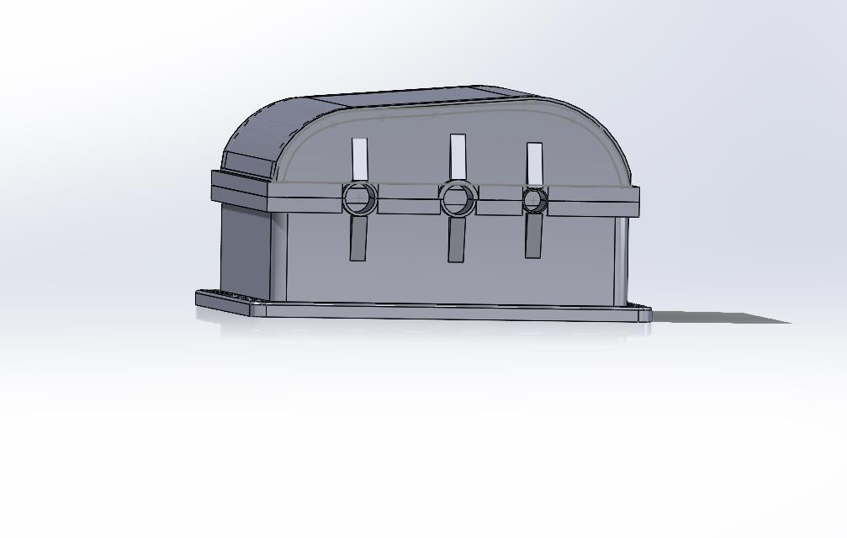
[picture p61: figure]

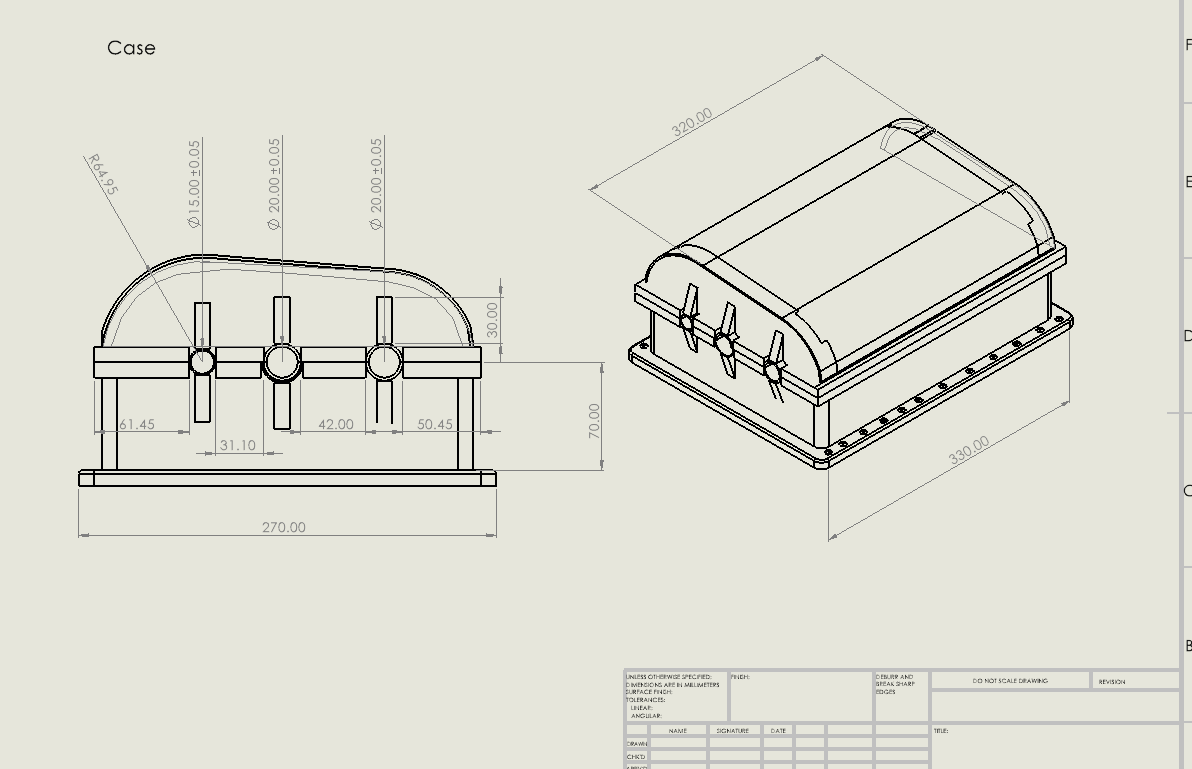
[picture p62: figure]
