ReyhaneNikoobayan/Design-Gearbox/Phase 3/assignment&report/gearbox phase(3).pdf

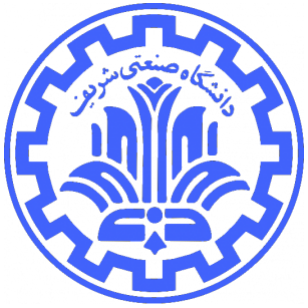
[picture p63: figure]

1

## به نام خدا

## دانشکده مهندسی مکانیک

## فاز سوم پروژه گیربکس

## استاد درس: دکتر امیر نورانی

## نگارش:

## ریحانه نیکوبیان 99106747

## ایمان شهروی 98106661

## زمستان 1401

2

فهرست

.1چکیده3----------------------------------------------------------------------

.2فرضیات4---------------------------------------------------------------------

.3طراحی تسمه و پولی5-----------------------------------------------------------

.4طراحی سیستم زنجیر و چرخ زنجیر13-----------------------------------------------

.5محاسبات قیمت20---------------------------------------------------------------

.6منابع21------------------------------------------------------------------------

.7پیوست22-----------------------------------------------------------------------

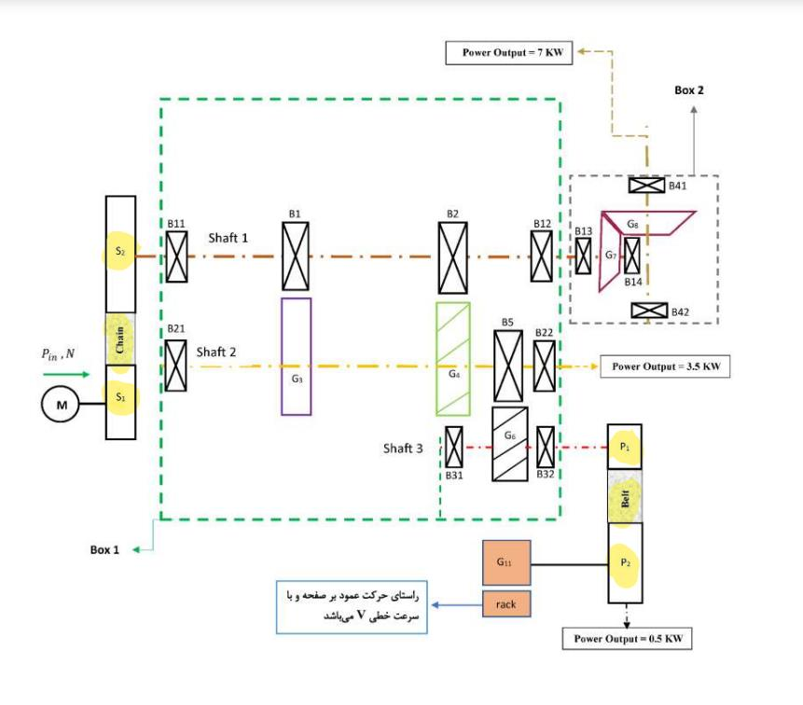
[picture p64: figure]

3

.1چکیده

در این فاز قصد داریم برای گیربکسی که در فاز های یک و دو طراحی کردیم، سیستم انتقال قدرت با تجهیزات انعطاف پذیر که شامل تسمه و پولی، زنجیر و چرخ زنجیر میباشد طراحی کنیم.در فاز های قبلی برخی فرضیات درباره پولی و چرخ زنجیر داشتیم که در قسمت فرضیات این پروژه به صورت کامل آورده شده است. روند انتقال قدرت به سیستم ما به این گونه است که ابتدا توان از یک موتور الکتریکی 3 فاز از نوع 2000 )این فرض در صورت سوال پروژه یک مطرح شده بود( به چرخ زنجیر کوچک (1S (وارد میشود و سپس توسط زنجیر به چرخ زنجیر بزرگ (2S (که روی شفت اول ما قرار دارد انتقال پیدا میکند.این مقدار توان با توجه به داده های پروژه اول، برابر KW11 میباشد. بخشی از این توان که برابر KW0.5 میباشد توسط شفت سوم به پولی کوچک (1P (داده شده و از آنجا توسط تسمه به پولی بزرگ (2P (انتقال پیدا میکند که این توان را به سیستم رک و پینیونی که در فاز یک طراحی کردیم میدهد.

4

فرضیات )با ذکر محل آن ها در فاز های قبلی(:

-1از الکتروموتور سه فاز 2000 استفاده شده است.)داده صورت پروژه فاز اول قسمت ملزومات طراحی-مورد1(

-2نسبت تبدیل زنجیر و چرخ زنجیر برابر 3.75 در نظر گرفته شده است.)فاز اول پروژه-صفحه3(

*توضیح درباره فرض باال: همانطور که در کتاب شیگلی بیان شده از زنجیر میتوان برای نسبت تبدیل های باال تا 1:6 استفاده کرد و در فاز اول نیر با توجه به سرعت شفت ها و همچنین توانی که میخواستیم روی چرخدنده ها اعمال شود، نسبت تبدیل باال را انتخاب کردیم.

-3نسبت تبدیل پولی و تسمه برابر 4 در نظر گرفته شده است.)فاز اول پروژه-صفحه 17(

*توضیح درباره فرض باال: در صورت پروژه فاز اول سرعت رک در بازه 18 تا 23 s/cm خواسته شده بود که ما مقدار میانگین ینی s/cm 20 را برای رک انتخاب کردیم. سپس در طراحی پینیون سیستم، قطر آن برابر mm63 بدست آمد.)صفحه -14فاز اول پروژه( در نتیجه چون ω×r=V آنگاه سرعت دورانی پینیون که همان سرعت دورانی 2P میباشد برابر s/rad6.34 =ω بدست آمد.(فاز اول پروژه- صفحه 14(

چون سرعت دورانی نسبتا پایین است)به علت پایین بودن سرعت رک( ما نسبت تبدیل را کمی باال بردیم تا سرعت دورانی شفت سوم خیلی کم نشود و نسبت تبدیل بین شفت دو و سه زیاد نشود.این یک فرض مهندسی برای جلو گیری از اوردیزاین چرخ دنده 6G روی شفت سوم بود. سرعت پولی کوچک که به شفت سوم متصل است برابر rpm242.16= s/rad 25.36=4×6.34 میشود.

-4 سیستم زنجیر و چرخ زنجیر KW11 و سیستم پولی و تسمهKW0.5 توان را انتقال میدهند.)داده های فاز اول پروژه(

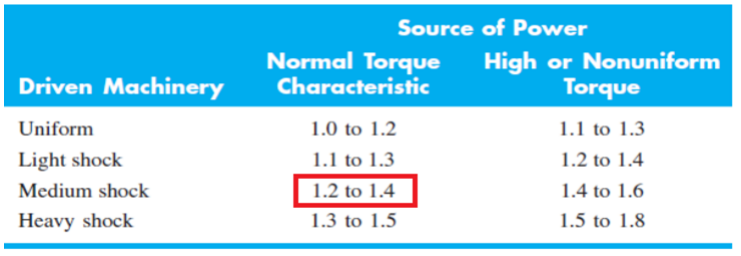
[picture p65: figure]

5

طراحی تسمه و پولی:

-1*از تسمه V شکل استفاده کرده ایم. از آنجایی که سیستم پولی و تسمه توان چندان زیادی منتقل نمیکند(W500 (، همچنین به تسمه ای با عمر باال و قیمت پایین نیاز داریم ، از تسمه V شکل برای طراحی تسمه این سیستم استفاده میکنیم. مهم ترین دلیل این انتخاب عرض کمتر تسمه V شکل نسبت به تسمه تخت لست که فضای کمتری را اشغال میکند زیرا از این سیستم تنها برای انتقال توان به یک سیستم رک و پینیون آن هم با توان پایین استفاده میشود و معقول نیست که از یک سیستم پولی و تسمه بزرگ استفاده کنیم.

*همانطور که در فرضیات اشاره شده بود،موتور الکتریکی را یونیفرم در نظر میگیریم و چون دستگاه در خط مونتاژ یک کارخانه استفاده میشود و در مورد نحوه بارگذاری اطالعات بیشتری در داده های اولیه ی پروژه نیست،ما برای اینکه کمی محافظه کارانه نیز عمل کرده باشیم،شوک و ضربات را متوسط در نظر میگیریم. ضریب طراحی را میانگین ضریب طراحی های معمول برای تسمه و پولی که برابر 1.2= nd میباشد در نظر گرفته ایم. از داده های پروژه داشتیم که دستگاه دو شیفت 6 ساعته ینی 12 ساعت فعالیت دارد،بنابراین Ks یا همان ضریب سرویس را برابر میانگین بازه ی داده شده در جدول ینی 1.3= Ks در نظر میگیریم.

جدول-1ضریب سرویس برای تسمهV شکل

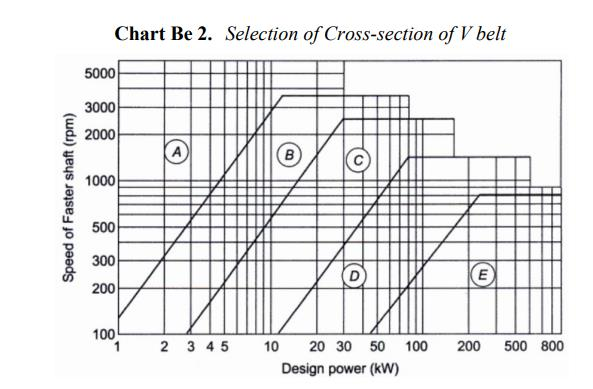
[picture p66: figure]

6

-2 توان مطلوب Hd را بدست میاوریم:

0.5×1.3×1.2 = 0.78 KW
ωP1 = ωshaft3 = 242.16 rpm
-3 با توجه به جدول 2Be نوع تسمه را بر حسب توان مطلوب انتخاب میکنیم:

با توجه به توان بدست آمده ما تسمه نوع A را انتخاب میکنیم.

نمودار-1انتخاب نوع تسمه بر حسب توان مطلوب و دور

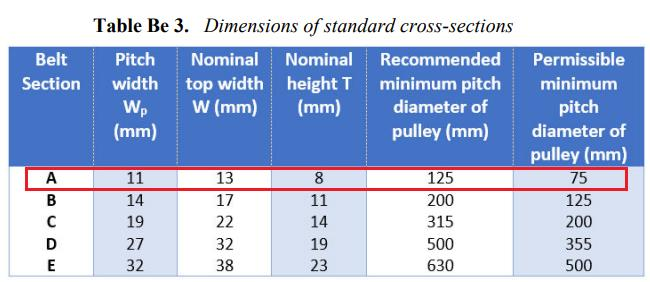
[picture p67: figure]

7

-4از جدول 3Be مشخصات مربوط به تسمه نوع A را بدست میاوریم:

حداقل قطر پولی کوچک: mm 125=d

با توجه به نسبت تبدیل که برابر 4 میباشد: mm 500 = D

-5فاصله ی بین مراکز شفت را بدست میاوریم:

625 < C <1875

میانگین
→ C = 1000 mm
-6زاویه نشست پولی ها و طول گام تسمه را بدست میاوریم:
ϴd = π – 2× sin(D−d 2×c | ) = π – 2× sin(⁵⁰⁰⁻¹²⁵
2×1000

) = 2.77 rad = 158.64°
ϴD = π + 2× sin(D−d 2×c | ) = π + 2× sin(⁵⁰⁰⁻¹²⁵
2×1000

) = 3.518 rad = 201.61°

L = √4 × 1000² − (500 − 125)
2 +

1
2

( 500×3.518 + 125×2.77) = 3017.154 mm

طول داخلی تسمه:

Li = L – Lt
Lt را از جدول زیر بدست میاوریم:

جدول-2مشخصات تایپ های متفاوت تسمه V شکل

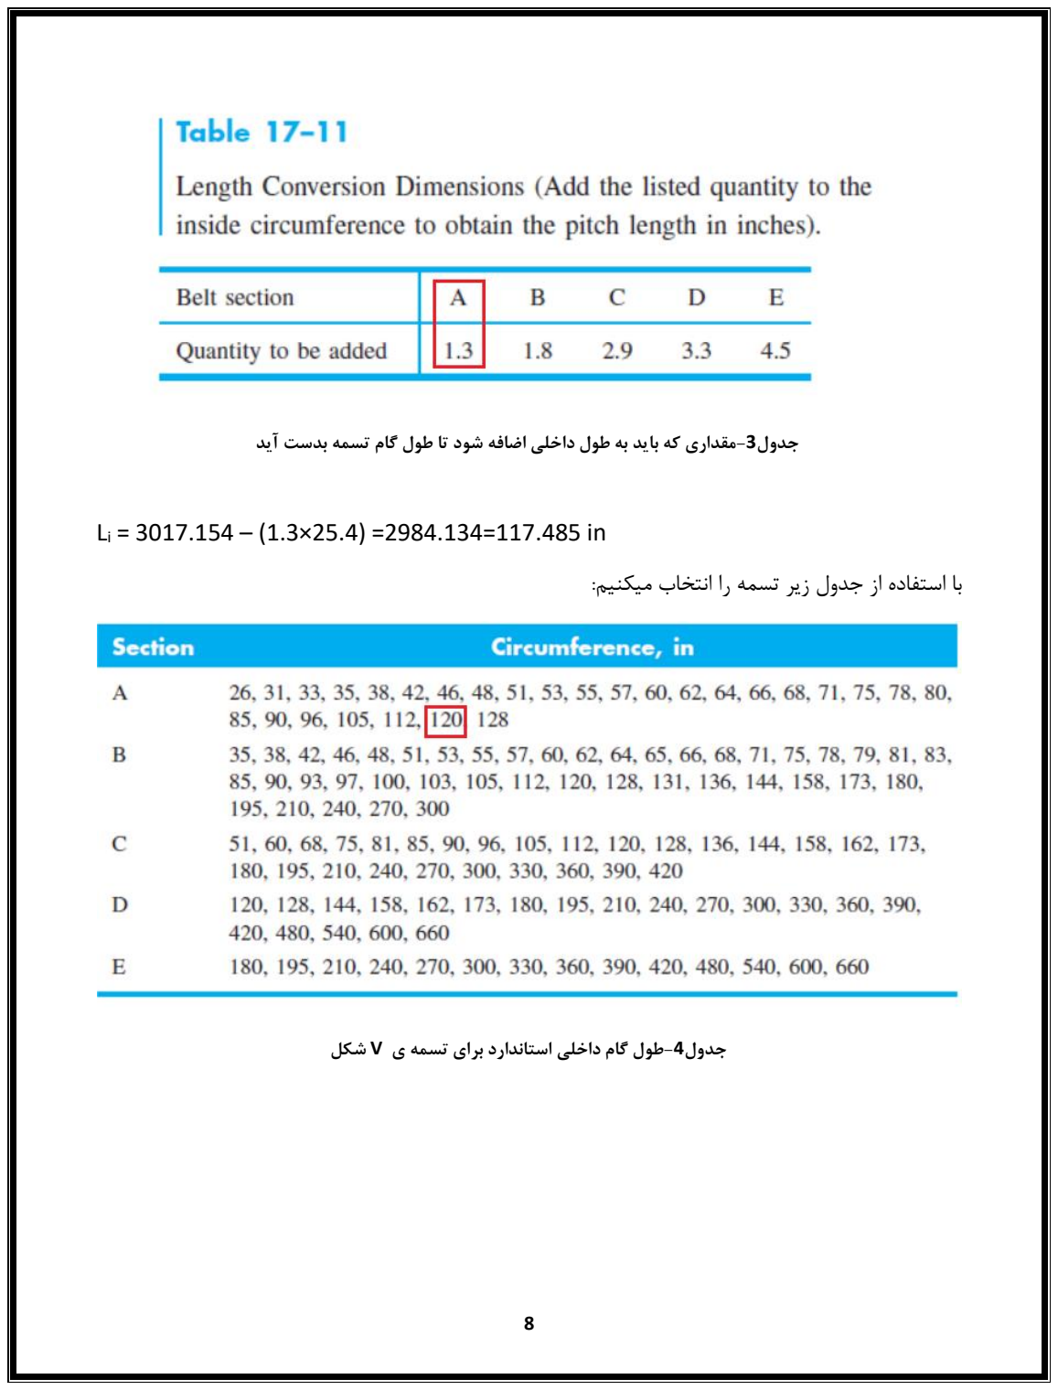
[picture p68: page 8]

8

Li = 3017.154 – (1.3×25.4) =2984.134=117.485 in
با استفاده از جدول زیر تسمه را انتخاب میکنیم:

جدول-3مقداری که باید به طول داخلی اضافه شود تا طول گام تسمه بدست آید

جدول-4طول گام داخلی استاندارد برای تسمه ی V شکل

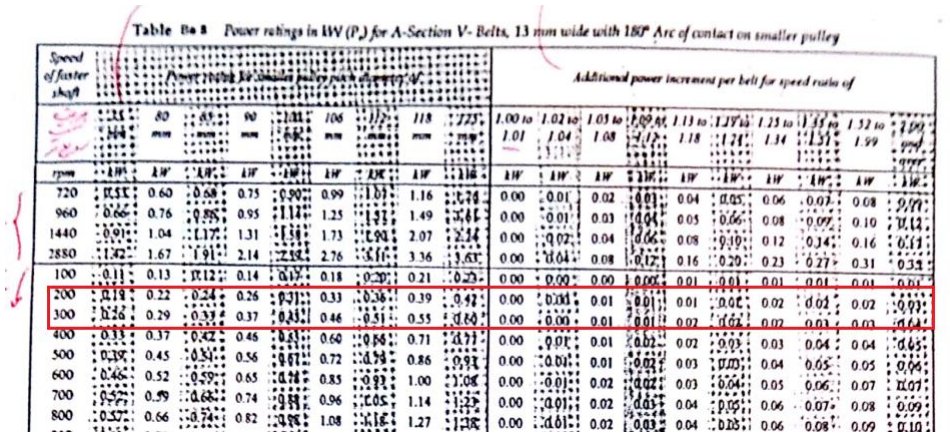
[picture p69: figure]

9

-7 تعداد تسمه را مشخص میکنیم:

ابتدا Htab یعنی توان قابل انتقال را از روی جدول برای تسمه ی A میخوانیم:

دور rpm242 مقداری بین دو مقدار داده شده در جدول برای سرعت های 200 و 300 دارد:

Htab = 0.51 + 0.035 = 0.545
Htab 2K1K :(توان قابل انتقال تسمه( Ha

جدول-5توان قابل انتقال برای تسمه ی V تایپ A

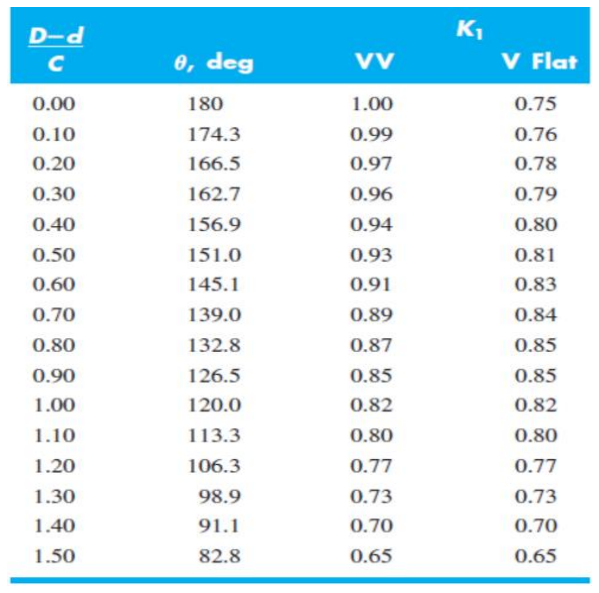
[picture p70: figure]
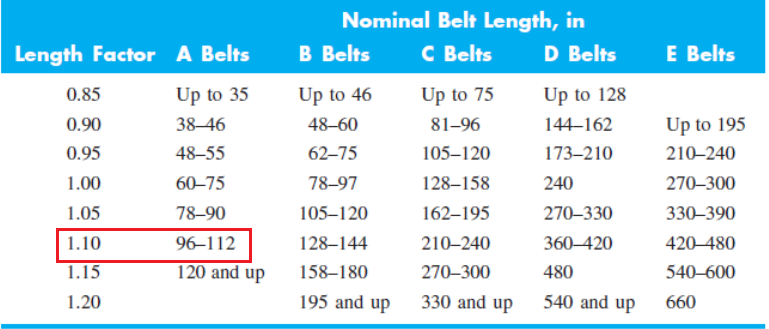
[picture p71: figure]

10

: K1

D−d
C

=

375
1000

)میان یابی( 0.945 = 1K→

: K2

K2 = 1.1

جدول-6ضریب تصحیح زاویه تماس

جدول-7ضریب تصحیح طول تسمه

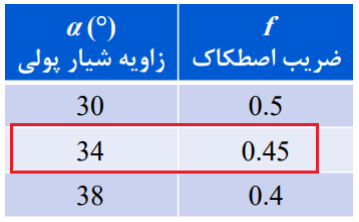
[picture p72: figure]

11

Ha =1.1×0.945×0.545 = 0.634 KW

Nb >=

Hd
Ha

تعداد تسمه برابر 2 میباشد. → 1.2 =

-8 FC و T را بدست میاوریم:

V = rω = ¹²⁵mm
2

×

1 in
25.4 mm

×

1 ft
12 in

× 242 ×

2π
1 rev

= 311.788 ft
min
Kc = 0.561 → FC = KC (

V
1000

)

2 → FC = 0.0545 lbf

برای زاویه ی شیار پولی چون دیتای خاصی داده نشده،فرض را برمیانگین ینی 34 درجه میگذاریم:

f’ = f
sinα
2

= 1.539

T =

Hd
ω

=

0.78×1000
242.16×

2π
60
= 30.758 N.m → | تسمه | دو → T = 15.379 N.m

F1 – F2 =

2T
d

=

2×15.379
0.125

= 246 × ⁰.225 lbf
1 N

=55 lbf

F1−FC
F2−FC

= exp(f’φ) → φ = ϴd → F1−0.0545
F2−0.0545

= 70.372 lbf

F1 = 55.847 lbf
F2 = 0.847 lbf

جدول-8ضریب اصطکاک بر حسب زاویه ی شیار پولی برای تسمه ی V

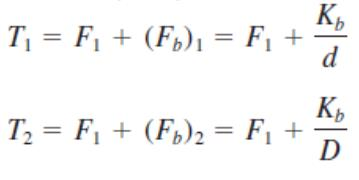
[picture p73: figure]
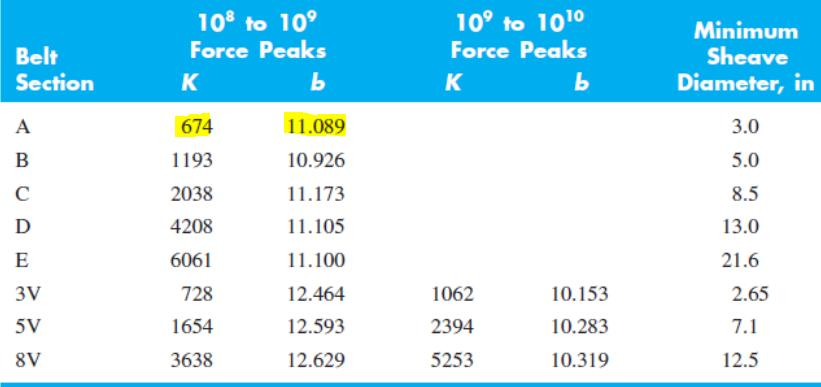
[picture p74: figure]

12

-9 عمر تسمه را محاسبه میکنیم:

T1 = 55.847 + 220
125
25.4

= 100.551

T2 = 55.847 + 220
500
25.4

= 67.023

10⁹ = NP1 = 1.45 ×

K
T

)

b Np = (

NP2 = 1.306 × 10¹¹
عمر بی نهایت

جدول-9ثوابت مربوط به طول عمر تسمه

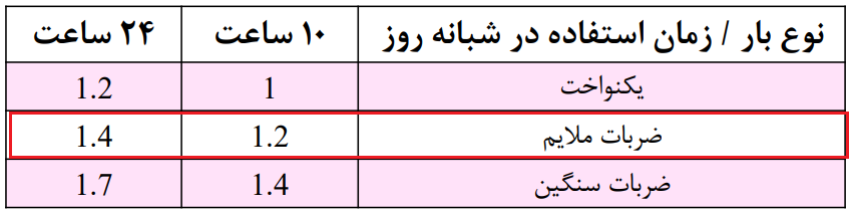
[picture p75: figure]

13

طراحی سیستم زنجیر و چرخ زنجیر:

-1 ابتدا توان مطلوب سیستم را بدست میاوریم:

Hd = Hnom Ks nd
با توجه به توضیحاتی که در قسمت قبل درباره ضریب طراحی و ضریب سرویس داده شد،از جدول مربوط به زنجیر داریم:

Ks = 1.3 , nd =1.2

Hd = 11×1.3×1.2 = 17.16 KW
-2 تعیین تعداد دندانه:

*محدودیت فضایی خاصی بیان نشده و اگر تعداد دندانه ها کم باشد،طبق جزوه ما افزایش تغییرات سرعت و دامنه نوسان رولرها را روی چرخ زنجیر خواهیم داشت.بنابر این تعداد دندانه ها را عدد 21 میگیریم که هم از تغییرات سرعت و نوسان جلوگیری کنیم و هم از پدیده شکارچی جلوگیری کنیم.

79= 2N → 78.75 → 21 × 3.75 → نسبت تبدیل برابر 3.75 → 21 = 1N

-3 همانطور که در کالس بیان شد،ابتدا فرض میکنیم زنجیر یک ردیفه است:

جدول-10ضریب سرویس برای زنجیر

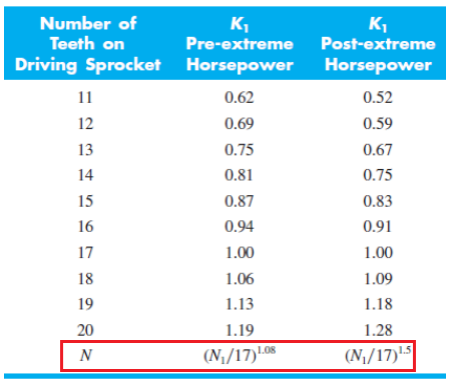
[picture p76: figure]
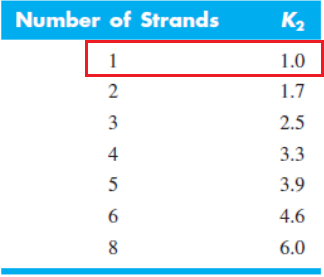
[picture p77: figure]

14

برای تعیین 1K در جدول باال بجای 1N 21 گذاشته و میانگین دو مقدار را به عنوان مقدار نهایی انتخاب میکنیم:

K1 = 1.256 , K1 =1.3145 → K1 = 1.285

K2 =1

جدول-11ضریب تصحیح تعداد دندانه

جدول-12ضرایب تعداد رشته

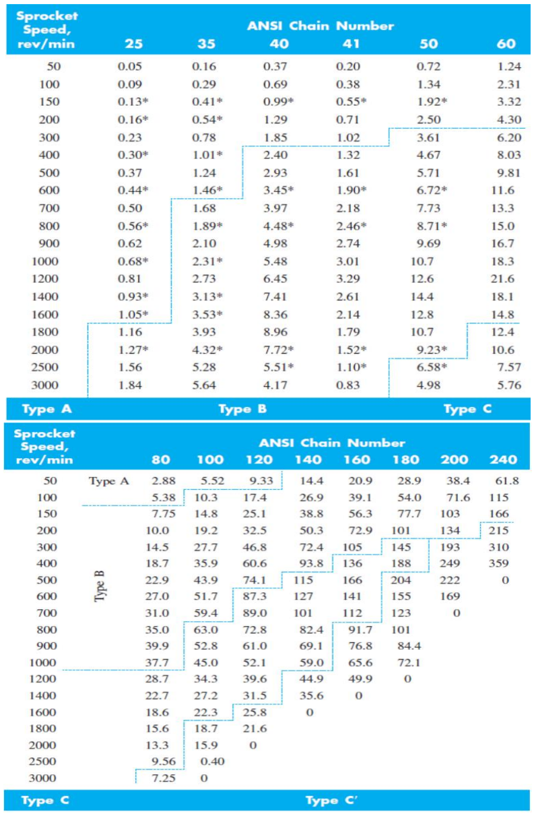
[picture p78: figure]

15

Htab =

Hd
K1K2

=

17.16
1.285×1

= 13.354 KW =17.9 hp

جدول-13تایپ روانکاری و نوع زنجیر بر حسسب توان اسب بخار

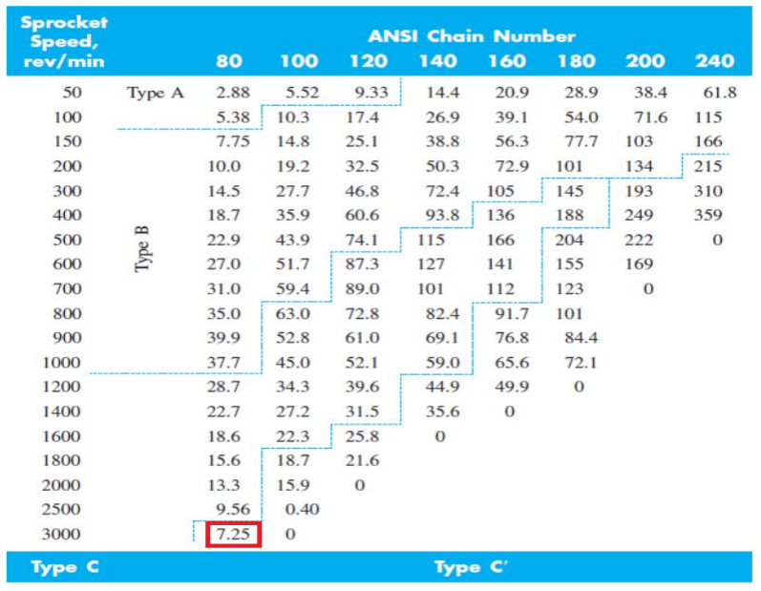
[picture p79: figure]

16

همانطور که میبینیم در جدول برای دور 3000 چنین توانی وجود ندارد بنابراین باید تعداد ردیف را افزایش دهیم:

دور ردیفه:

K2 =1.7

Htab =

Hd
K1K2

=

17.16
1.7×1.285

= 7.855 KW =10.53 hp

سه ردیفه:

K2 =2.5

Htab =

Hd
K1K2

=

17.16
2.5×1.285

= 5.34 KW =7.16 hp

این توان برای زنجیر تایپ ‘C 80ANSI موجود هست.مشکل اینجاست که تایپ ‘C تایپ متداولی نیست بنابر این برای اینکه بدانیم آیا طراحی زنجیر با این تایپ اصولی است یا خیر،نظر استاد را پرسیدیم که در زیر آورده شده است:

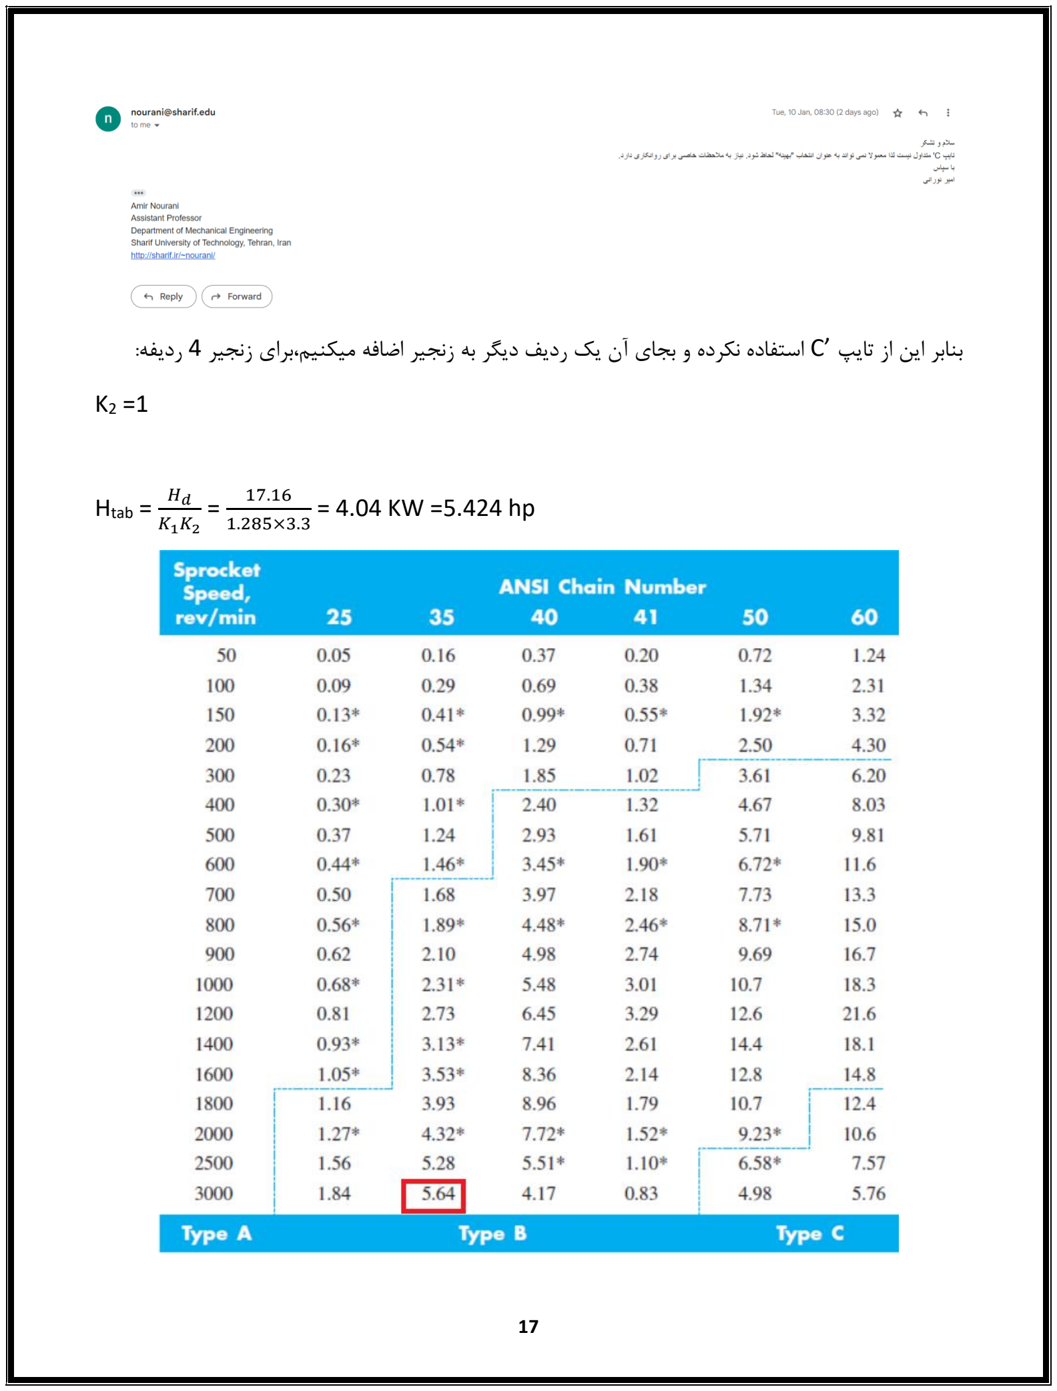
[picture p80: page 17]

17

بنابر این از تایپ ‘C استفاده نکرده و بجای آن یک ردیف دیگر به زنجیر اضافه میکنیم،برای زنجیر 4 ردیفه:

K2 =1

Htab =

Hd
K1K2

=

17.16
1.285×3.3

= 4.04 KW =5.424 hp

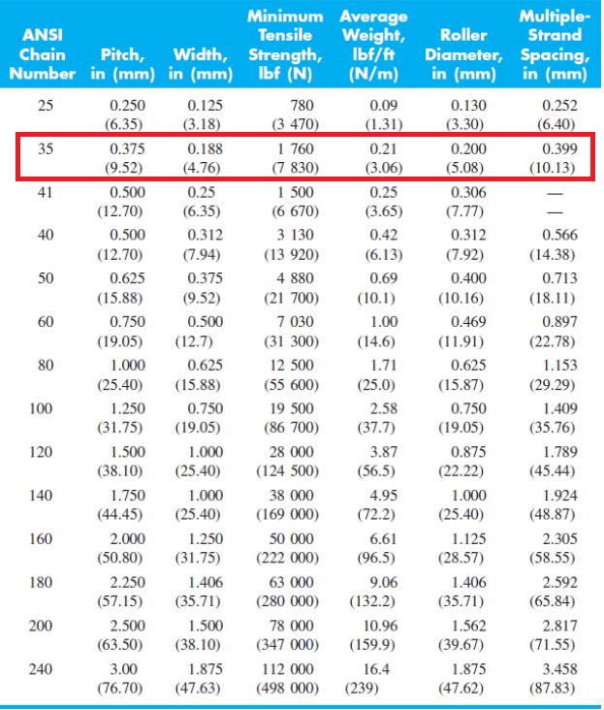
[picture p81: figure]

18

-4بنابراین زنجیر انتخابی ما typeB 35ANSI میباشد.

= واقعیnd

K1K2Htab

KsHnom

=

1.285×3.3×5.64
1.3×14.7453

= 1.247

جدول-14مشخصات زنجیرهای ANSI

19

-5بدست آوردن طول زنجیر:

مقدار میانگین را برای فاصله شفت ها انتخاب میکنیم. → P50 < C < P30 → 0.375 =P : طول گام

C = 40P → C = 40(0.375) = 15in

L
p

=

2×15
0.375

+

21+79
2

+

(79−21)

2

4π²

C
p

= 80 + 50 + 2.13 = 132.13 ≅ 132

131 زنجیر و 1 قفل.

-6 بدست آوردن قطر چرخ زنجیرها:

D1 =

P
sin(

180
N1

)

=

0.375
sin(

180
21

)

= 2.516 in = 63.9 mm

D2 =

P
sin(

180
N2

)

=

0.375
sin(

180
79

)

= 9.432 in = 240 mm

20

محاسبات قیمت:

طبق آخرین قیمت های امروز 22 دی ماه 1401 ، در سایت com.sanatbazar.www :

قیمت پولی cm-12.5M5 = 58000 تومان

قیمت پولی 500H که قطری برابرcm50 دارد = 276000 تومان

: www.famcocorp.com | سایت | در

یک رول 5 متری از تسمه vشکل تایپ A = 78000 تومان

: www.sanatbazar.com | سایت | در

چرخ زنجیر کوچک برای زنجیر 35 : 34,800 تومان

چرخ زنجیر بزرگ برای زنجیر 35 : 96000 تومان

زنجیر صنعتی چهار ردیفه تایپ A بسته سه متری : 1,960,000 تومان

بنابر این مجموع هزینه تجهیرات انعطاف پذیر برابر دومیلیون و پانصد و سه هزار تومان میباشد.

21

## منابع

## جزوه دکتر امیر نورانی

## کتاب طراحی اجزای شیگلی-ویرایش دهم

www.sanatbazar.com

www.famcocorp.com

22

# پیوست ها

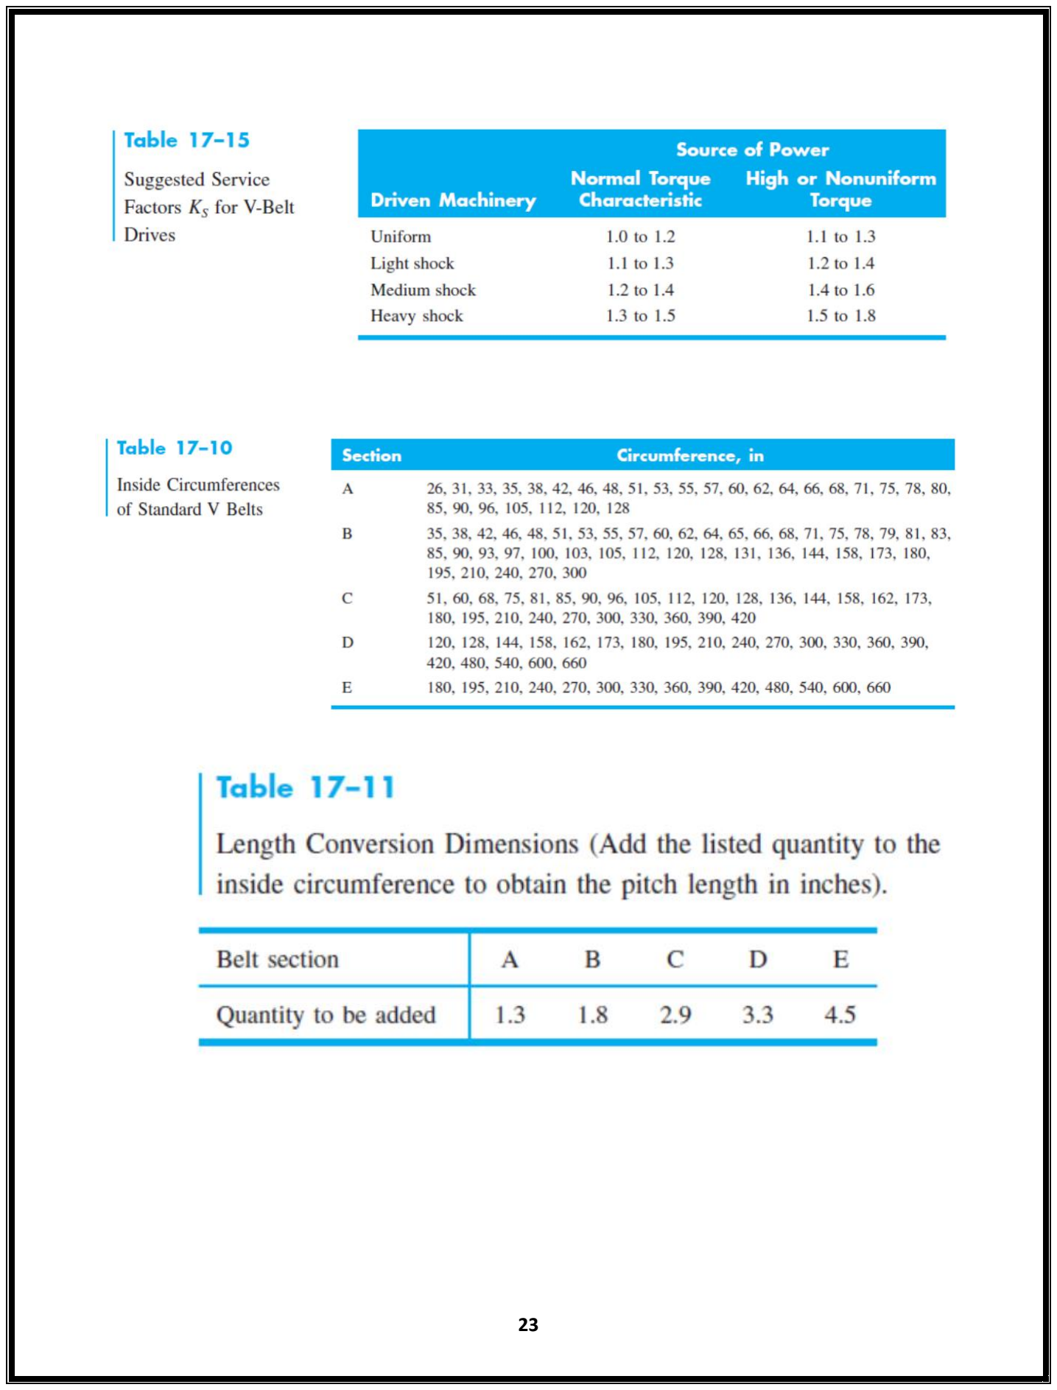
[picture p82: page 23]

23

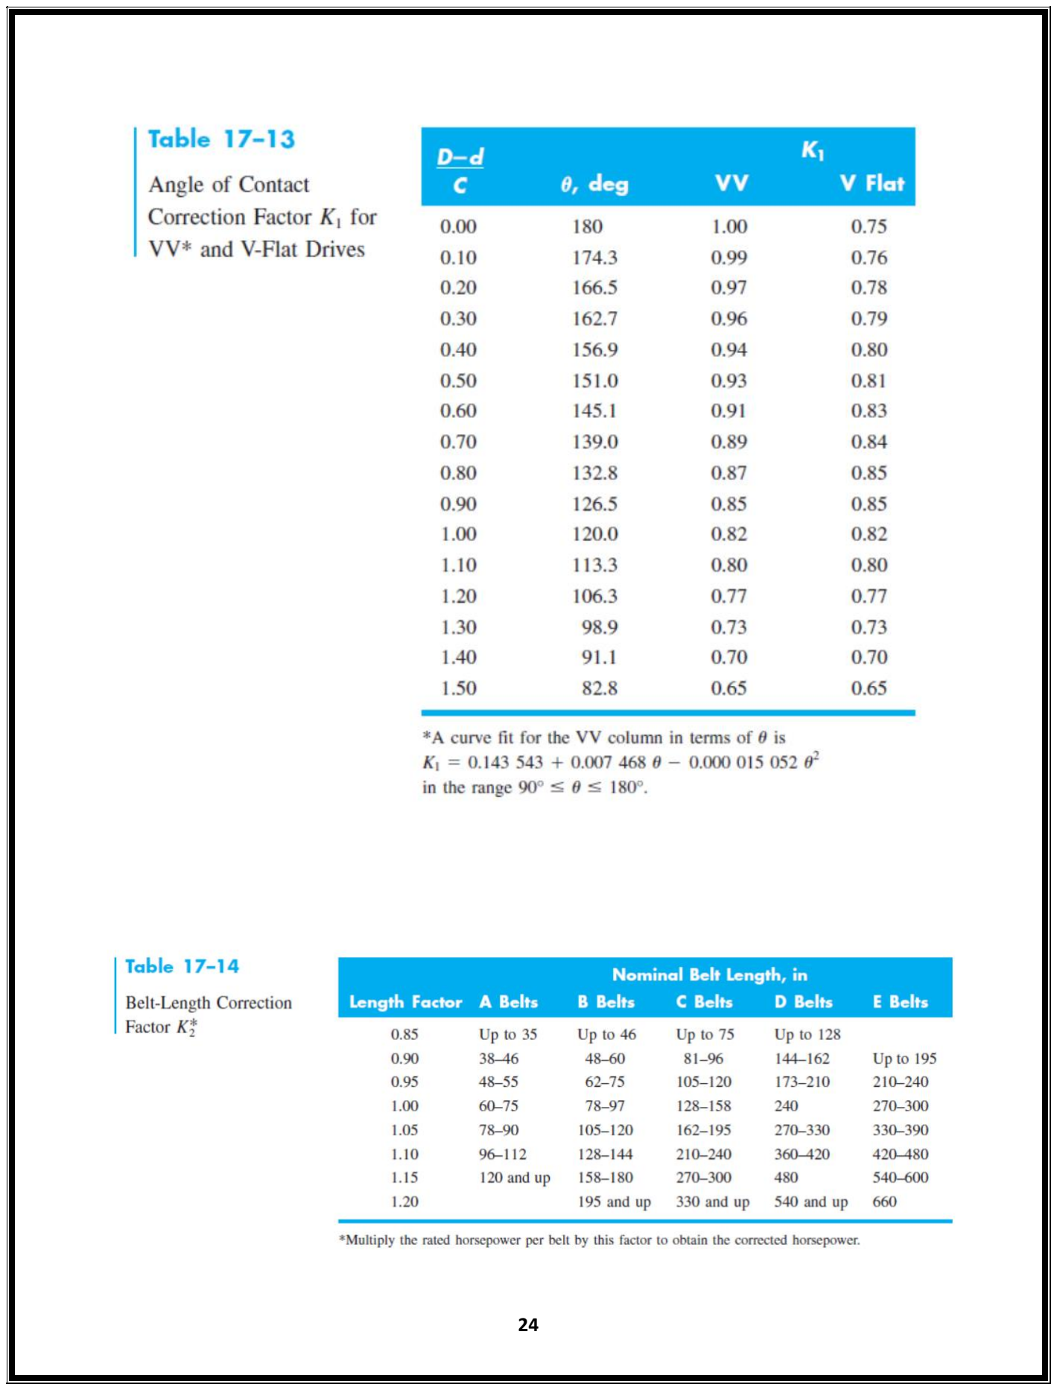
[picture p83: page 24]

24

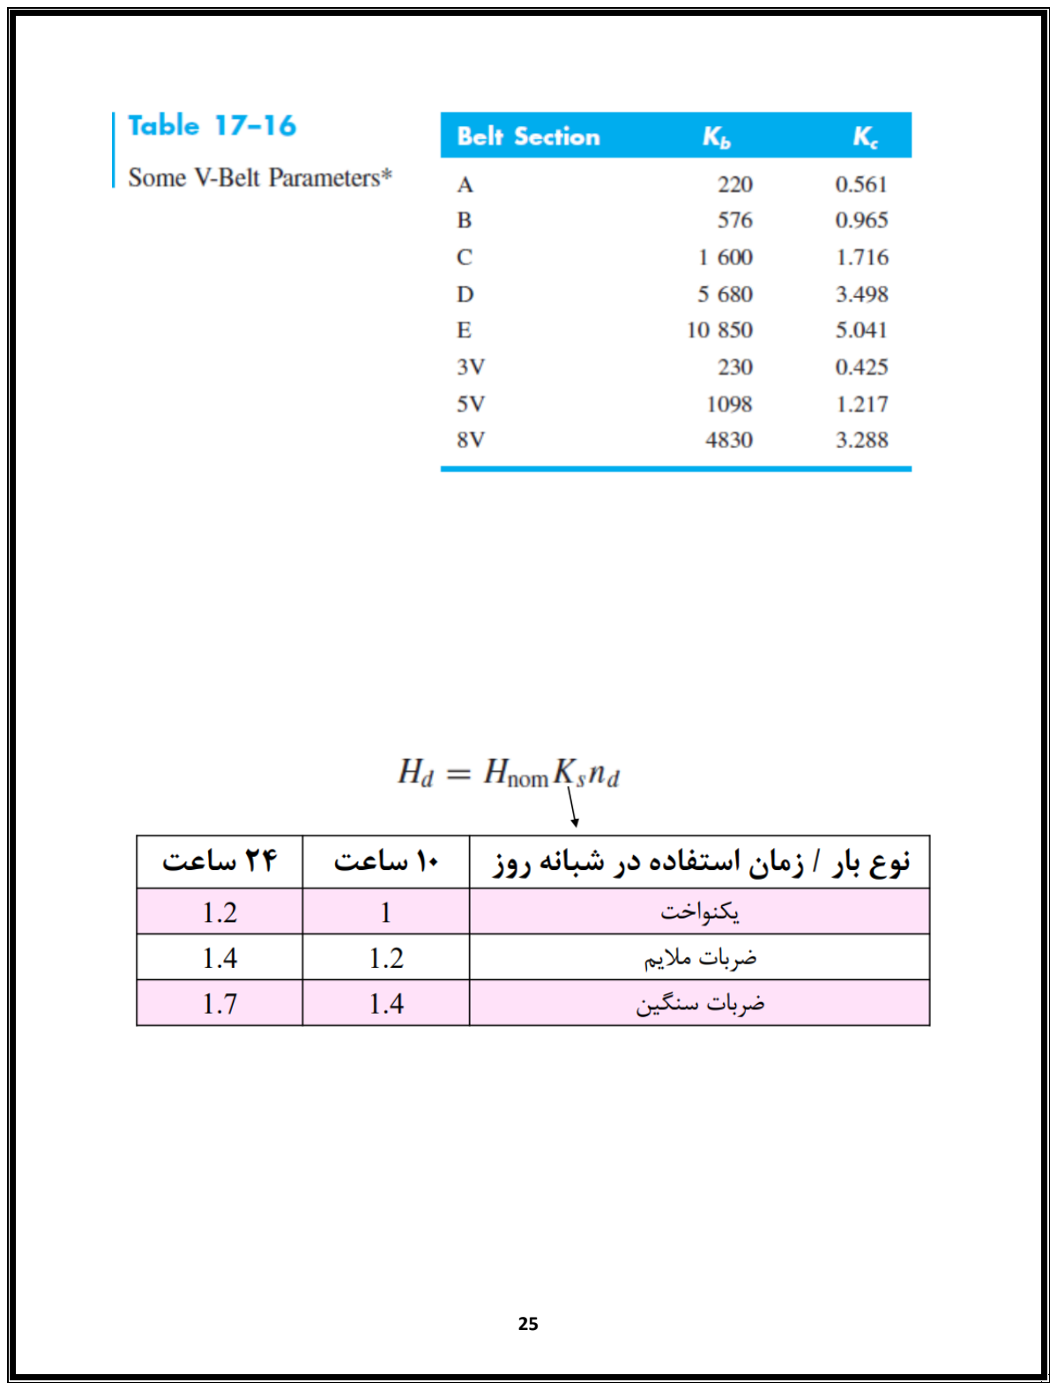
[picture p84: page 25]

25

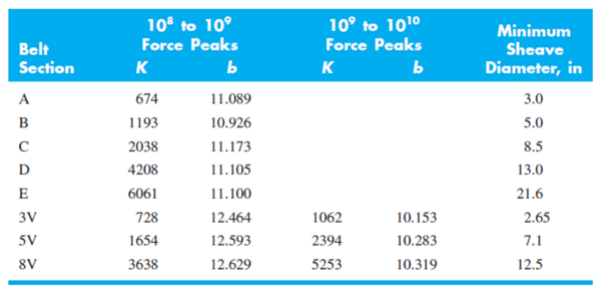
[picture p85: figure]
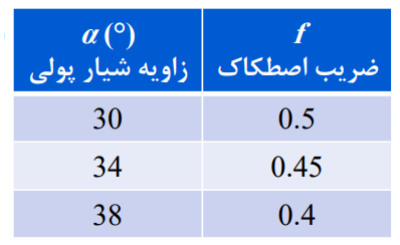
[picture p86: figure]

26

جدول مشخصات تسمه برای محاسبه طول عمر:

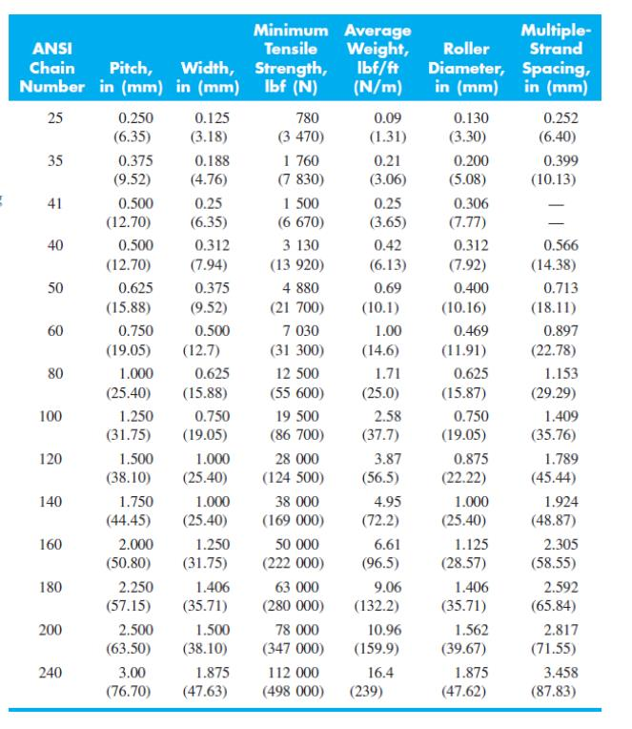
[picture p87: figure]

27

جدول مشخصات زنجیر هایANSI :

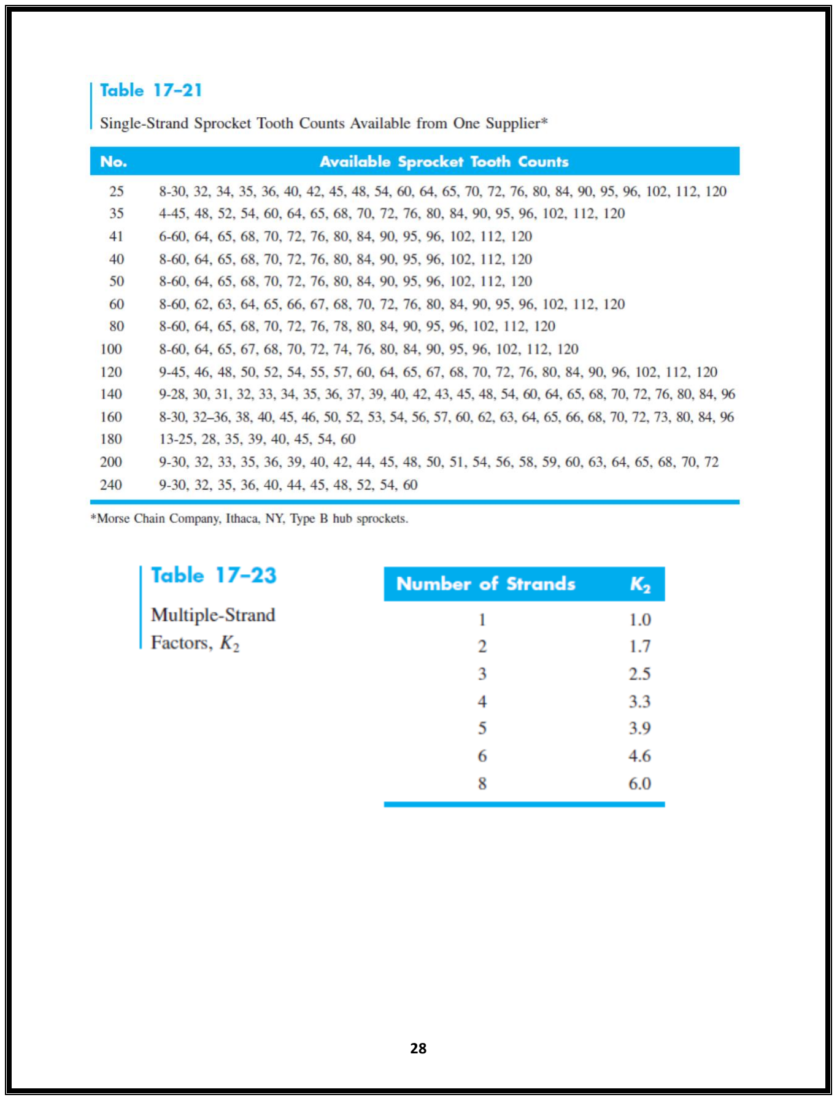
[picture p88: page 28]

28

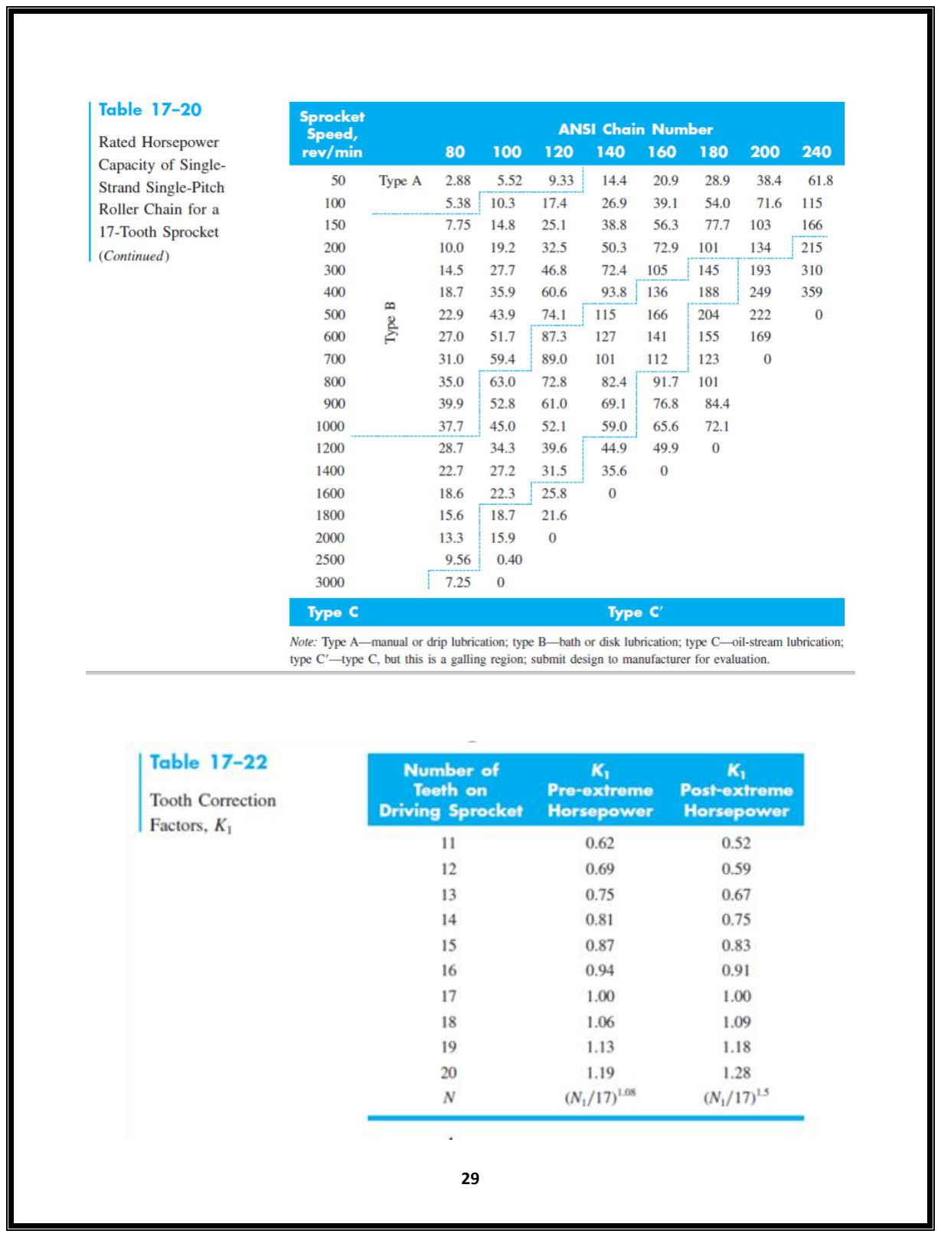
[picture p89: page 29]

29

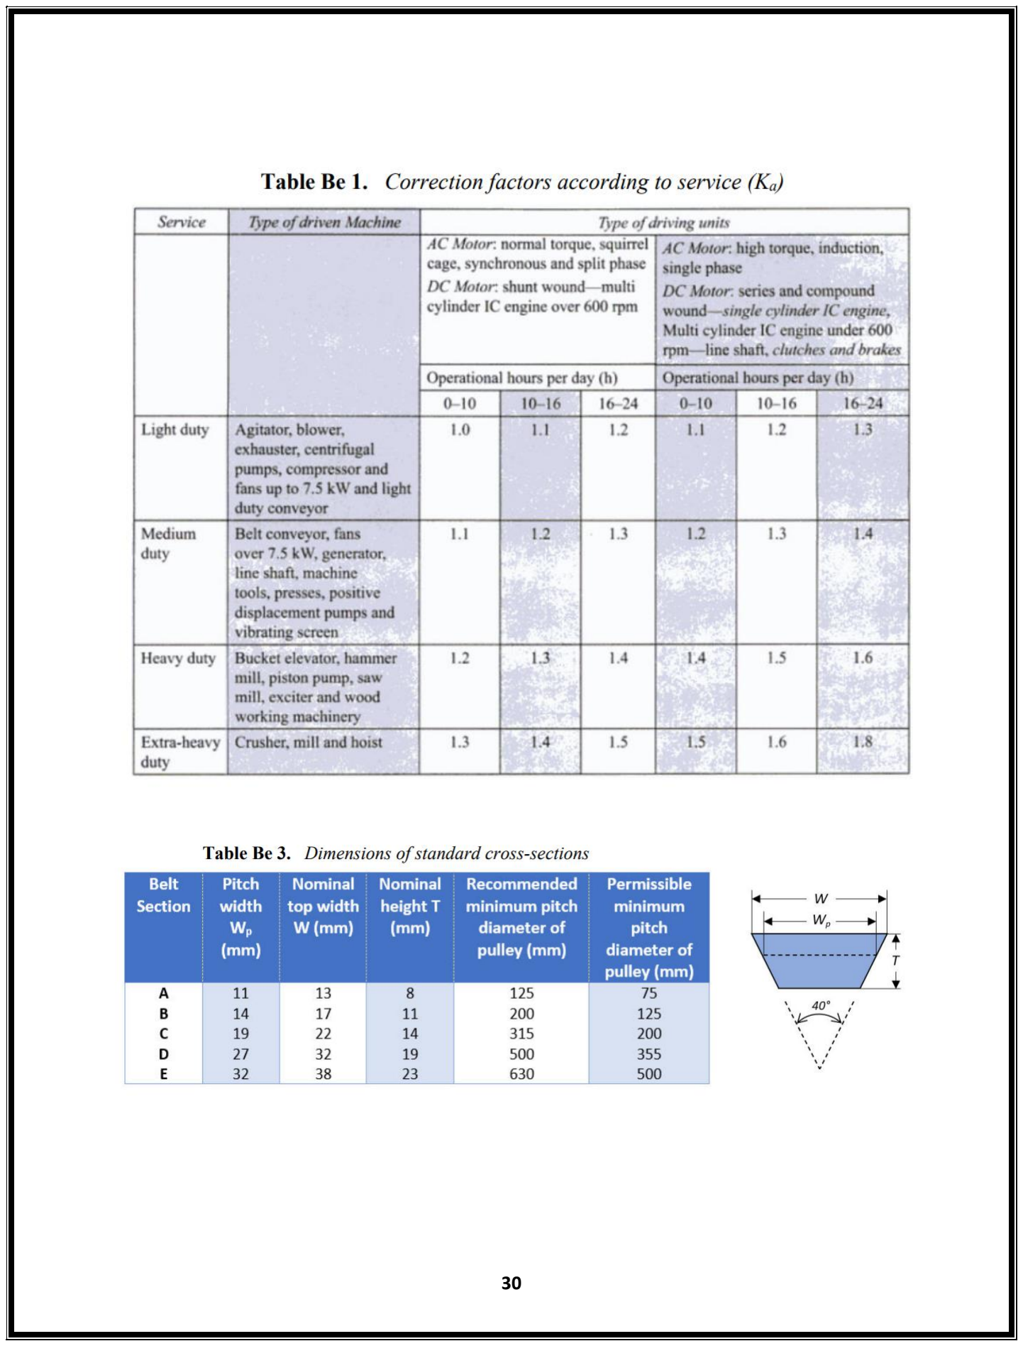
[picture p90: page 30]

30

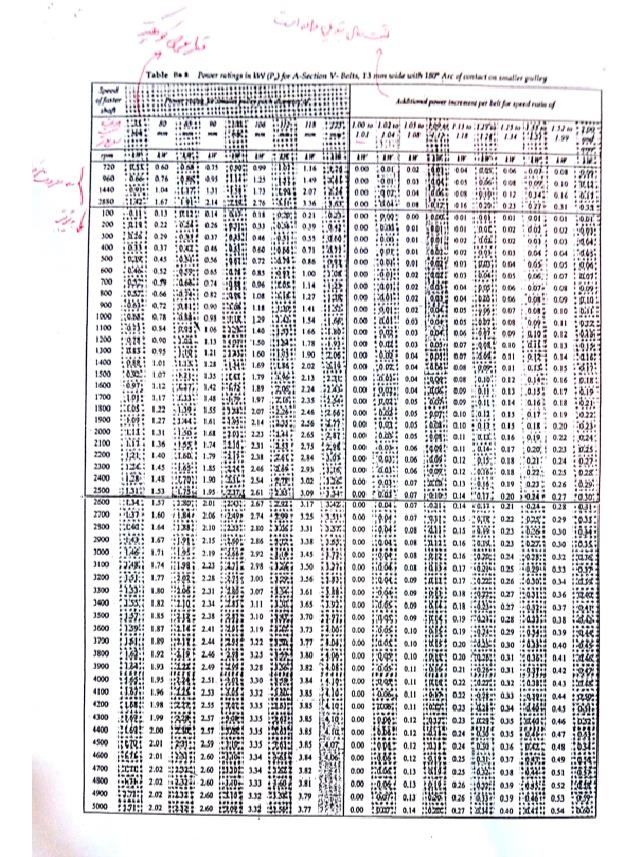
[picture p91: figure]

31
