ReyhaneNikoobayan/Design-Gearbox/Phase 2/solid part/step/case.STEP

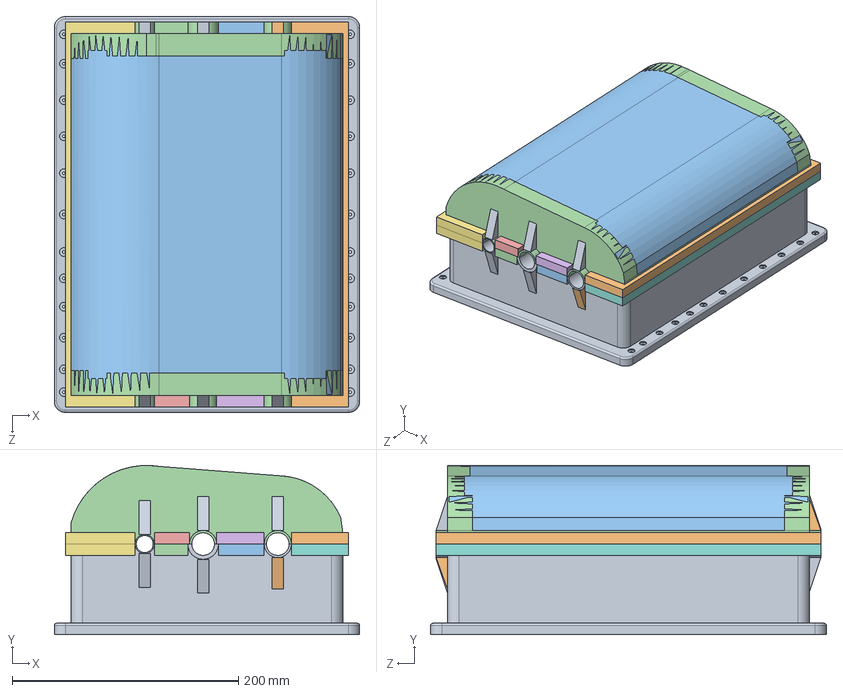
[picture p92: CAD file, 2024-10-25]
Phase 2/solid part/step/case.STEP
270.0 x 149.5 x 350.0 mm
case-1
case-1 copy
