ReyhaneNikoobayan/Design-Gearbox/Phase 2/solid part/step/shaft3.STEP

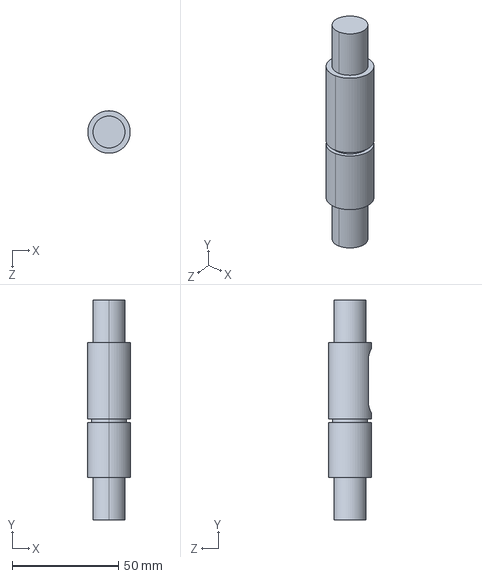
[picture p93: CAD file, 2024-10-25]
Phase 2/solid part/step/shaft3.STEP
20.0 x 103.5 x 20.0 mm
