ReyhaneNikoobayan/Design-Gearbox/Phase 2/solid part/step/shaft2.STEP

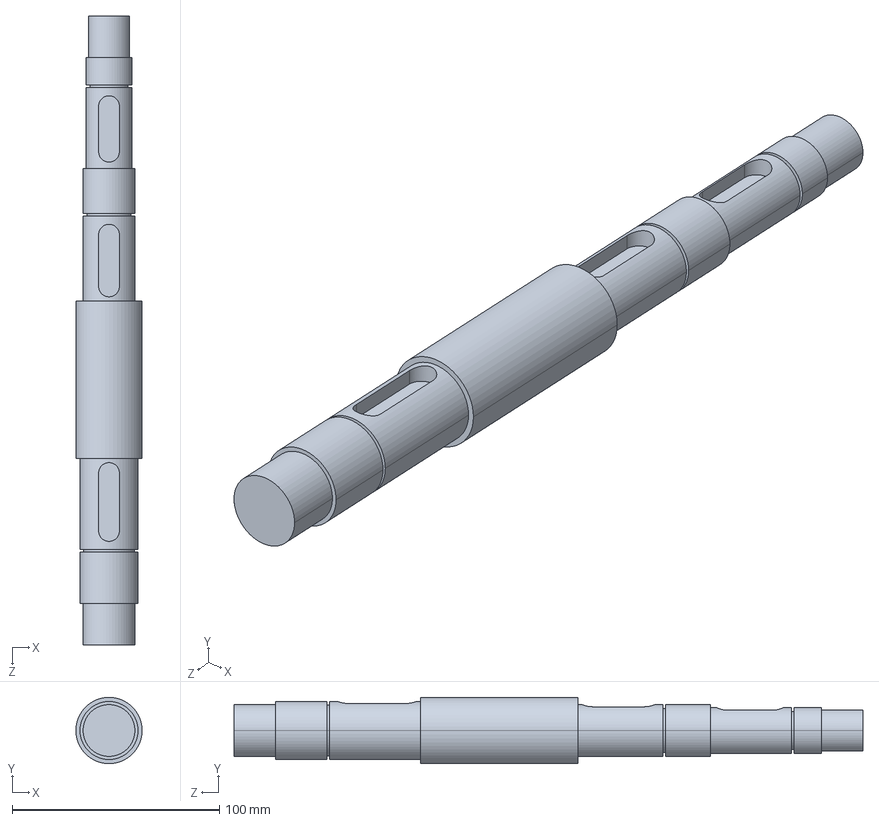
[picture p94: CAD file, 2024-10-25]
Phase 2/solid part/step/shaft2.STEP
32.0 x 32.0 x 303.5 mm
