ReyhaneNikoobayan/Design-Gearbox/Phase 2/solid part/step/key.STEP

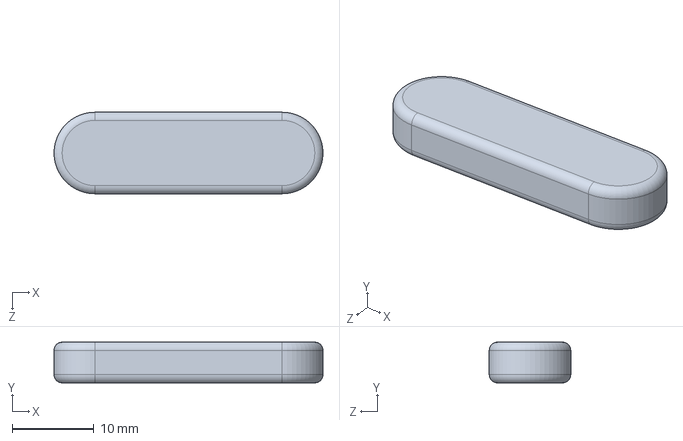
[picture p95: CAD file, 2024-10-25]
Phase 2/solid part/step/key.STEP
33.0 x 5.00 x 10.0 mm
