ReyhaneNikoobayan/Design-Gearbox/Phase 2/solid part/step/shaft1.STEP

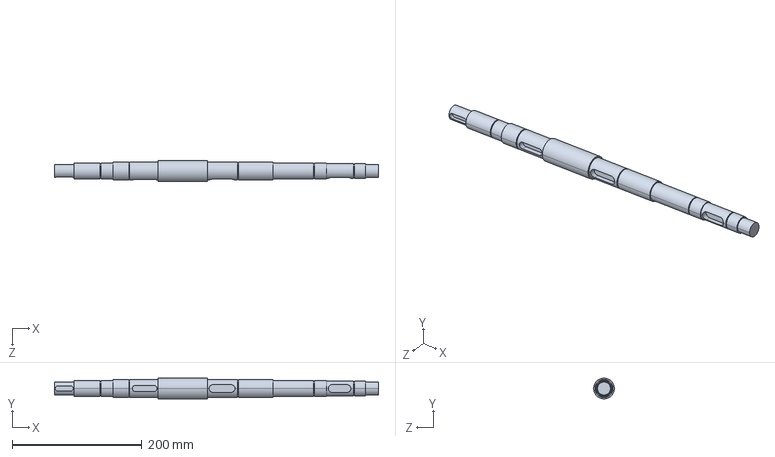
[picture p96: CAD file, 2024-10-25]
Phase 2/solid part/step/shaft1.STEP
500.0 x 32.0 x 32.0 mm
