ReyhaneNikoobayan/Design-Gearbox/(list of files, cad)

Other CAD files:
Phase 2/solid part/case.SLDASM
Phase 2/solid part/key.SLDPRT
Phase 2/solid part/shaft1.SLDPRT
Phase 2/solid part/shaft2.SLDPRT
Phase 2/solid part/shaft3.SLDPRT
